michaelerule/LED_weaving/..bfg-report/2019-12-09/09-10-23/protected-dirt/cc569d0e-HEAD.csv

61e5d1c7dbbaa4ed608dc6567c271158b0dd6b1d | DELETE | executable | Project 3: Fibonacci/Writeup/20191104 Dreamcatcher (release)/VIDEO0072.mp4 | 269396218
f38d6ff7a80835ee2333962d0d1b2a934238b434 | DELETE | executable | Project 3: Fibonacci/Writeup/20191104 Dreamcatcher (release)/VIDEO0076.mp4 | 115131531
61e5d1c7dbbaa4ed608dc6567c271158b0dd6b1d | DELETE | executable | Writeup/photos/Project 3: LED dreamcatcher/VIDEO0072.mp4 | 269396218
f38d6ff7a80835ee2333962d0d1b2a934238b434 | DELETE | executable | Writeup/photos/Project 3: LED dreamcatcher/VIDEO0076.mp4 | 115131531
