michaelerule/LED_weaving/.git.bfg-report/2019-02-25/20-42-36/protected-dirt/aedcd762-HEAD.csv

65685d20780cc8def26f9c46963e8c464c0f4426 | DELETE | regular-file | Project 2: Marquee/Writeup/f1.svg | 30105499
4fec8187e474a769d8fa46a0383afd3dd0d0fe7a | DELETE | regular-file | Writeup/photos/Project 1: LED bead weaving/edited/animation5.gif | 11728317
