michaelerule/LED_weaving/..bfg-report/2020-03-28/19-55-57/protected-dirt/d19214ed-HEAD.csv

83906acb50e0e2a363e65743ea2123b663d665cb | DELETE | executable | Project 3: Fibonacci/Writeup/Photos/VIDEO0073.mp4 | 91048813
acd16d0e0093ec77f44cc03282107ef1aa04a825 | DELETE | executable | Project 3: Fibonacci/Writeup/Photos/VIDEO0075.mp4 | 61095710
f7d0cec78d43c73a415e5d8093270312c2abc51d | DELETE | executable | Project 3: Fibonacci/Writeup/Photos/VIDEO0077.mp4 | 53519259
