michaelerule/LED_weaving/..bfg-report/2020-03-28/18-09-38/protected-dirt/f6025158-HEAD.csv

61e5d1c7dbbaa4ed608dc6567c271158b0dd6b1d | DELETE | executable | Project 3: Fibonacci/Writeup/Photos/VIDEO0072.mp4 | 269396218
f38d6ff7a80835ee2333962d0d1b2a934238b434 | DELETE | executable | Project 3: Fibonacci/Writeup/Photos/VIDEO0076.mp4 | 115131531
f38d6ff7a80835ee2333962d0d1b2a934238b434 | DELETE | executable | Project 3: Fibonacci/Writeup/VIDEO0076.mp4 | 115131531
