michaelerule/LED_weaving/Project 1: Bead Weaving/Writeup/Photos/edited/IMAG0462.jpg

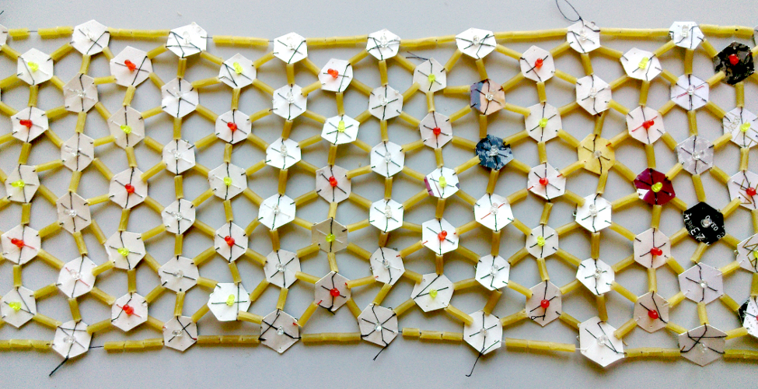
Project 1: Bead Weaving/Writeup/Photos/edited/IMAG0462.jpg
