michaelerule/LED_weaving/Project 1: Bead Weaving/Writeup/Photos/edited/IMAG0470_cropped.jpg

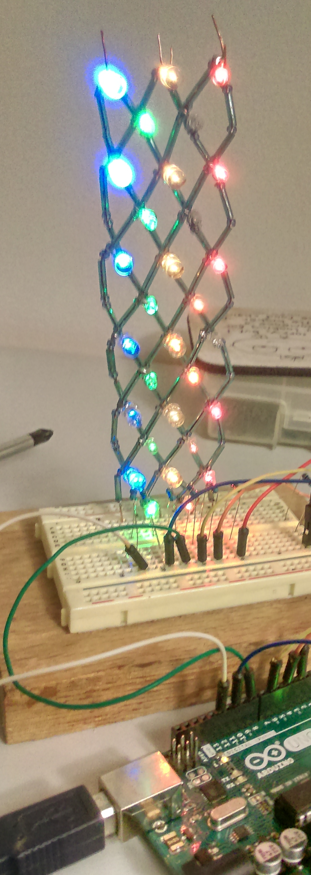
Project 1: Bead Weaving/Writeup/Photos/edited/IMAG0470_cropped.jpg
