michaelerule/LED_weaving/Project 1: Bead Weaving/Writeup/Photos/edited/IMAG0472.jpg

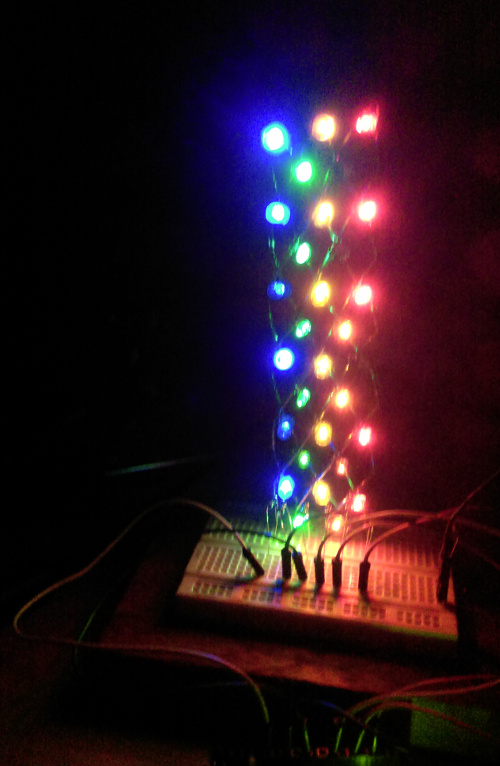
Project 1: Bead Weaving/Writeup/Photos/edited/IMAG0472.jpg
