michaelerule/LED_weaving/Project 1: Bead Weaving/Writeup/Photos/edited/IMAG0472_cropped.jpg

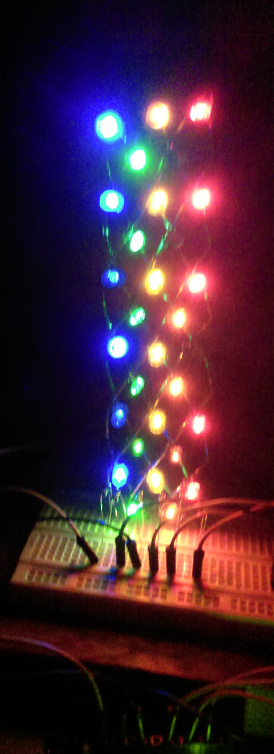
Project 1: Bead Weaving/Writeup/Photos/edited/IMAG0472_cropped.jpg
