michaelerule/LED_weaving/Project 1: Bead Weaving/Writeup/Photos/IMAG0472.jpg

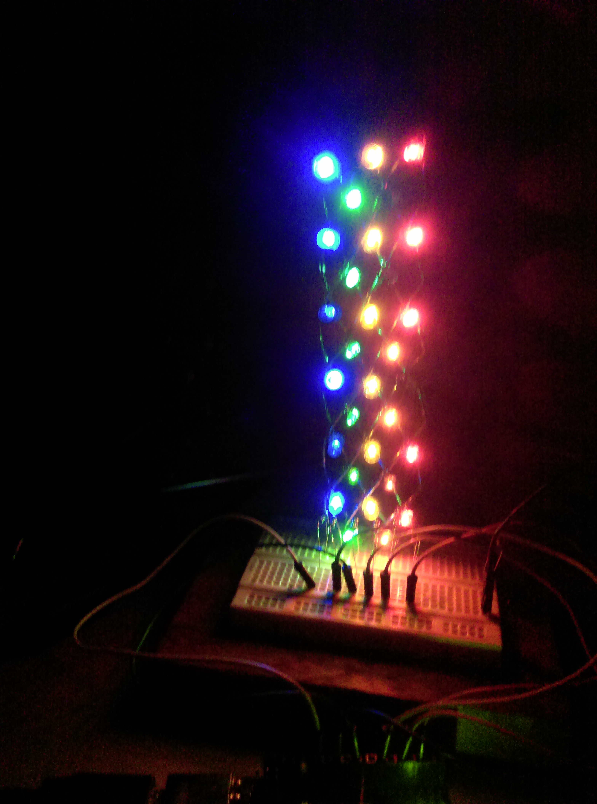
Project 1: Bead Weaving/Writeup/Photos/IMAG0472.jpg
