michaelerule/LED_weaving/Project 1: Bead Weaving/Writeup/Photos/IMAG0476.jpg

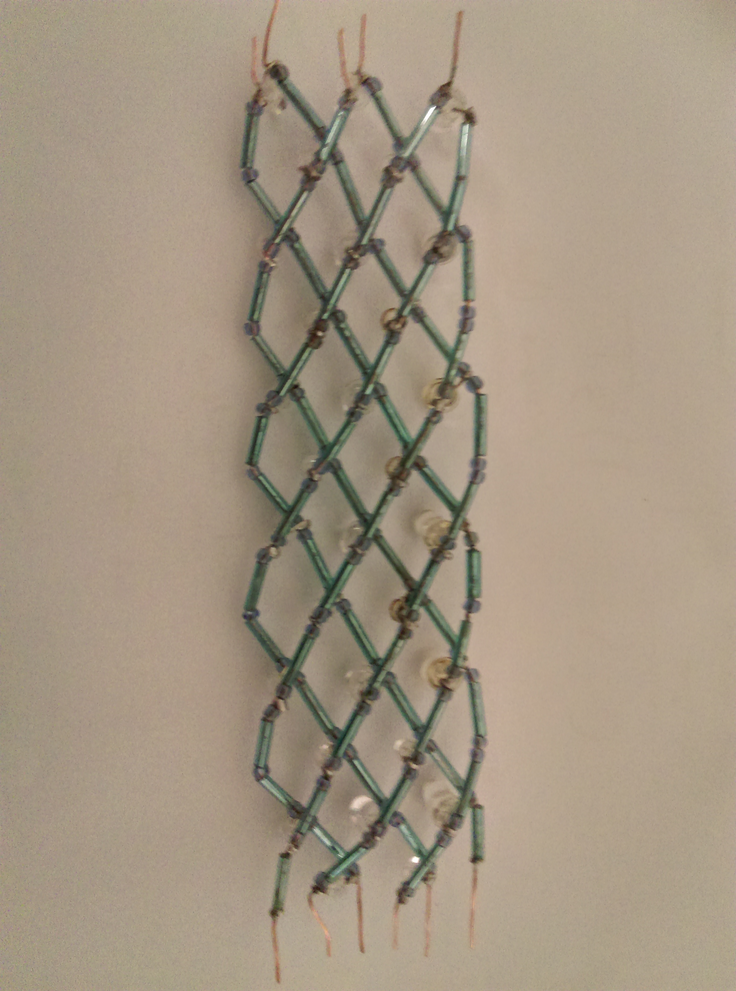
Project 1: Bead Weaving/Writeup/Photos/IMAG0476.jpg
