michaelerule/LED_weaving/Project 2: Marquee/Writeup/Photos/editing/gif_frames/heart/stabilized (copy)0108.png

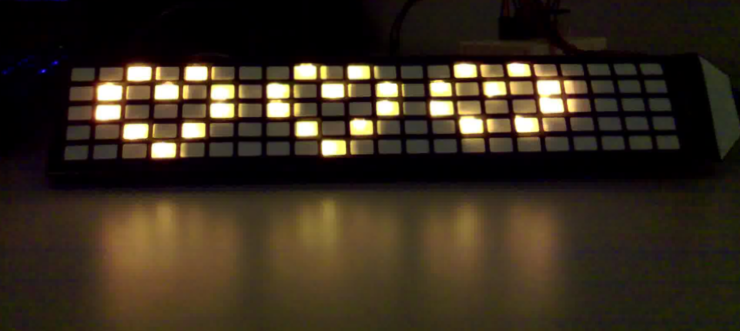
Project 2: Marquee/Writeup/Photos/editing/gif_frames/heart/stabilized (copy)0108.png
