michaelerule/LED_weaving/Project 2: Marquee/Writeup/Photos/editing/gif_frames/title/stabilized (copy)0045.png

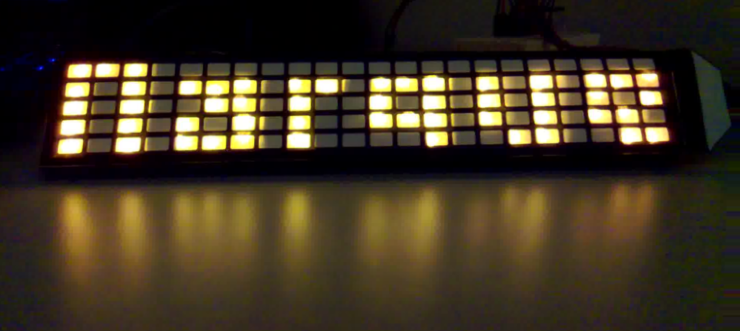
Project 2: Marquee/Writeup/Photos/editing/gif_frames/title/stabilized (copy)0045.png
