michaelerule/LED_weaving/Project 2: Marquee/Writeup/Photos/editing/gif_frames/title/stabilized (copy)0051.png

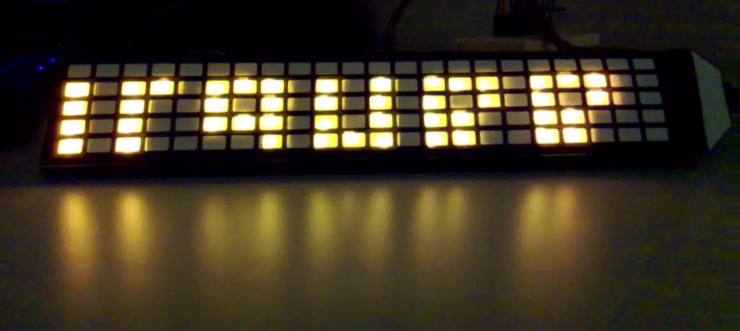
Project 2: Marquee/Writeup/Photos/editing/gif_frames/title/stabilized (copy)0051.png
