michaelerule/LED_weaving/Project 2: Marquee/Writeup/Photos/editing/gif_frames/title/stabilized (copy)0072.png

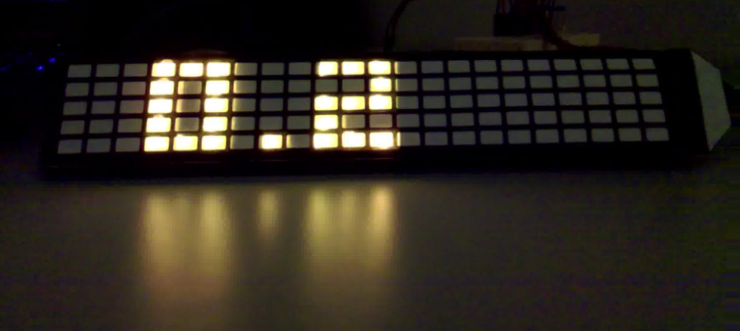
Project 2: Marquee/Writeup/Photos/editing/gif_frames/title/stabilized (copy)0072.png
