michaelerule/LED_weaving/Project 2: Marquee/Writeup/Photos/editing/IMAG0496.jpg

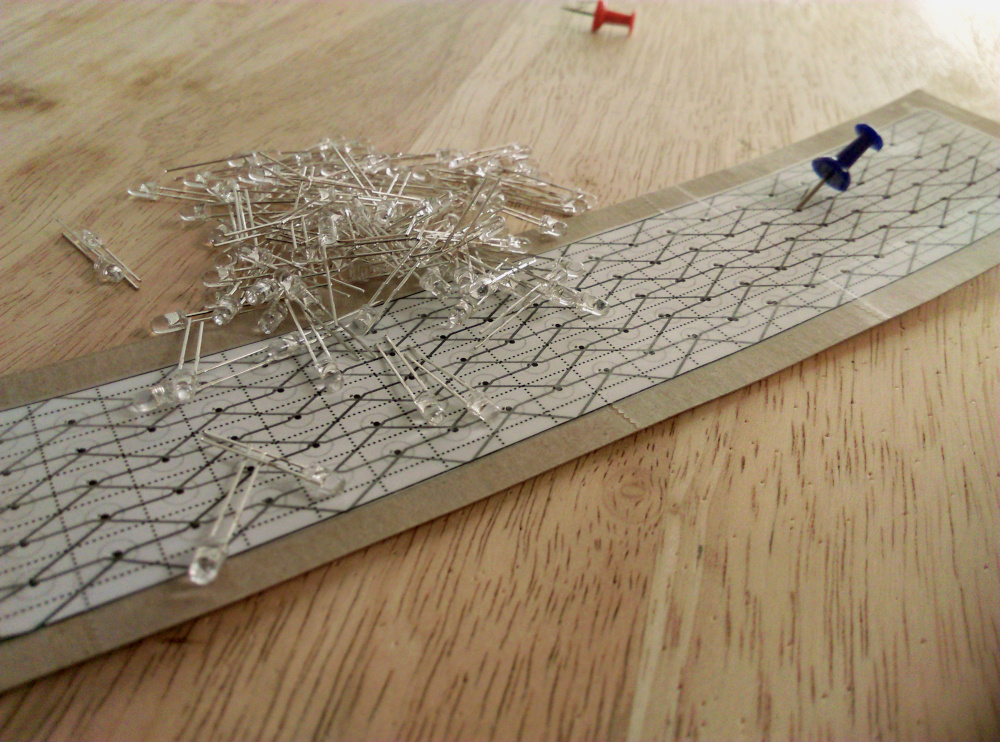
Project 2: Marquee/Writeup/Photos/editing/IMAG0496.jpg
