michaelerule/LED_weaving/Project 2: Marquee/Writeup/Photos/editing/IMAG0497.jpg

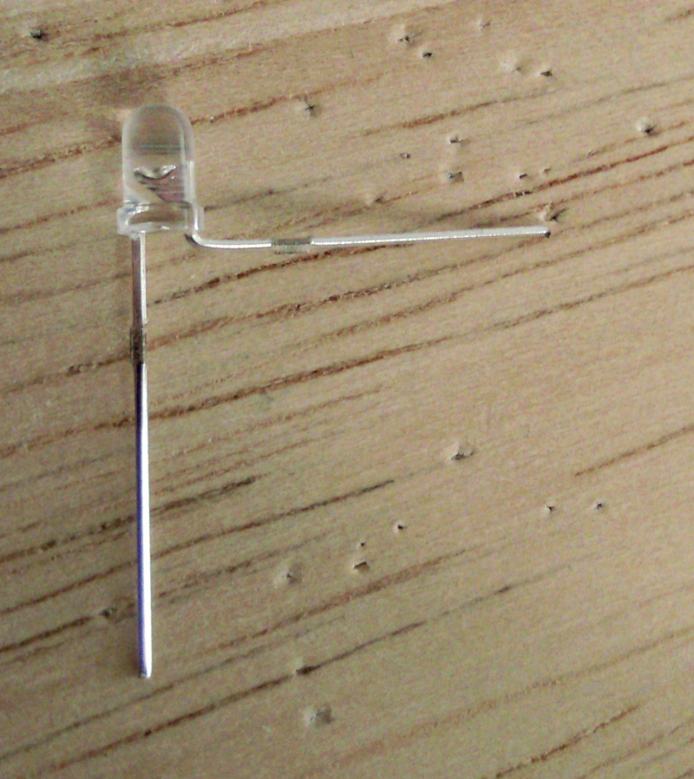
Project 2: Marquee/Writeup/Photos/editing/IMAG0497.jpg
