michaelerule/LED_weaving/Project 2: Marquee/Writeup/Photos/editing/IMAG0499.jpg

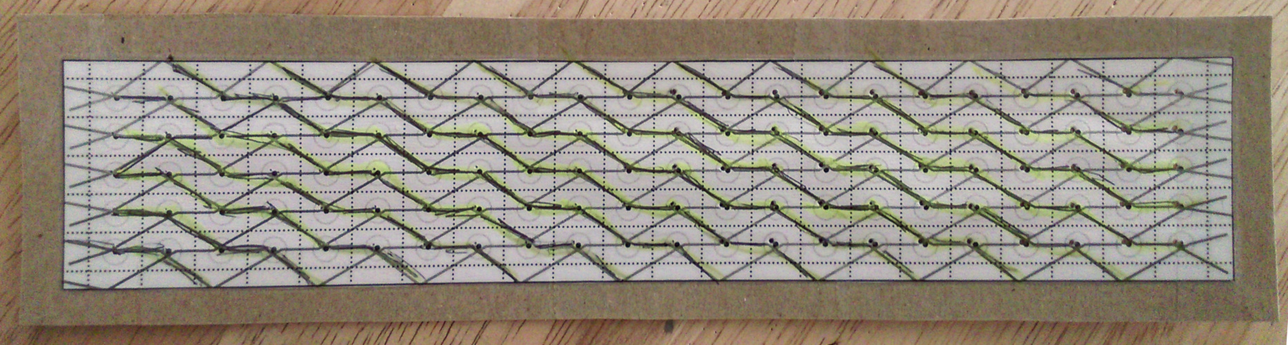
Project 2: Marquee/Writeup/Photos/editing/IMAG0499.jpg
