michaelerule/LED_weaving/Project 2: Marquee/Writeup/Photos/editing/IMAG0511.jpg

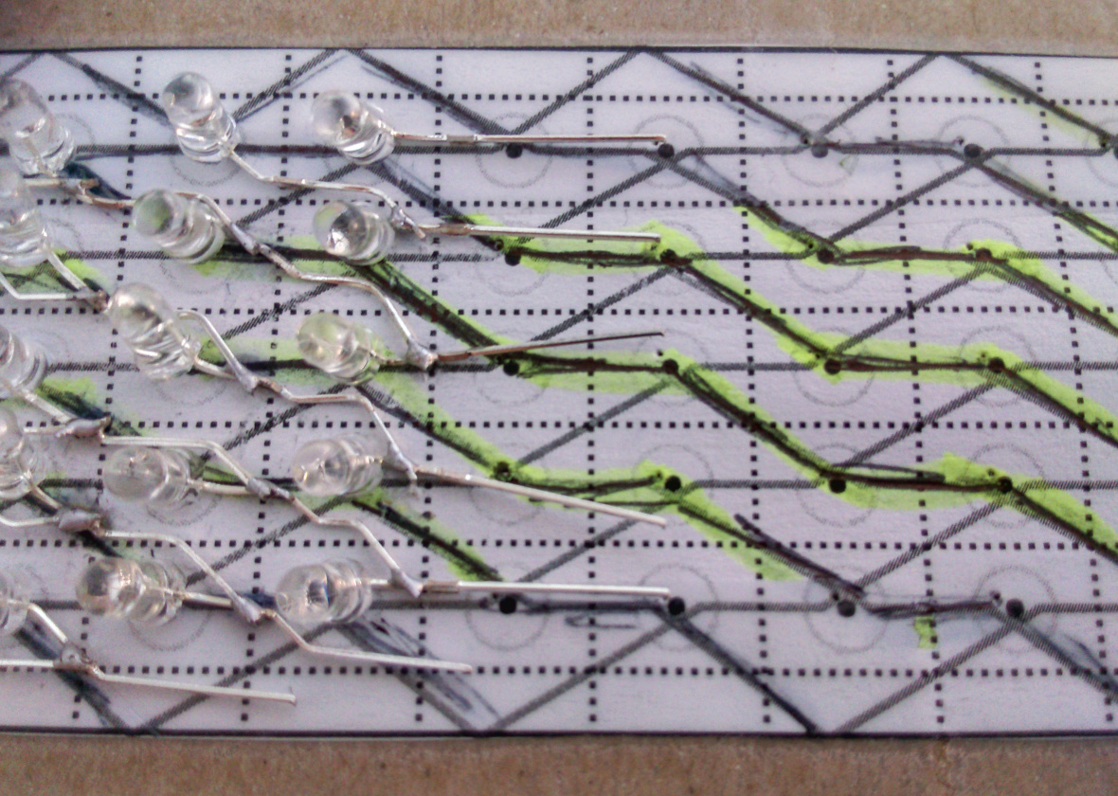
Project 2: Marquee/Writeup/Photos/editing/IMAG0511.jpg
