michaelerule/LED_weaving/Project 2: Marquee/Writeup/Photos/editing/IMAG0522.jpg

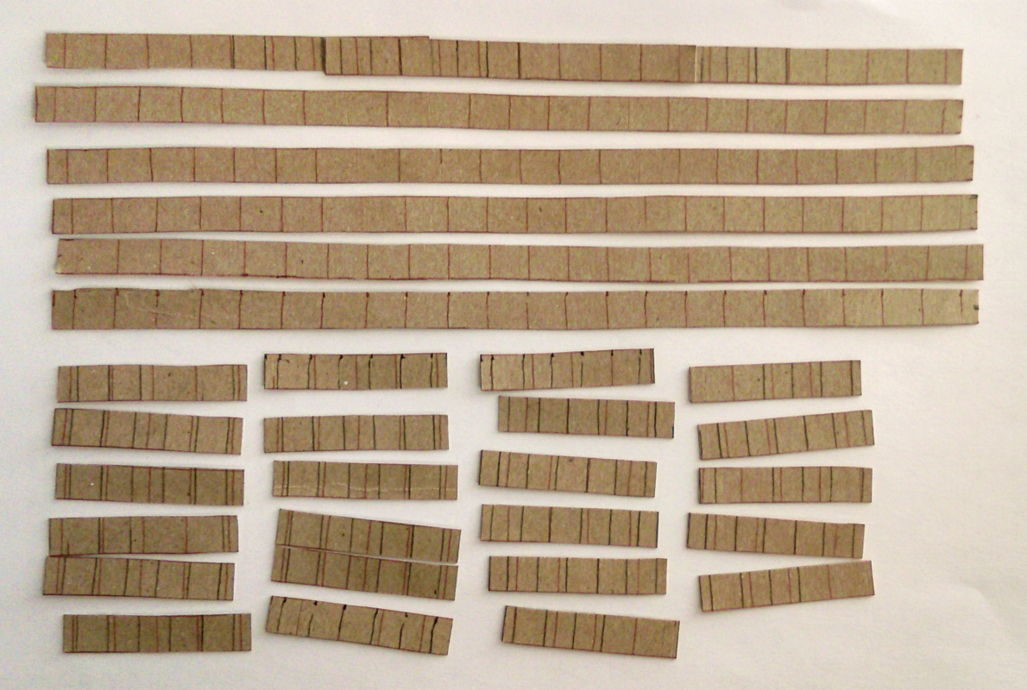
Project 2: Marquee/Writeup/Photos/editing/IMAG0522.jpg
