michaelerule/LED_weaving/Project 2: Marquee/Writeup/Photos/IMAG0493.jpg

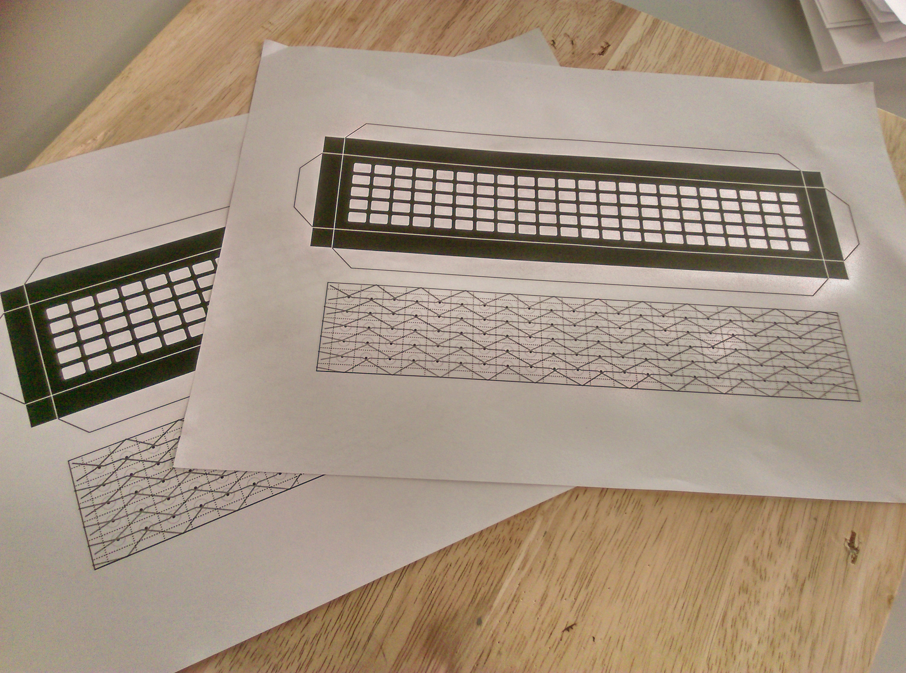
Project 2: Marquee/Writeup/Photos/IMAG0493.jpg
