michaelerule/LED_weaving/Project 2: Marquee/Writeup/Photos/IMAG0495.jpg

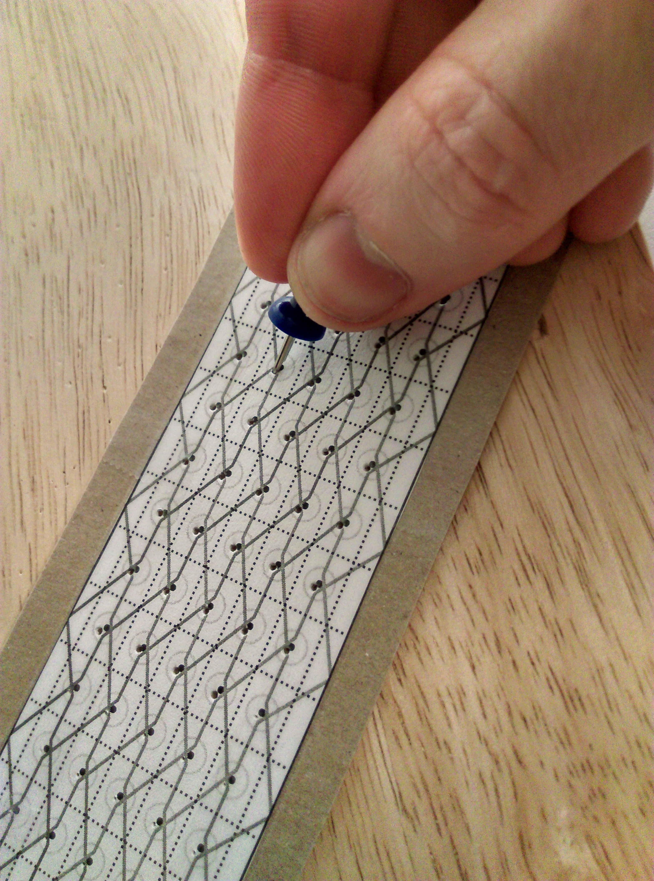
Project 2: Marquee/Writeup/Photos/IMAG0495.jpg
