michaelerule/LED_weaving/Project 2: Marquee/Writeup/Photos/IMAG0506.jpg

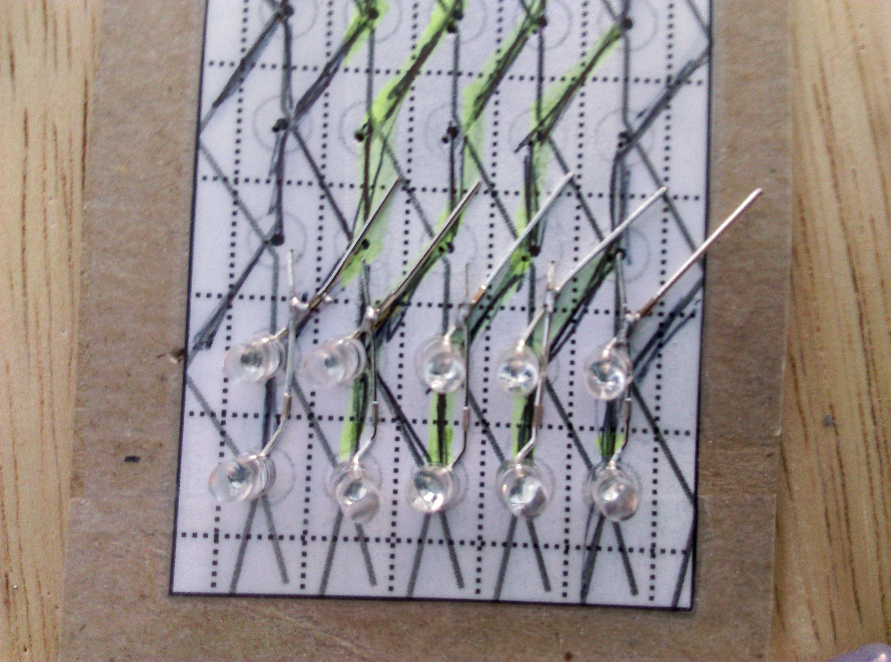
Project 2: Marquee/Writeup/Photos/IMAG0506.jpg
