michaelerule/LED_weaving/Project 2: Marquee/Writeup/Photos/IMAG0509.jpg

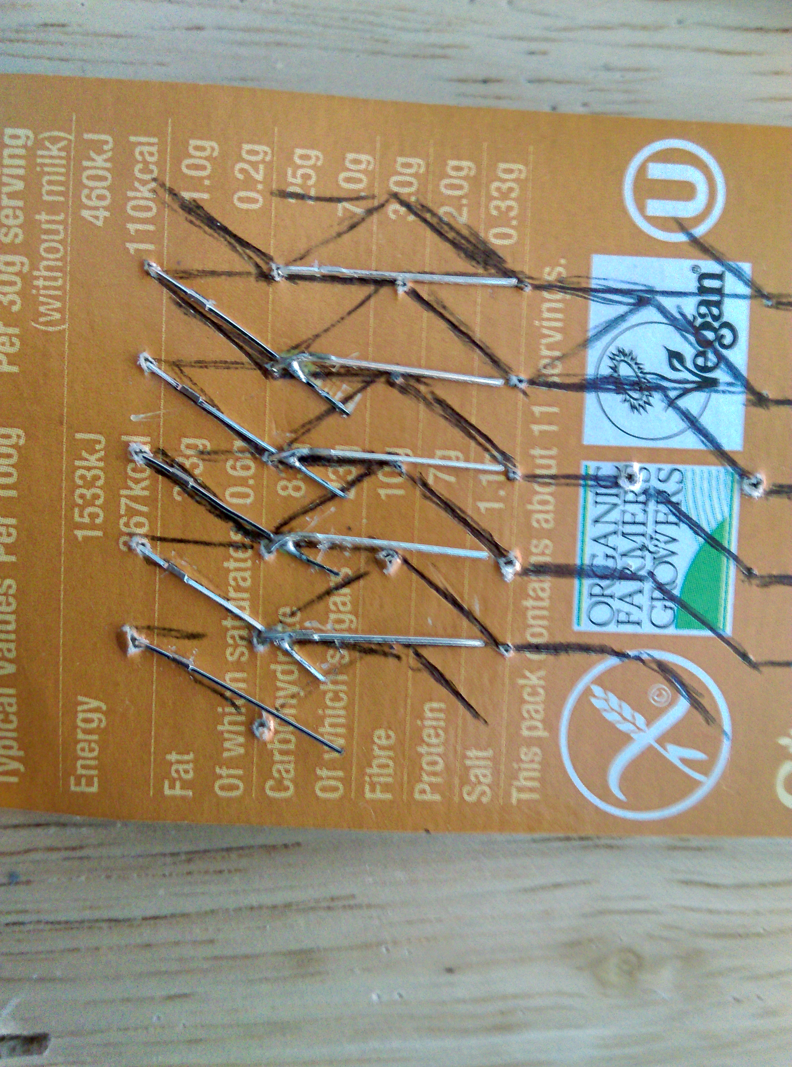
Project 2: Marquee/Writeup/Photos/IMAG0509.jpg
