michaelerule/LED_weaving/Project 2: Marquee/Writeup/Photos/IMAG0511.jpg

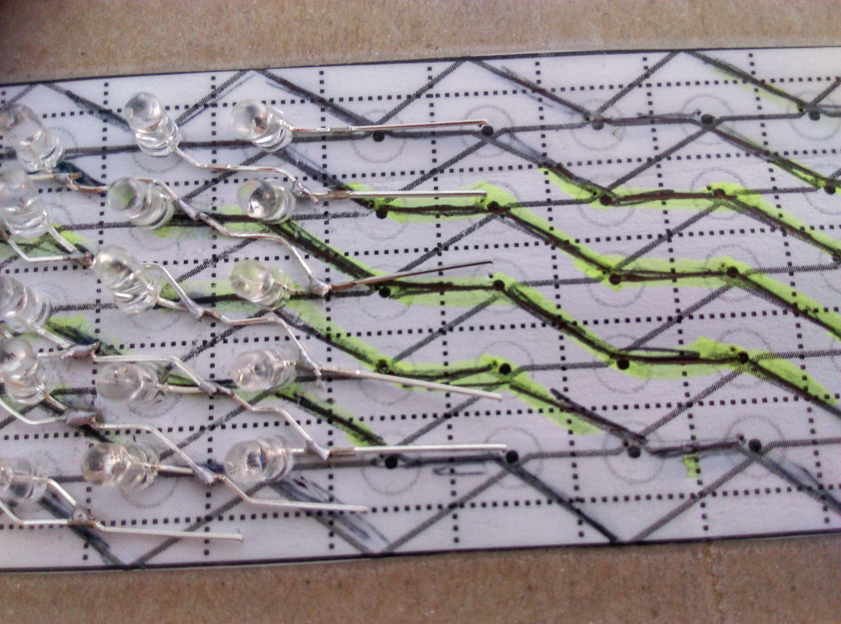
Project 2: Marquee/Writeup/Photos/IMAG0511.jpg
