michaelerule/LED_weaving/Project 2: Marquee/Writeup/Photos/IMAG0515.jpg

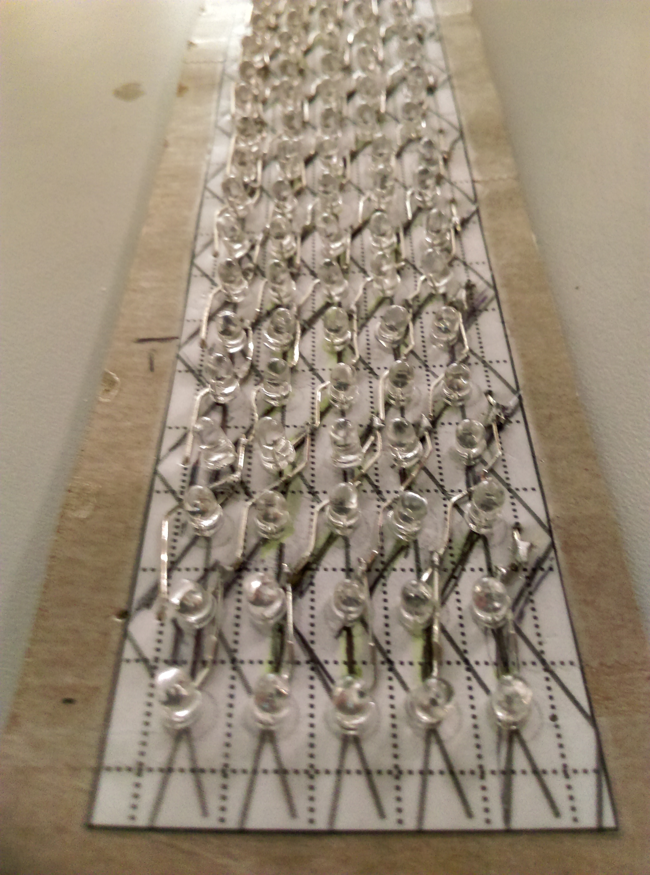
Project 2: Marquee/Writeup/Photos/IMAG0515.jpg
