michaelerule/LED_weaving/Project 3: Fibonacci/Writeup/Figures/20190104_Dreamcatcher_7.png

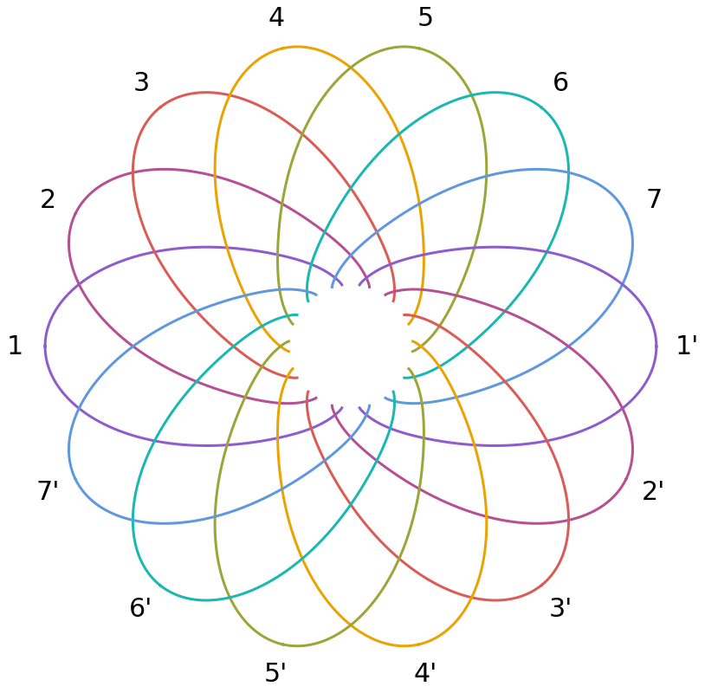
Project 3: Fibonacci/Writeup/Figures/20190104_Dreamcatcher_7.png
