michaelerule/LED_weaving/Project 3: Fibonacci/Writeup/Figures/20190104_Dreamcatcher_10.png

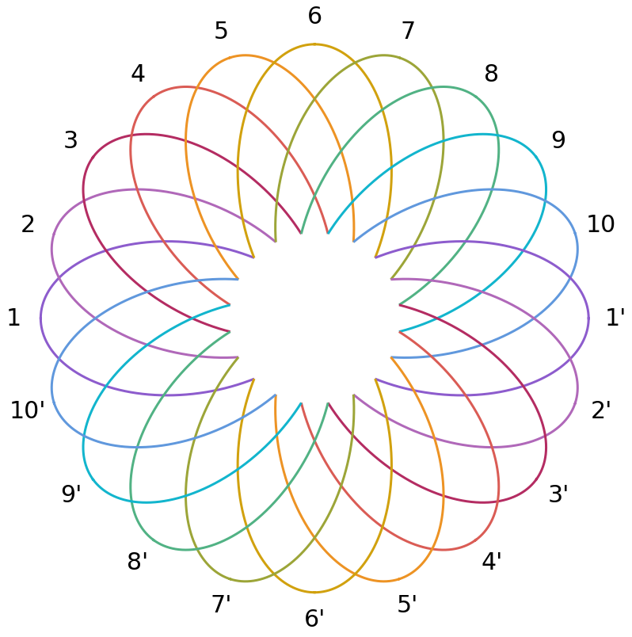
Project 3: Fibonacci/Writeup/Figures/20190104_Dreamcatcher_10.png
