michaelerule/LED_weaving/Project 3: Fibonacci/Writeup/Figures/20190104_Dreamcatcher_11.png

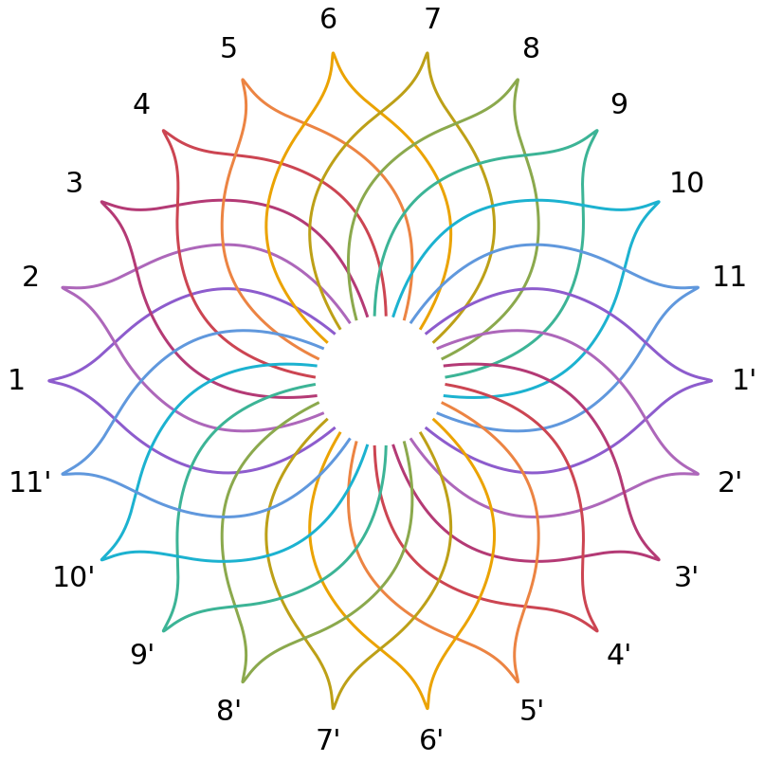
Project 3: Fibonacci/Writeup/Figures/20190104_Dreamcatcher_11.png
