michaelerule/LED_weaving/Project 3: Fibonacci/Writeup/Figures/20190104_Dreamcatcher_19.png

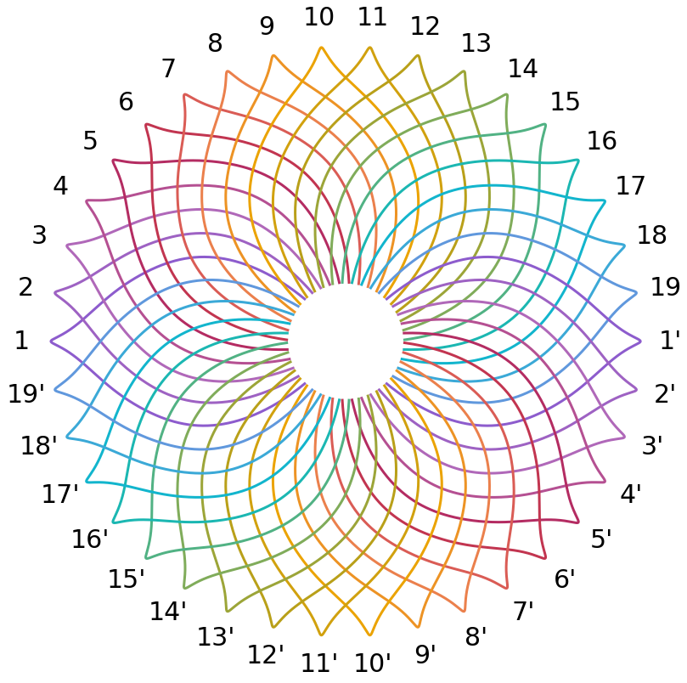
Project 3: Fibonacci/Writeup/Figures/20190104_Dreamcatcher_19.png
