michaelerule/LED_weaving/Project 3: Fibonacci/Writeup/Figures/20190105_Dreamcatcher_13.png

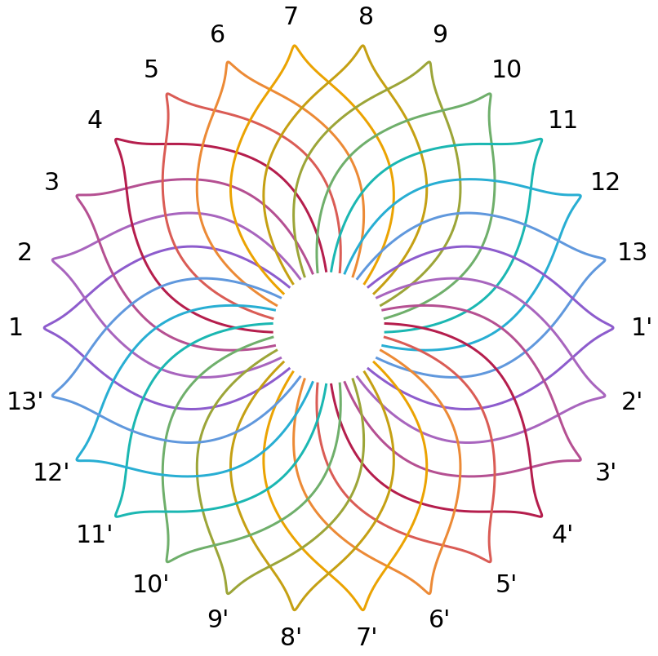
Project 3: Fibonacci/Writeup/Figures/20190105_Dreamcatcher_13.png
