michaelerule/LED_weaving/Project 3: Fibonacci/Writeup/Figures/20190206_Sunflower1.png

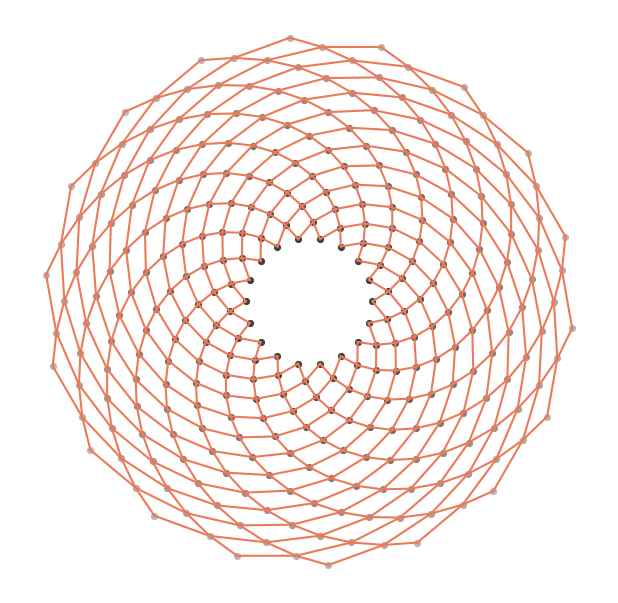
Project 3: Fibonacci/Writeup/Figures/20190206_Sunflower1.png
