michaelerule/LED_weaving/Project 3: Fibonacci/Writeup/Figures/20190207_Sunflower_illustration_cylinder.png

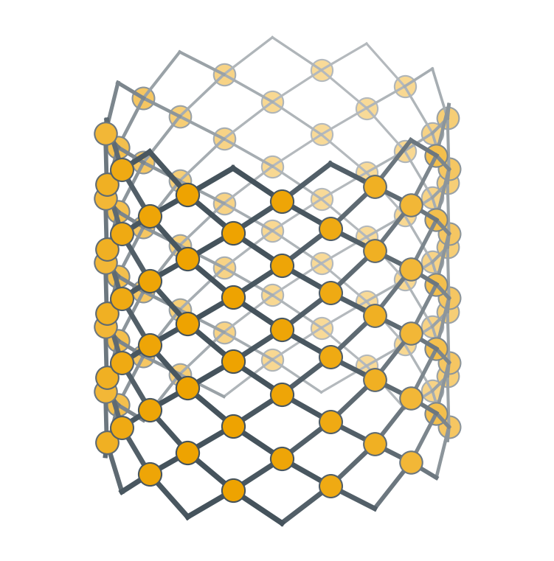
Project 3: Fibonacci/Writeup/Figures/20190207_Sunflower_illustration_cylinder.png
