michaelerule/LED_weaving/Project 3: Fibonacci/Writeup/Figures/20190208_Sunflower_illustration.png

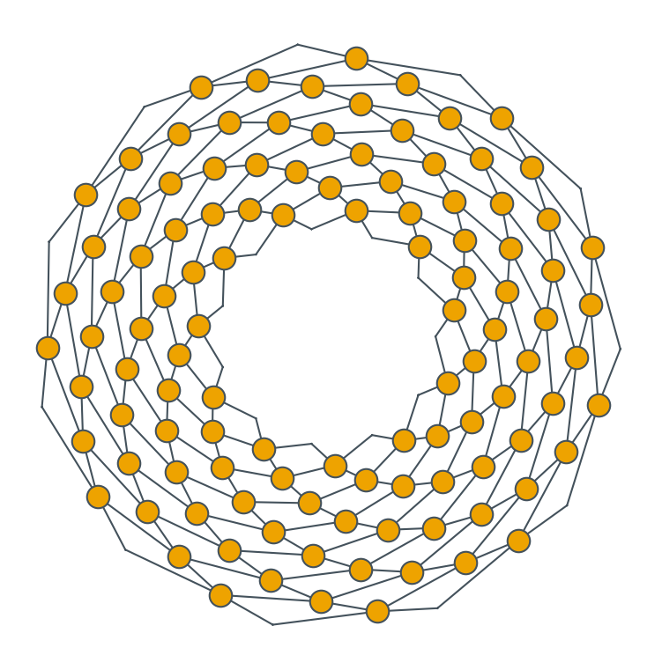
Project 3: Fibonacci/Writeup/Figures/20190208_Sunflower_illustration.png
