michaelerule/LED_weaving/Project 3: Fibonacci/Writeup/Photos/IMAG0483.jpg

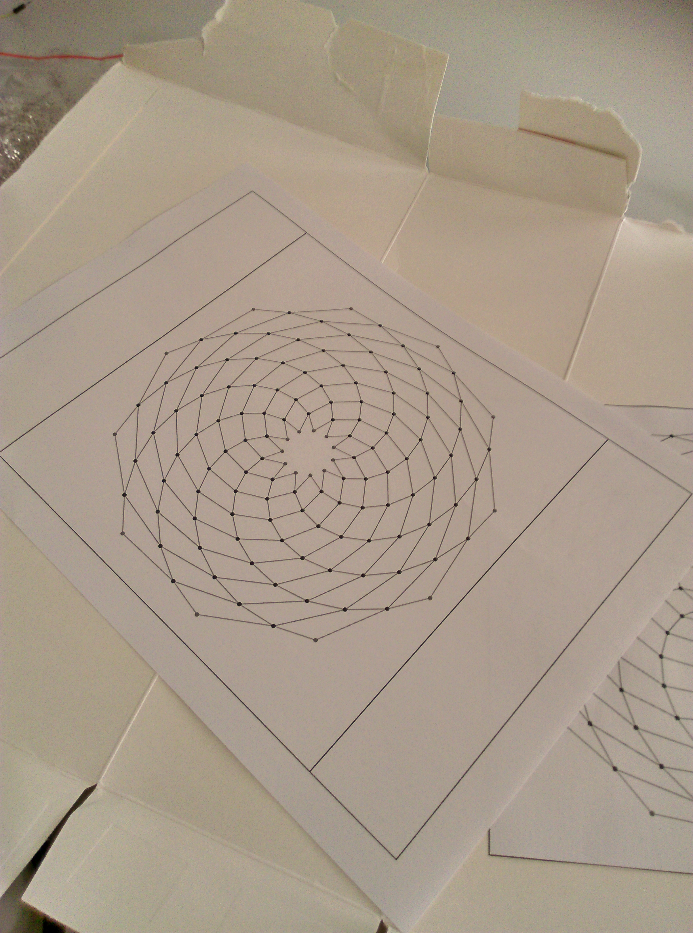
Project 3: Fibonacci/Writeup/Photos/IMAG0483.jpg
