michaelerule/LED_weaving/Project 3: Fibonacci/Writeup/Photos/IMAG0485.jpg

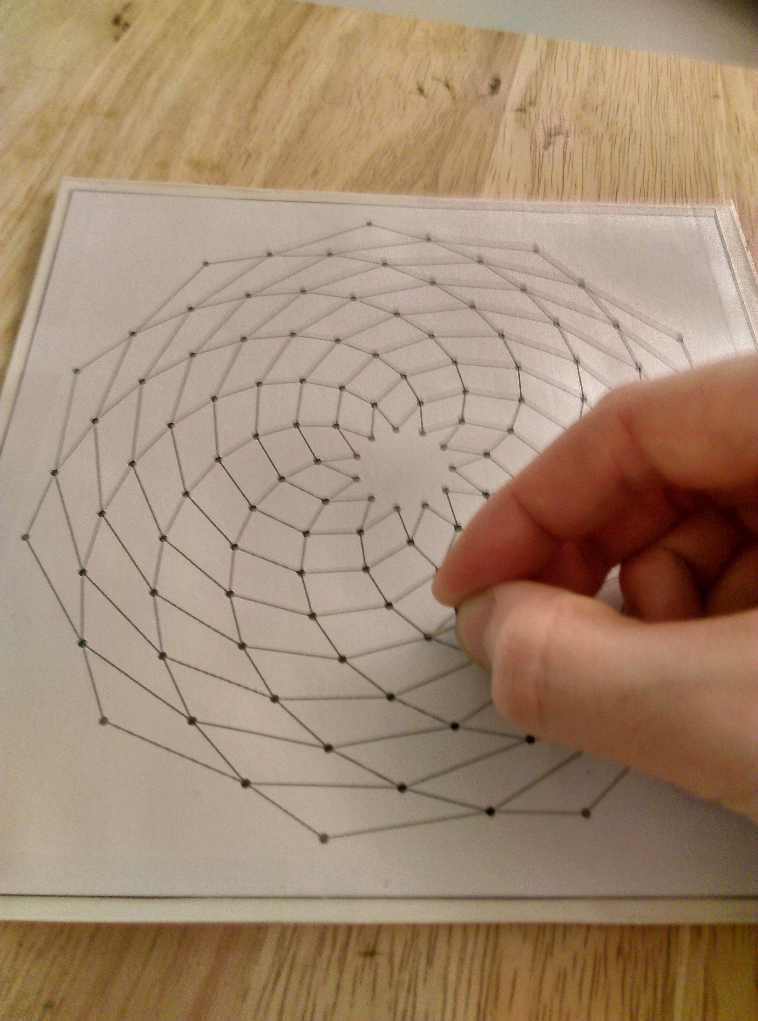
Project 3: Fibonacci/Writeup/Photos/IMAG0485.jpg
