michaelerule/LED_weaving/Project 3: Fibonacci/Writeup/Photos/IMAG0488.jpg

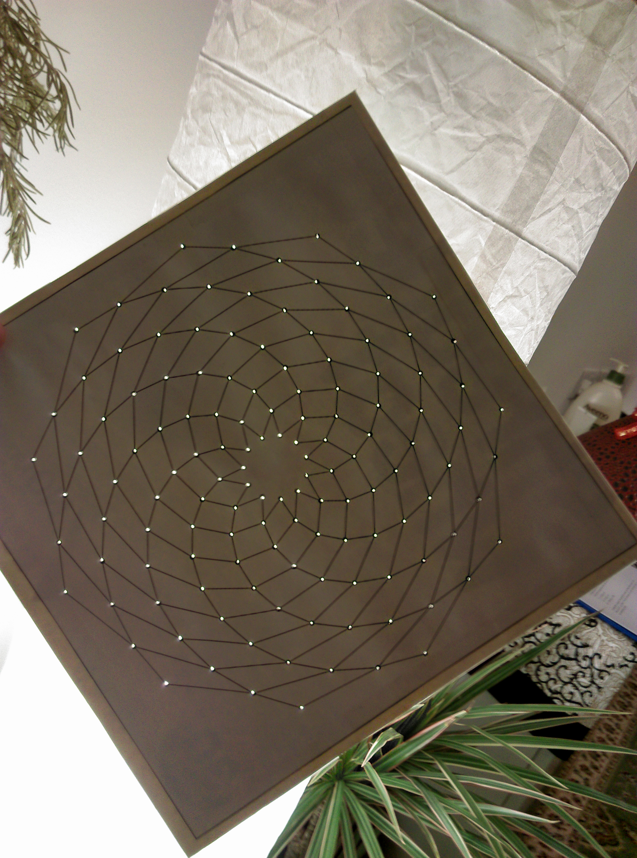
Project 3: Fibonacci/Writeup/Photos/IMAG0488.jpg
