michaelerule/LED_weaving/Project 3: Fibonacci/Writeup/Photos/IMAG0489.jpg

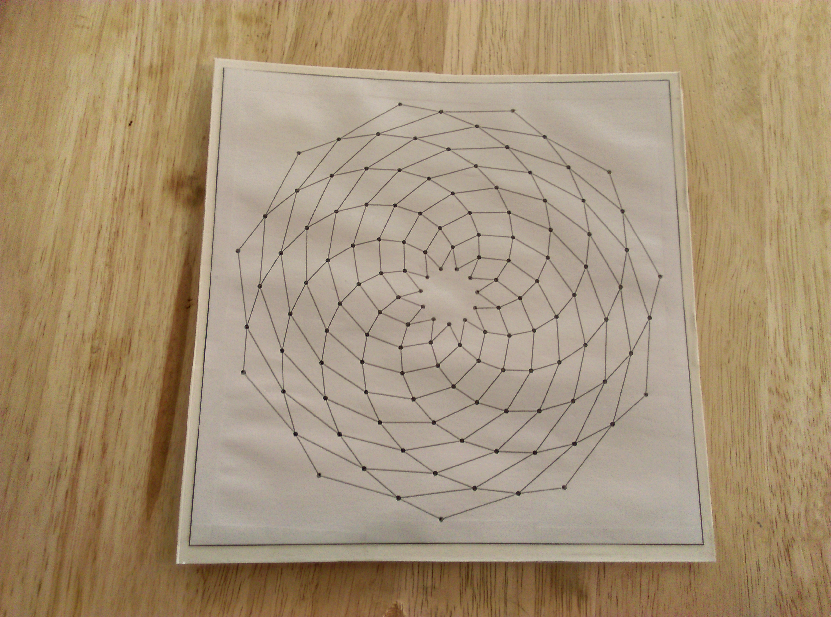
Project 3: Fibonacci/Writeup/Photos/IMAG0489.jpg
