michaelerule/LED_weaving/Project 3: Fibonacci/Writeup/Photos/IMAG0490.jpg

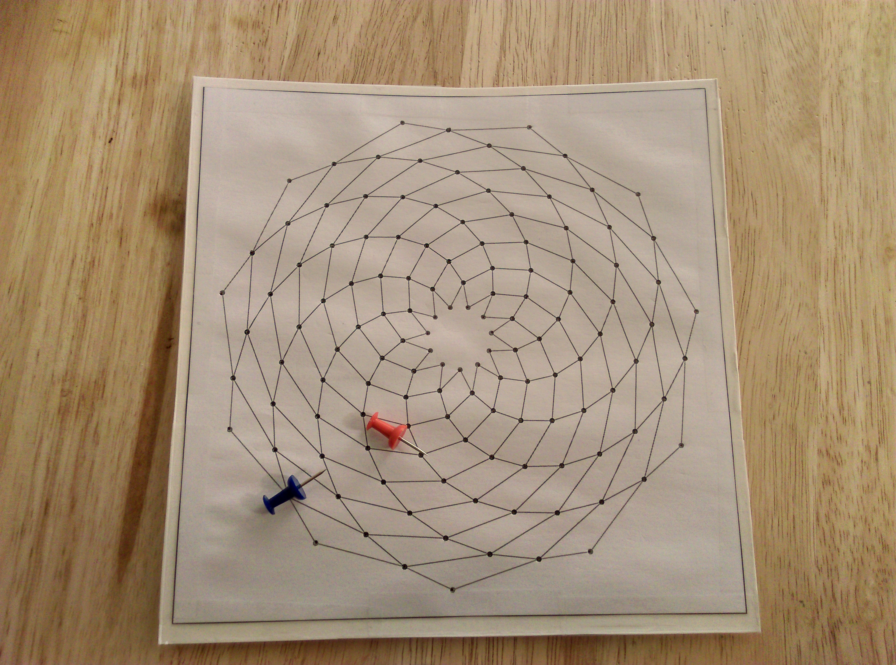
Project 3: Fibonacci/Writeup/Photos/IMAG0490.jpg
