michaelerule/LED_weaving/Project 3: Fibonacci/Writeup/Photos/IMAG1646.jpg

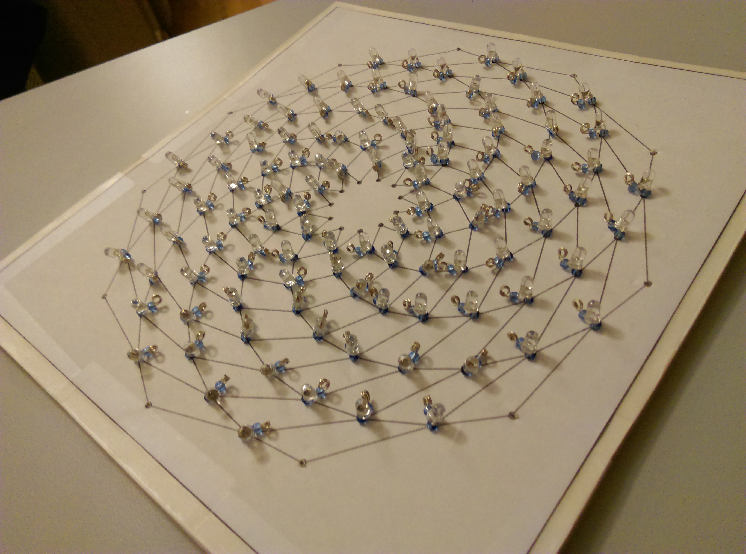
Project 3: Fibonacci/Writeup/Photos/IMAG1646.jpg
