michaelerule/LED_weaving/Project 3: Fibonacci/Writeup/Photos/IMAG1649.jpg

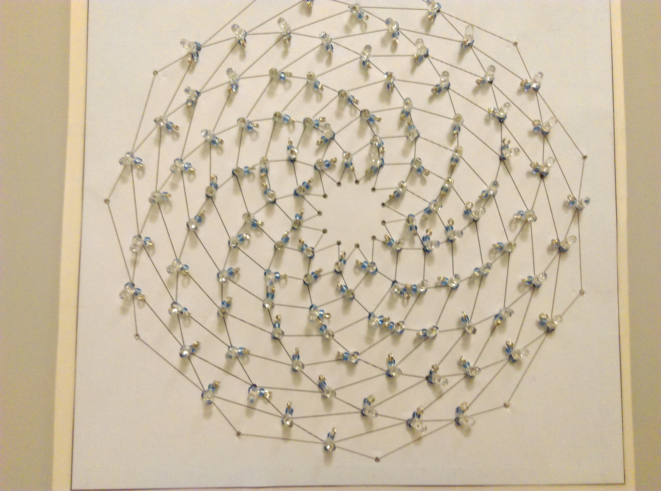
Project 3: Fibonacci/Writeup/Photos/IMAG1649.jpg
