michaelerule/LED_weaving/Project 3: Fibonacci/Writeup/Photos/IMAG1652.jpg

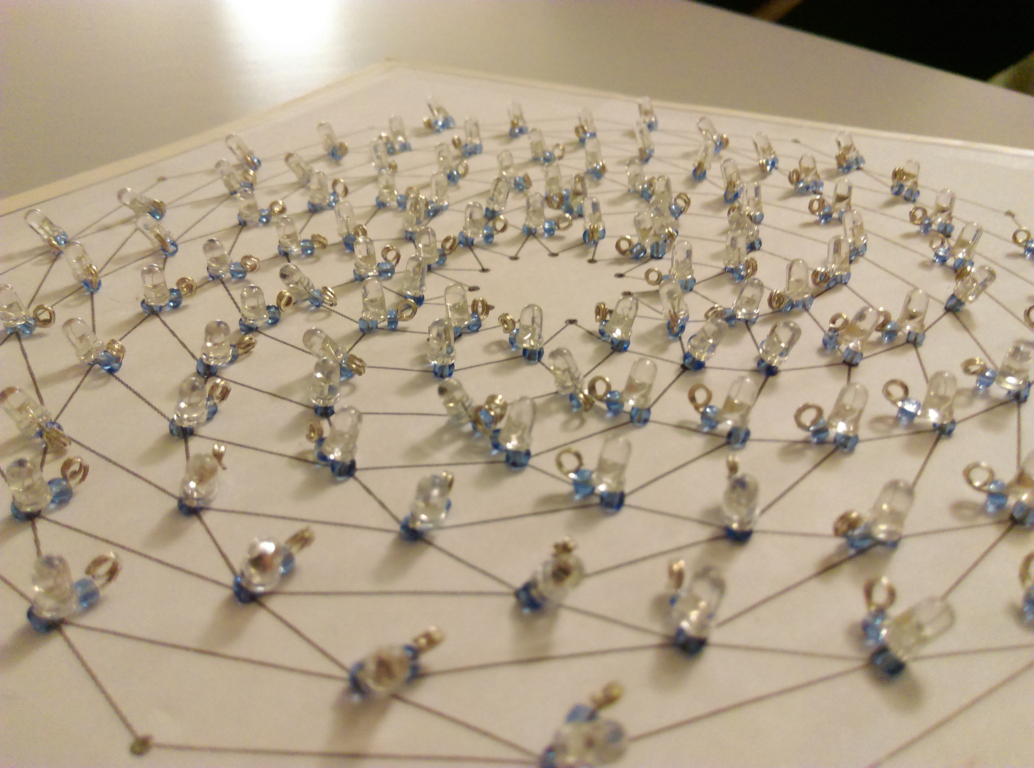
Project 3: Fibonacci/Writeup/Photos/IMAG1652.jpg
