michaelerule/LED_weaving/Project 3: Fibonacci/Writeup/Photos/IMAG1655.jpg

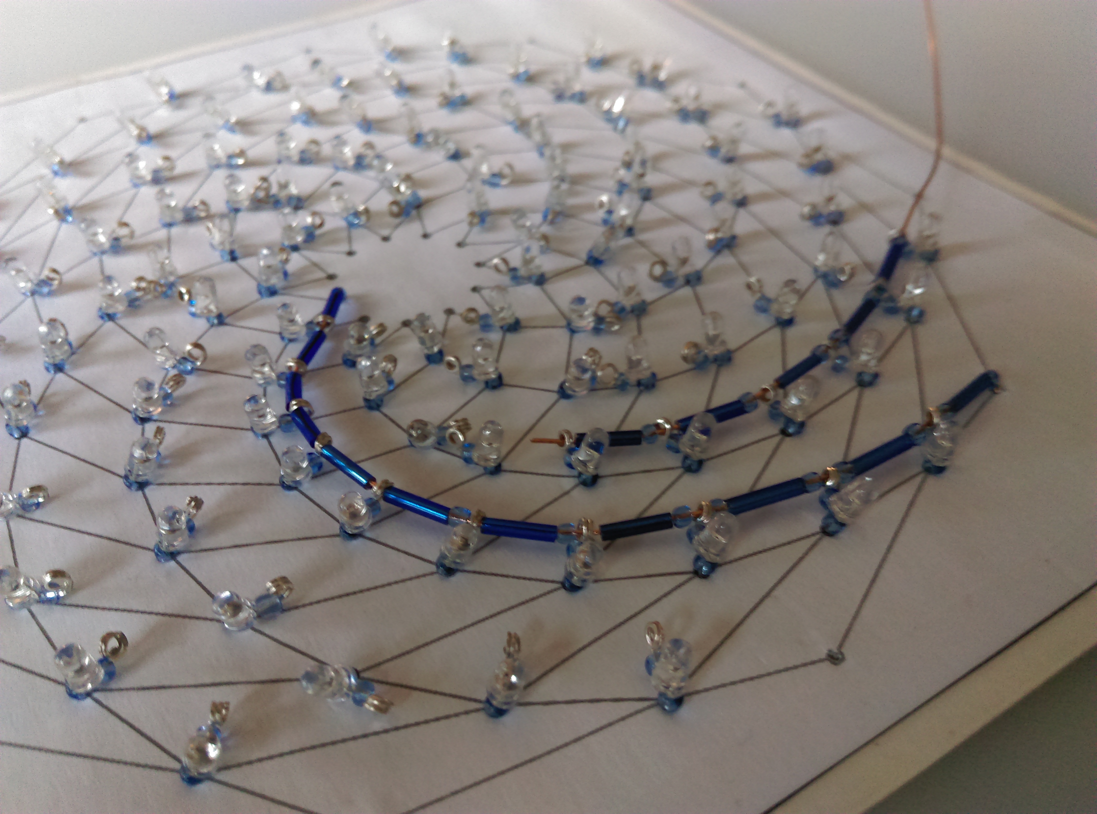
Project 3: Fibonacci/Writeup/Photos/IMAG1655.jpg
