michaelerule/LED_weaving/Project 3: Fibonacci/Writeup/Photos/IMAG1667.jpg

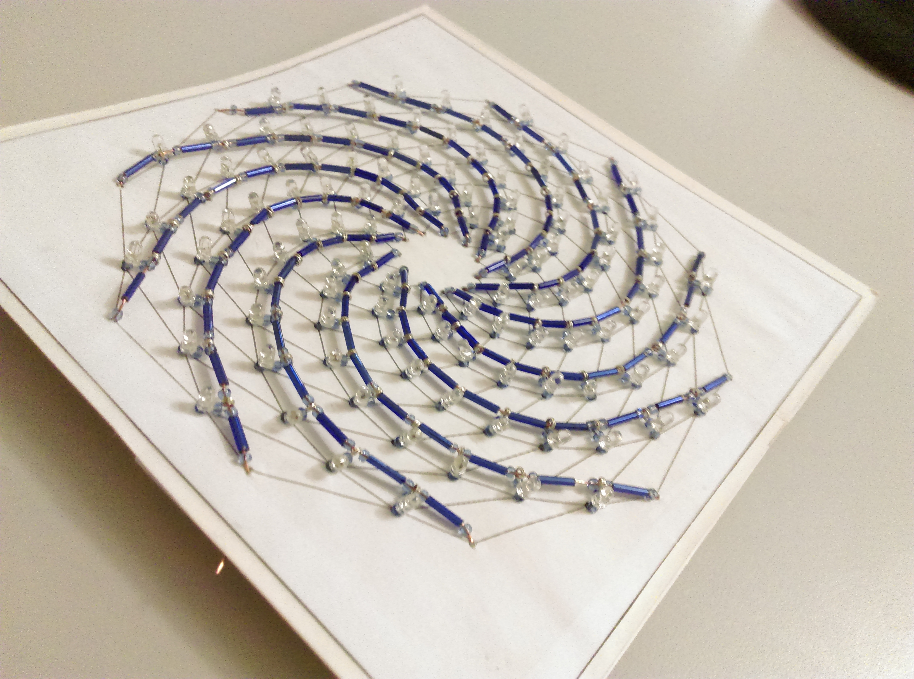
Project 3: Fibonacci/Writeup/Photos/IMAG1667.jpg
