michaelerule/LED_weaving/Project 3: Fibonacci/Writeup/Photos/IMAG1668.jpg

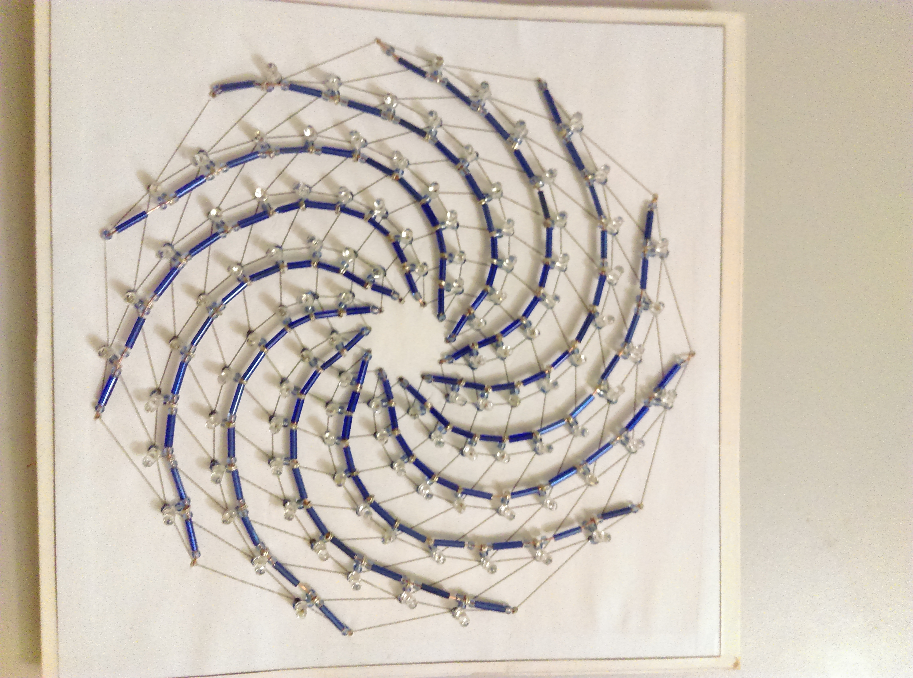
Project 3: Fibonacci/Writeup/Photos/IMAG1668.jpg
