michaelerule/LED_weaving/Project 3: Fibonacci/Writeup/Photos/IMAG1689_BURST008.jpg

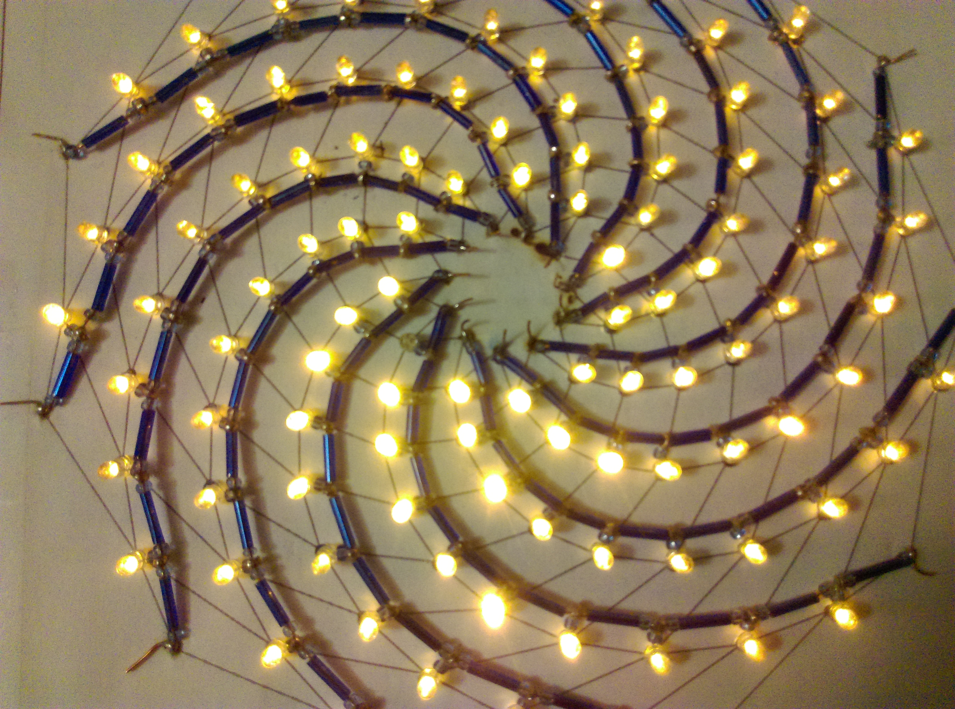
Project 3: Fibonacci/Writeup/Photos/IMAG1689_BURST008.jpg
