michaelerule/LED_weaving/Project 3: Fibonacci/Writeup/Photos/IMAG1689_BURST018.jpg

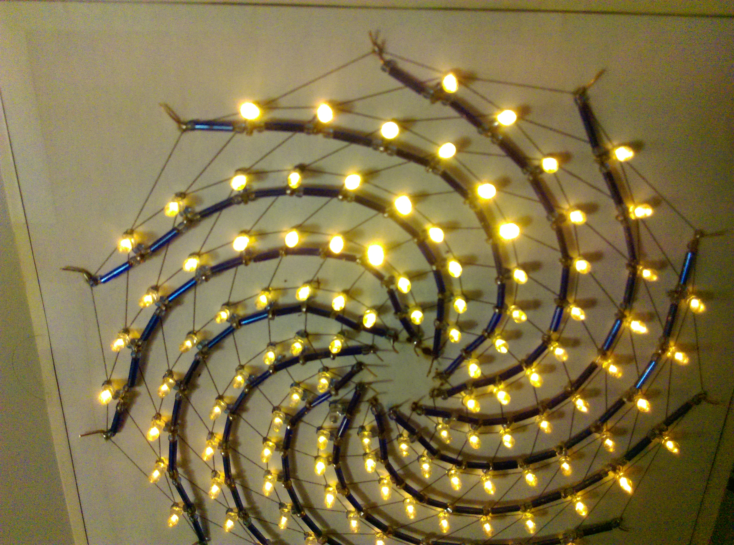
Project 3: Fibonacci/Writeup/Photos/IMAG1689_BURST018.jpg
