michaelerule/LED_weaving/Project 3: Fibonacci/Writeup/Photos/IMAG1690_BURST019.jpg

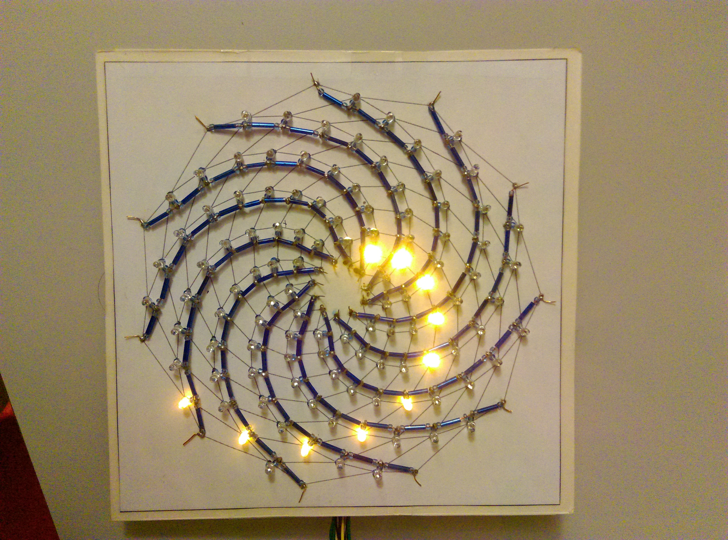
Project 3: Fibonacci/Writeup/Photos/IMAG1690_BURST019.jpg
