michaelerule/LED_weaving/Project 3: Fibonacci/Writeup/Photos/IMAG1697.jpg

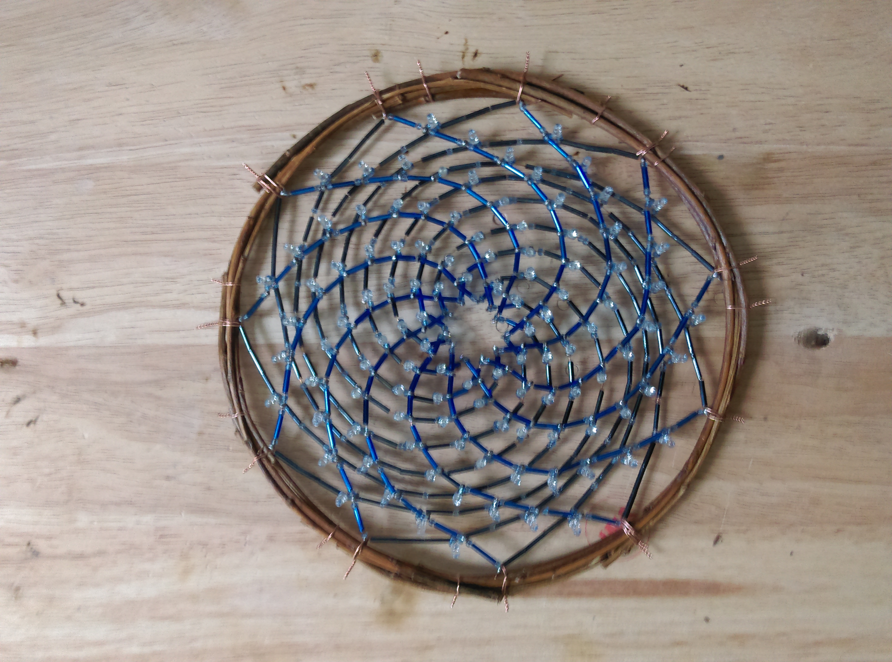
Project 3: Fibonacci/Writeup/Photos/IMAG1697.jpg
