michaelerule/LED_weaving/Project 3: Fibonacci/Writeup/Photos/IMAG1698.jpg

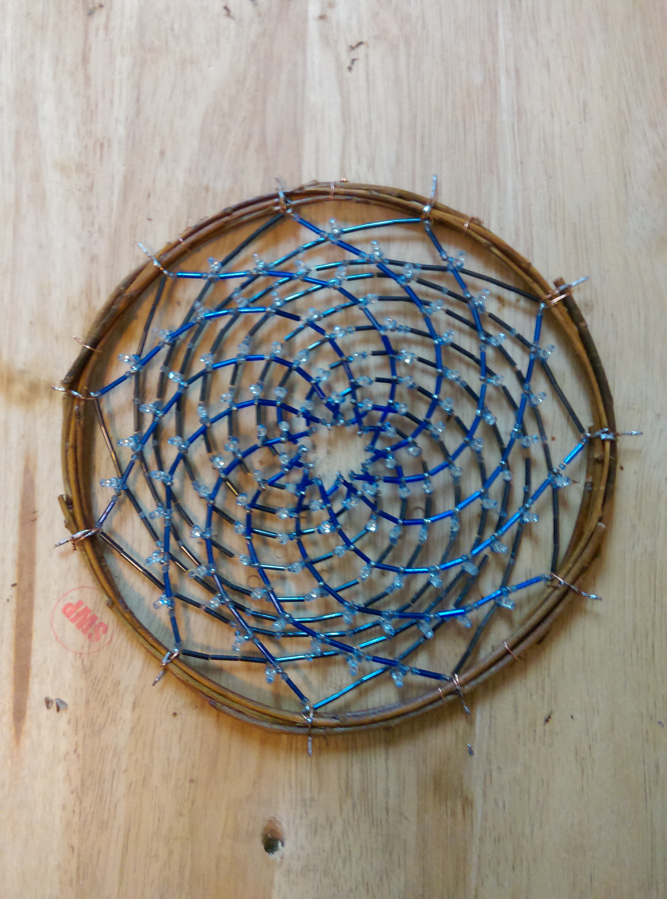
Project 3: Fibonacci/Writeup/Photos/IMAG1698.jpg
