michaelerule/LED_weaving/Project 3: Fibonacci/Writeup/Photos/IMAG1700.jpg

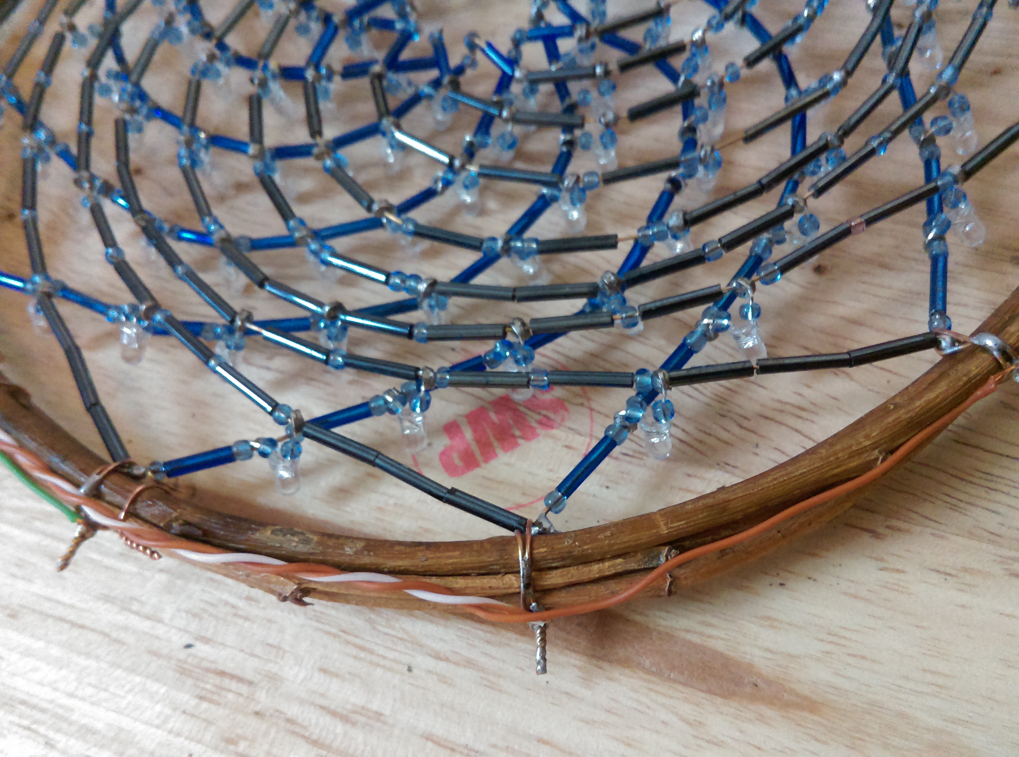
Project 3: Fibonacci/Writeup/Photos/IMAG1700.jpg
