michaelerule/LED_weaving/Project 3: Fibonacci/Writeup/Photos/IMAG1704.jpg

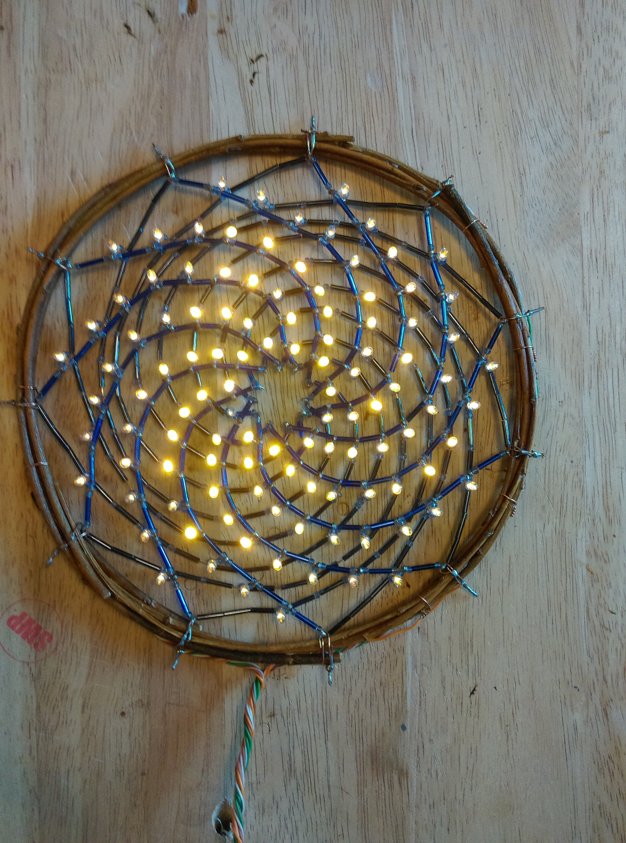
Project 3: Fibonacci/Writeup/Photos/IMAG1704.jpg
