michaelerule/LED_weaving/Project 3: Fibonacci/Writeup/Photos/IMAG1706.jpg

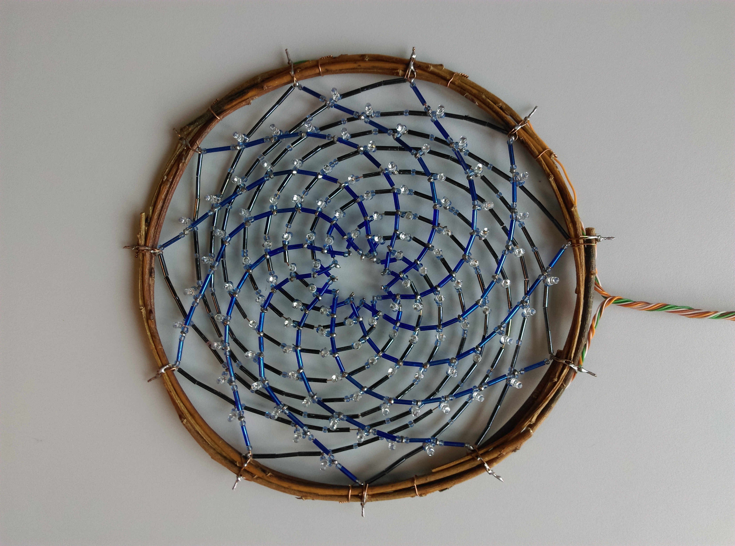
Project 3: Fibonacci/Writeup/Photos/IMAG1706.jpg
