michaelerule/LED_weaving/Project 3: Fibonacci/Writeup/Photos/IMAG1709.jpg

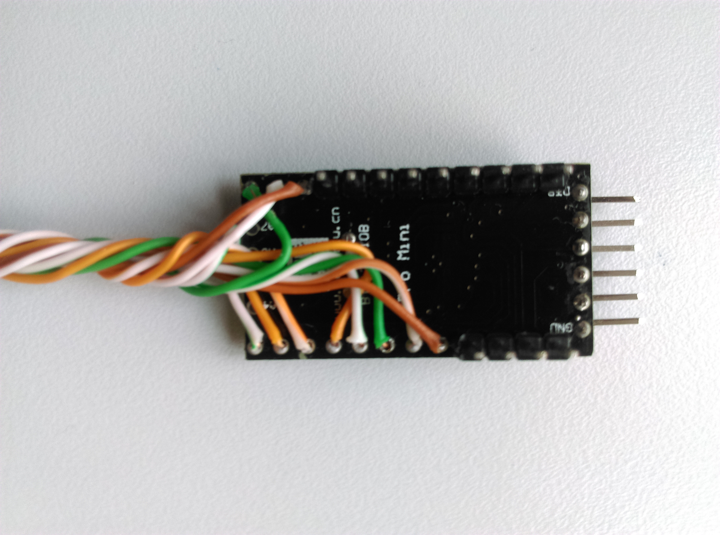
Project 3: Fibonacci/Writeup/Photos/IMAG1709.jpg
