michaelerule/LED_weaving/Project 3: Fibonacci/Writeup/Photos/IMAG1710_BURST002_COVER.jpg

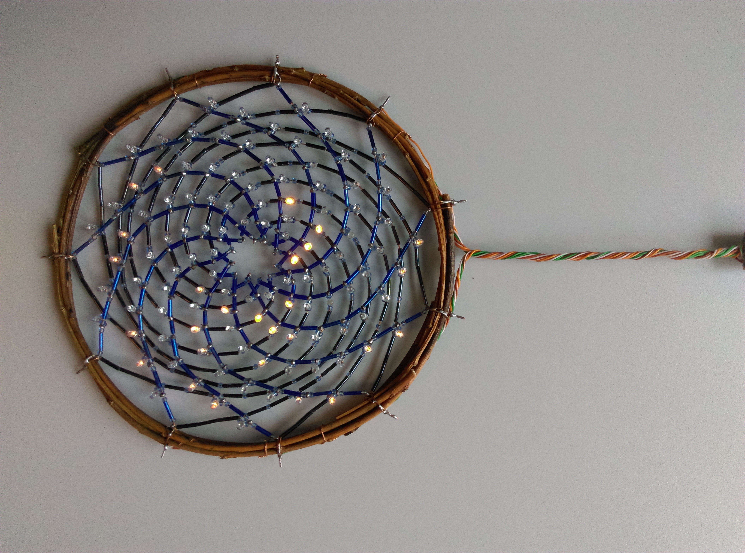
Project 3: Fibonacci/Writeup/Photos/IMAG1710_BURST002_COVER.jpg
