michaelerule/LED_weaving/Project 3: Fibonacci/Writeup/Photos/IMAG1714_BURST002_COVER.jpg

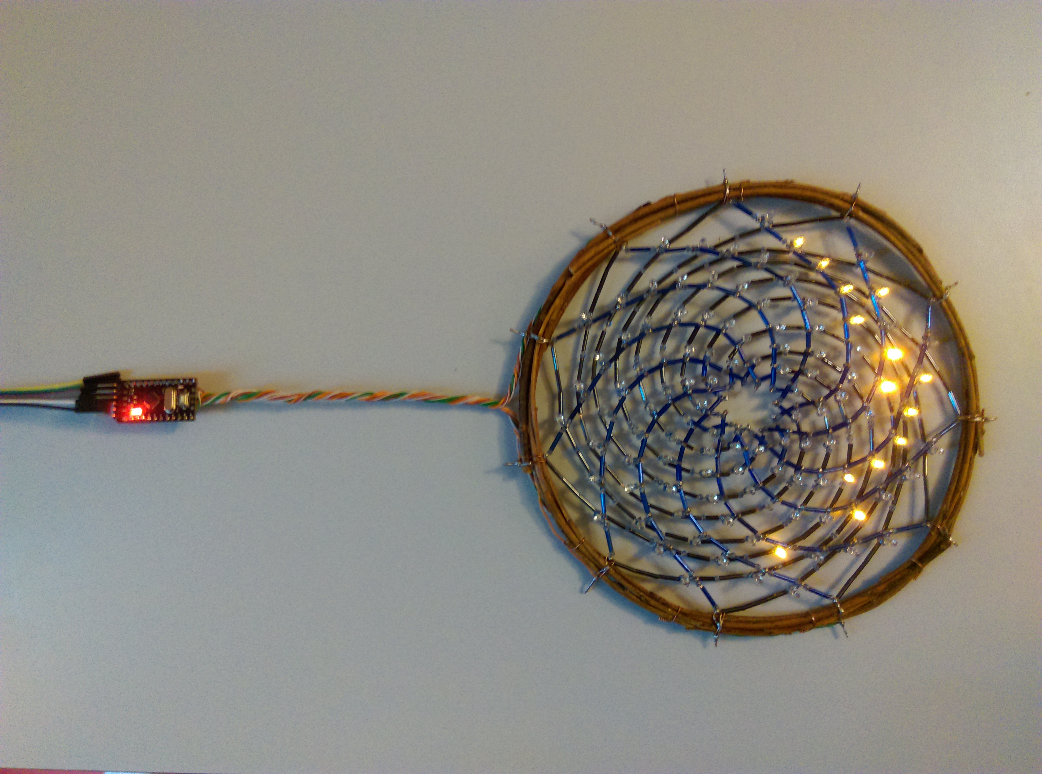
Project 3: Fibonacci/Writeup/Photos/IMAG1714_BURST002_COVER.jpg
