michaelerule/LED_weaving/Project 3: Fibonacci/Writeup/Photos/IMAG1714_BURST012.jpg

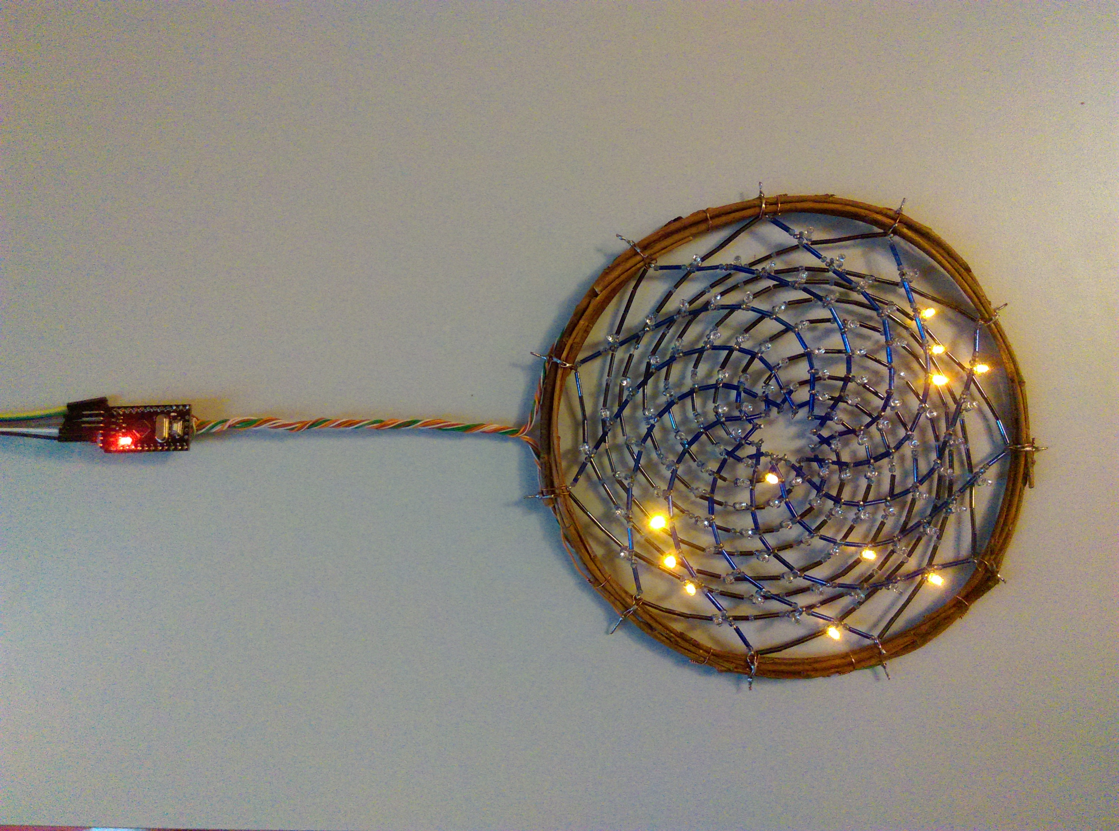
Project 3: Fibonacci/Writeup/Photos/IMAG1714_BURST012.jpg
