michaelerule/LED_weaving/Project 3: Fibonacci/Writeup/Photos/IMAG1715_BURST017.jpg

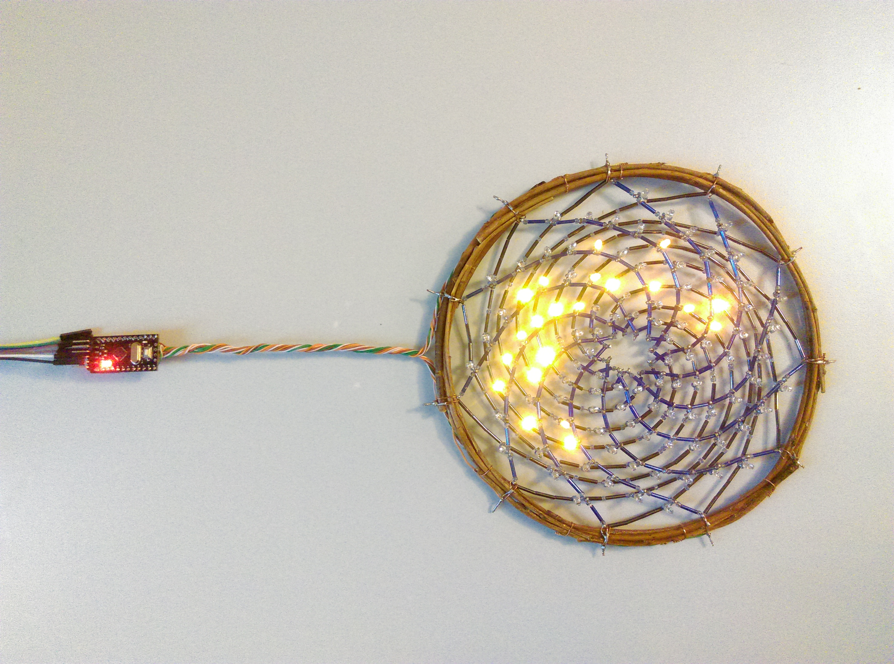
Project 3: Fibonacci/Writeup/Photos/IMAG1715_BURST017.jpg
