michaelerule/LED_weaving/Writeup/Figures/figure_3_v2.png

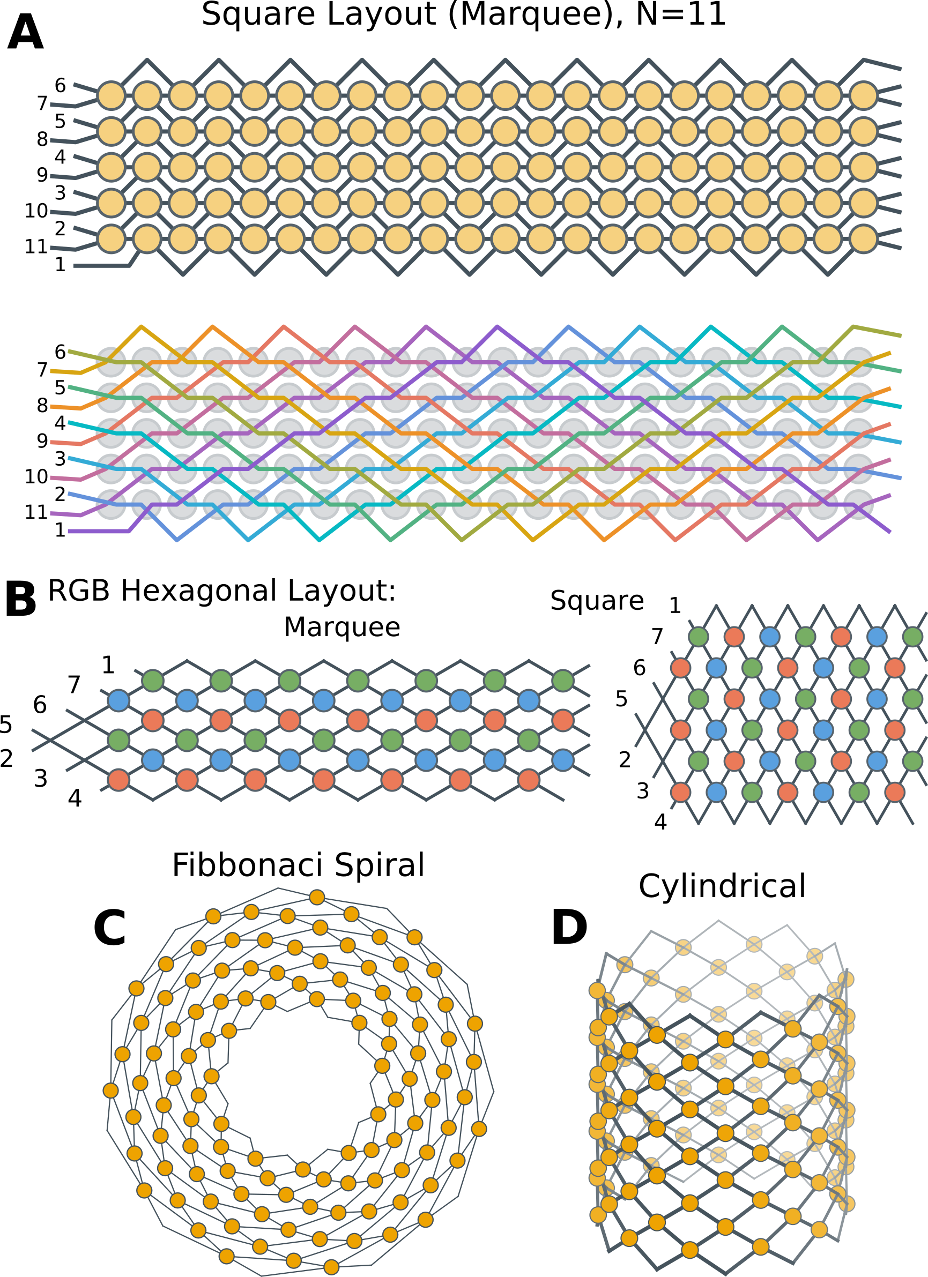
Writeup/Figures/figure_3_v2.png
