michaelerule/LED_weaving/Writeup/figures/png/20190205_LED_handcraft_multiplexing_figure_4.png

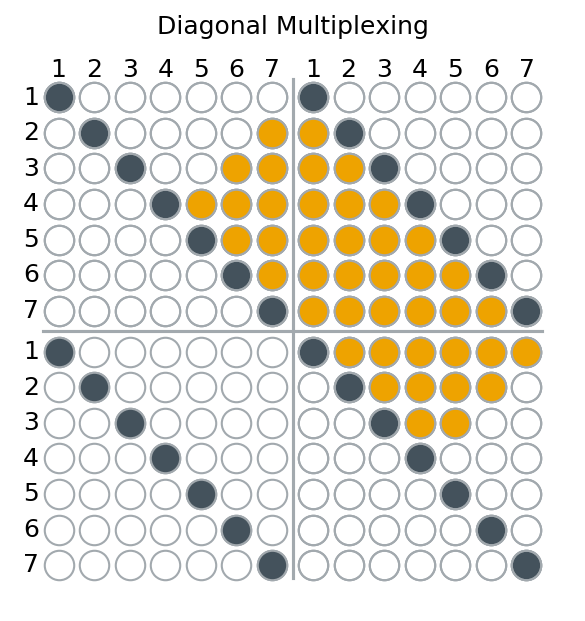
Writeup/figures/png/20190205_LED_handcraft_multiplexing_figure_4.png
