michaelerule/LED_weaving/Writeup/figures/png/20190207_LED_handcraft_multiplexing_figure_11.png

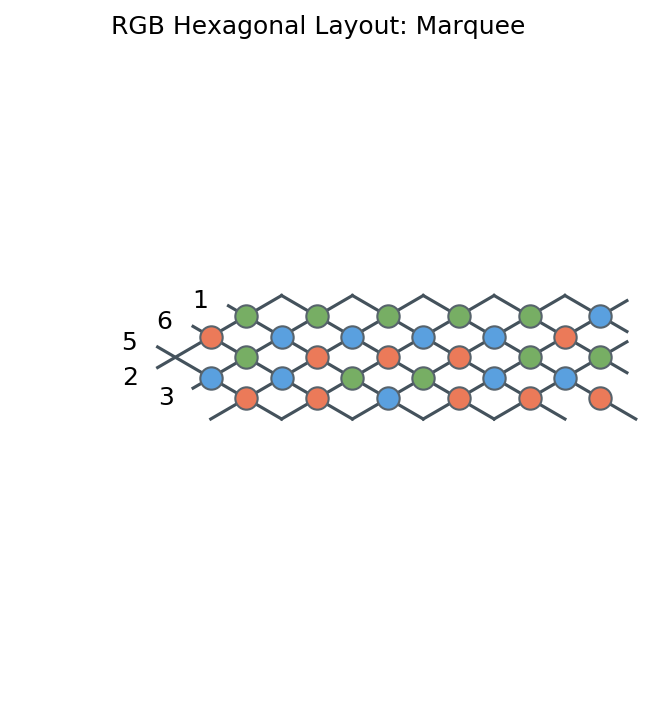
Writeup/figures/png/20190207_LED_handcraft_multiplexing_figure_11.png
