michaelerule/LED_weaving/Writeup/figures/png/gif2/20190205_LED_handcraft_multiplexing_figure_39.png

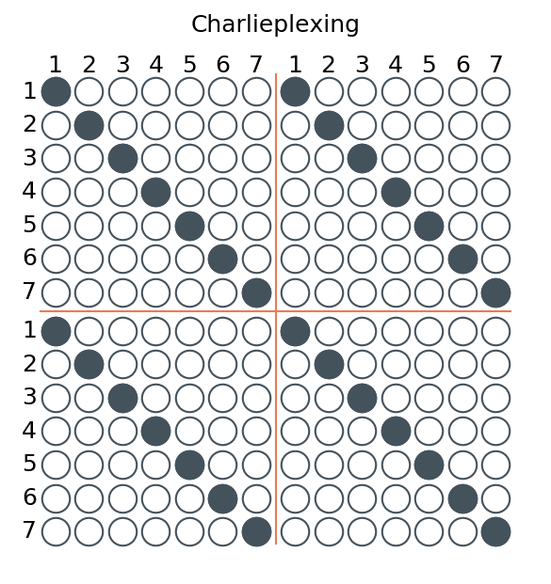
Writeup/figures/png/gif2/20190205_LED_handcraft_multiplexing_figure_39.png
