michaelerule/LED_weaving/Writeup/Figures/wrapping.png

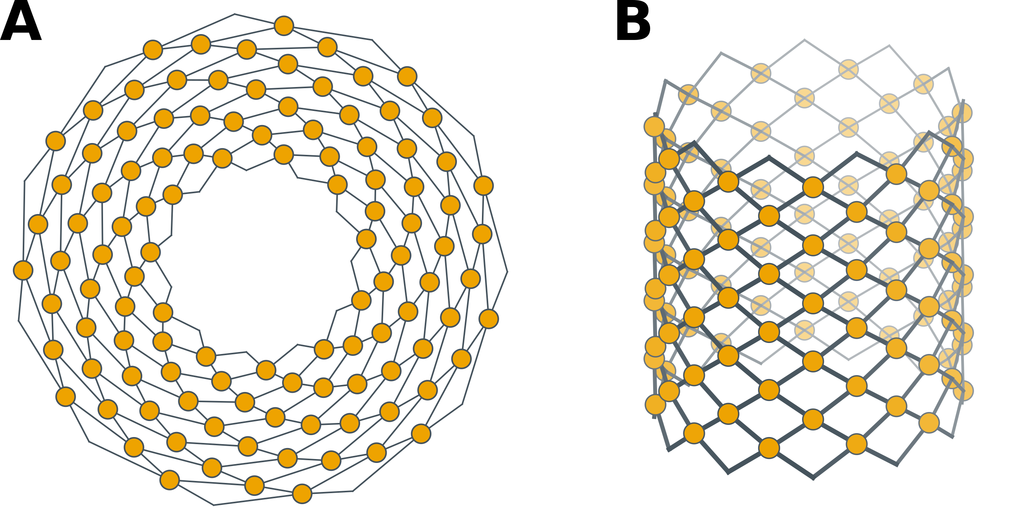
Writeup/Figures/wrapping.png
