michaelerule/LED_weaving/Project 2: Marquee/Writeup/editing/materials.png

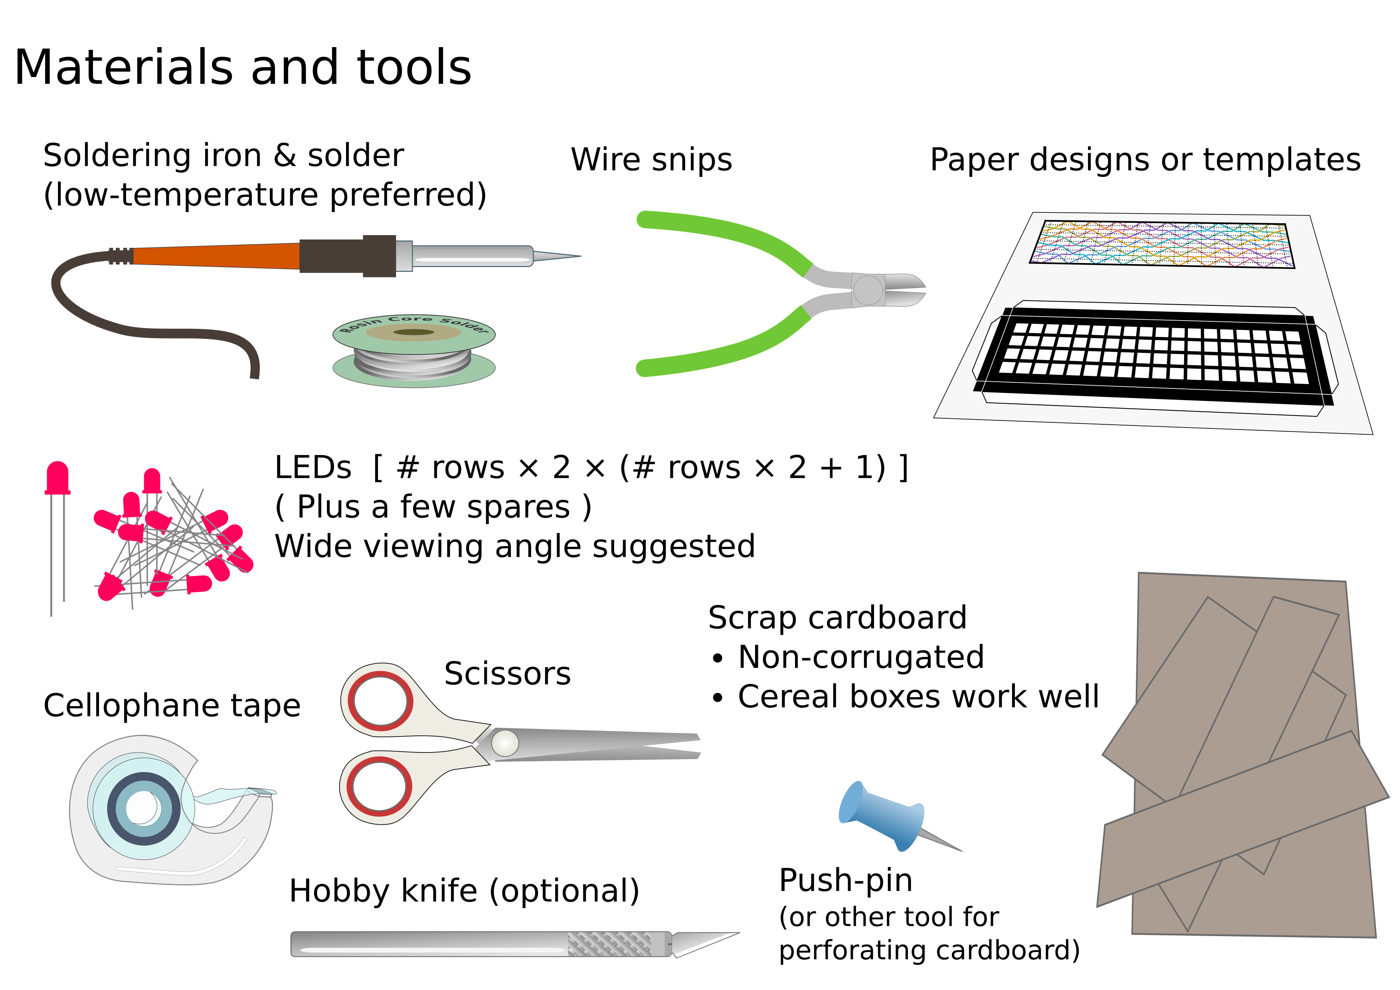
Project 2: Marquee/Writeup/editing/materials.png
