michaelerule/LED_weaving/(list of files, cad)

Other CAD files:
Other/Development/weaving/LED2.scad
