michaelerule/LED_weaving/Project 2: Marquee/Writeup/editing/ready_to_solder.pdf

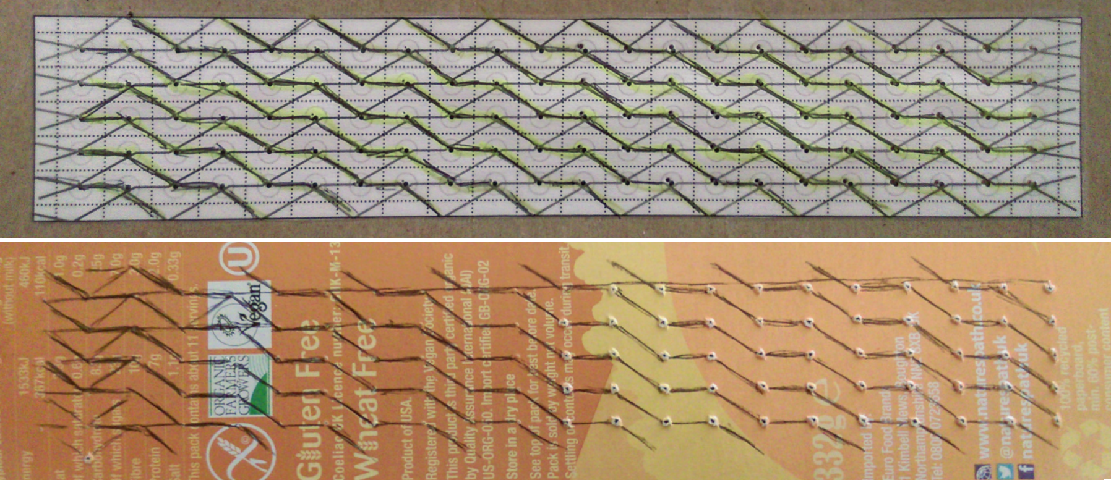
[picture p255: page 1]
