michaelerule/LED_weaving/Project 2: Marquee/Writeup/editing/soldered.pdf

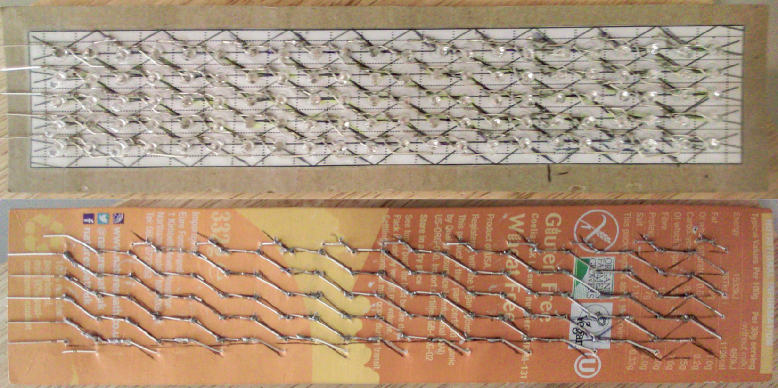
[picture p256: page 1]
