michaelerule/LED_weaving/Project 2: Marquee/Writeup/editing/soldering.pdf

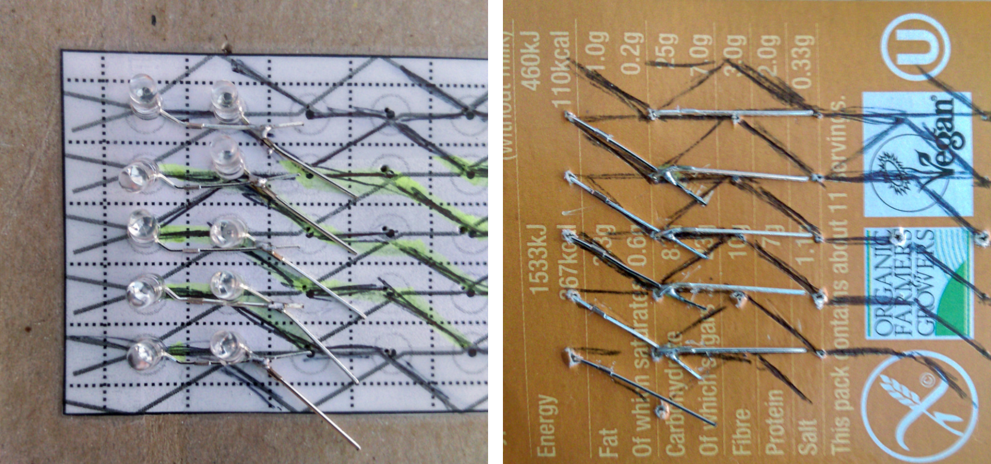
[picture p257: page 1]
