michaelerule/LED_weaving/Project 2: Marquee/Writeup/editing/step_2.png

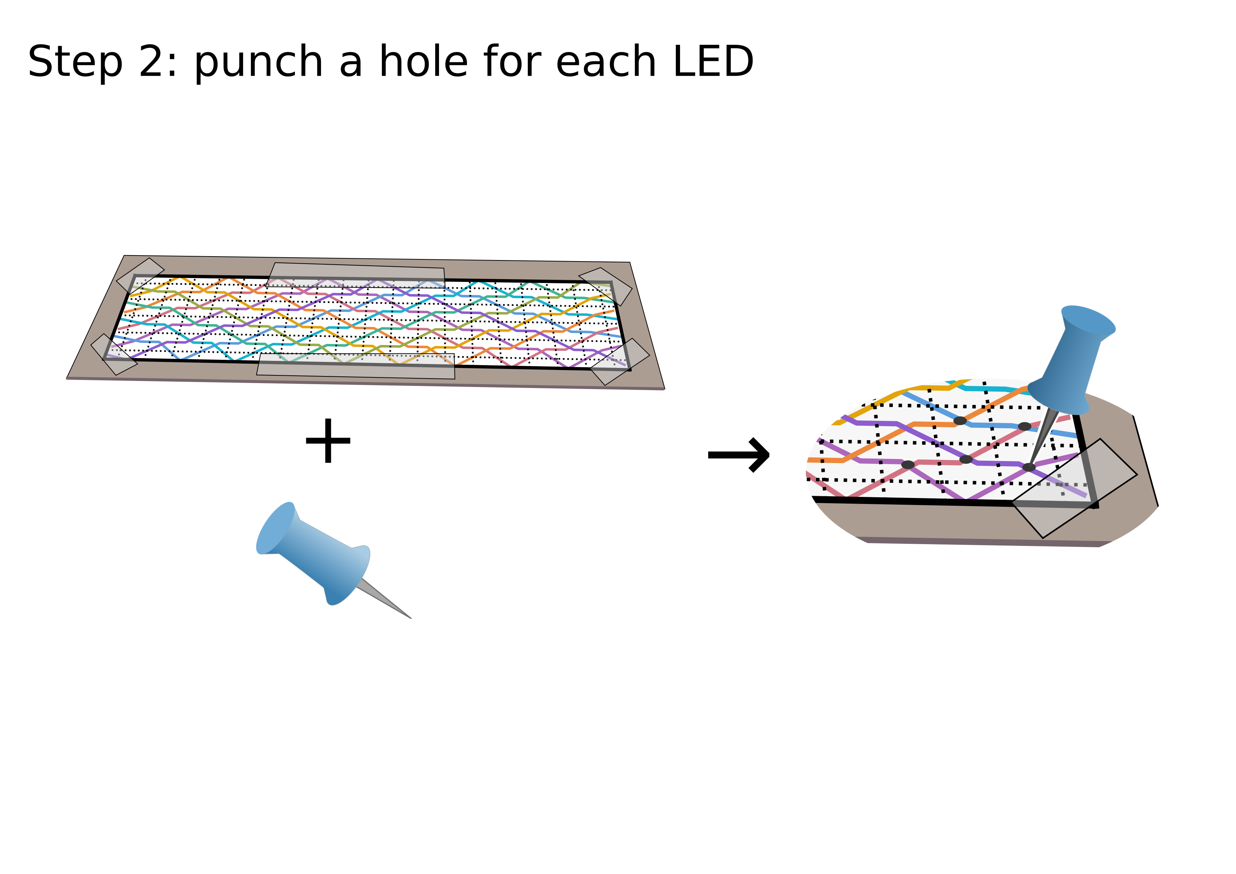
Project 2: Marquee/Writeup/editing/step_2.png
