michaelerule/LED_weaving/Project 3: Fibonacci/Writeup/step_2.png

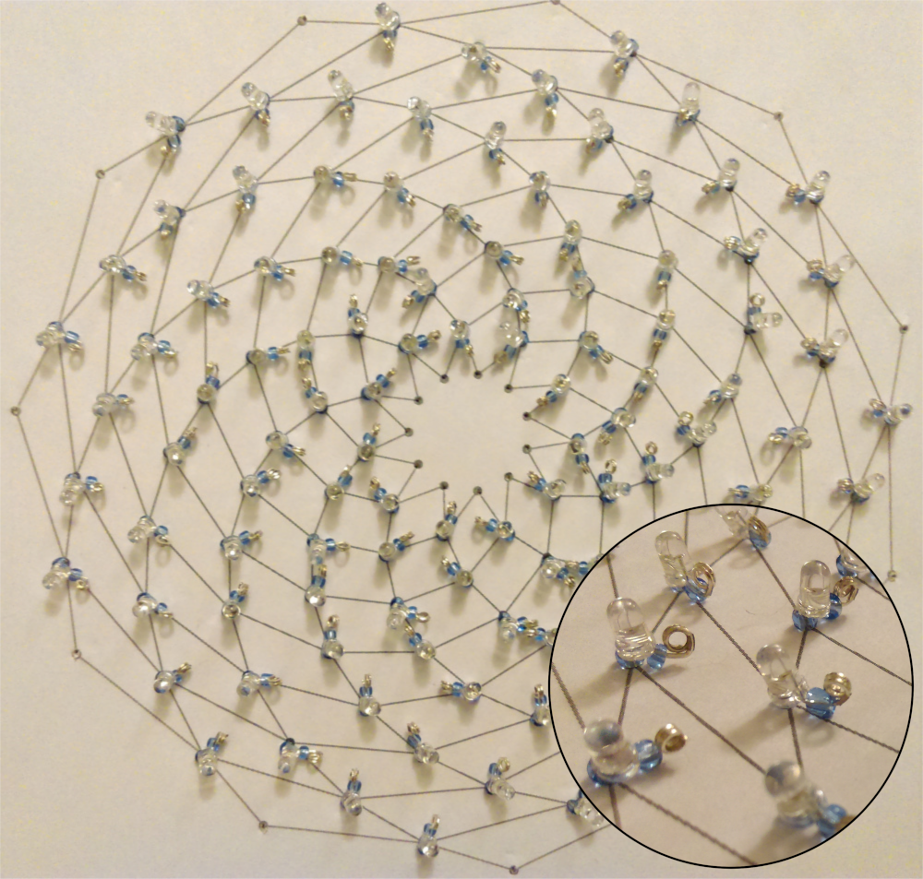
Project 3: Fibonacci/Writeup/step_2.png
