michaelerule/LED_weaving/Project 2: Marquee/Writeup/editing/materials.pdf

## Materials and tools

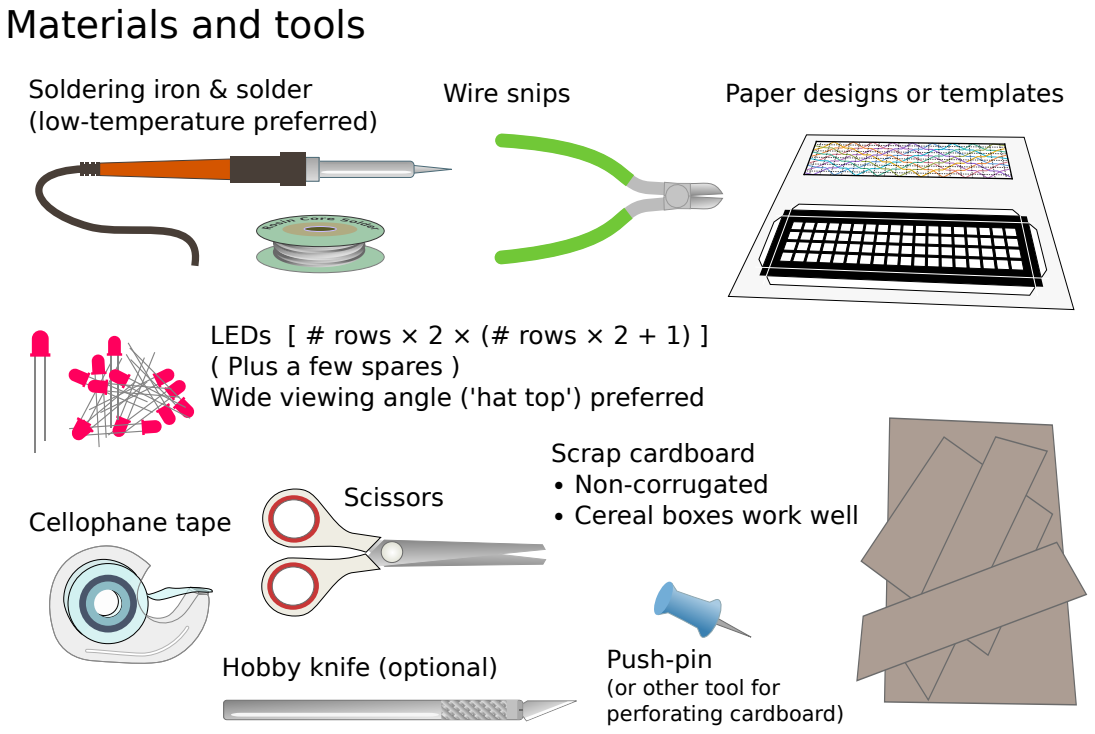
[picture p260: page 1]
Wire snips; Paper designs or templates; Scrap cardboard ∙ Non-corrugated; Cellophane tape; ∙ Cereal boxes work well Scissors; Hobby knife (optional); Push-pin

Soldering iron & solder
(low-temperature preferred)

LEDs [ # rows × 2 × (# rows × 2 + 1) ]
( Plus a few spares )
Wide viewing angle ('hat top') preferred

(or other tool for
perforating cardboard)
