michaelerule/LED_weaving/Project 3: Fibonacci/Templates/Sunflower_10_90_LEDs.pdf

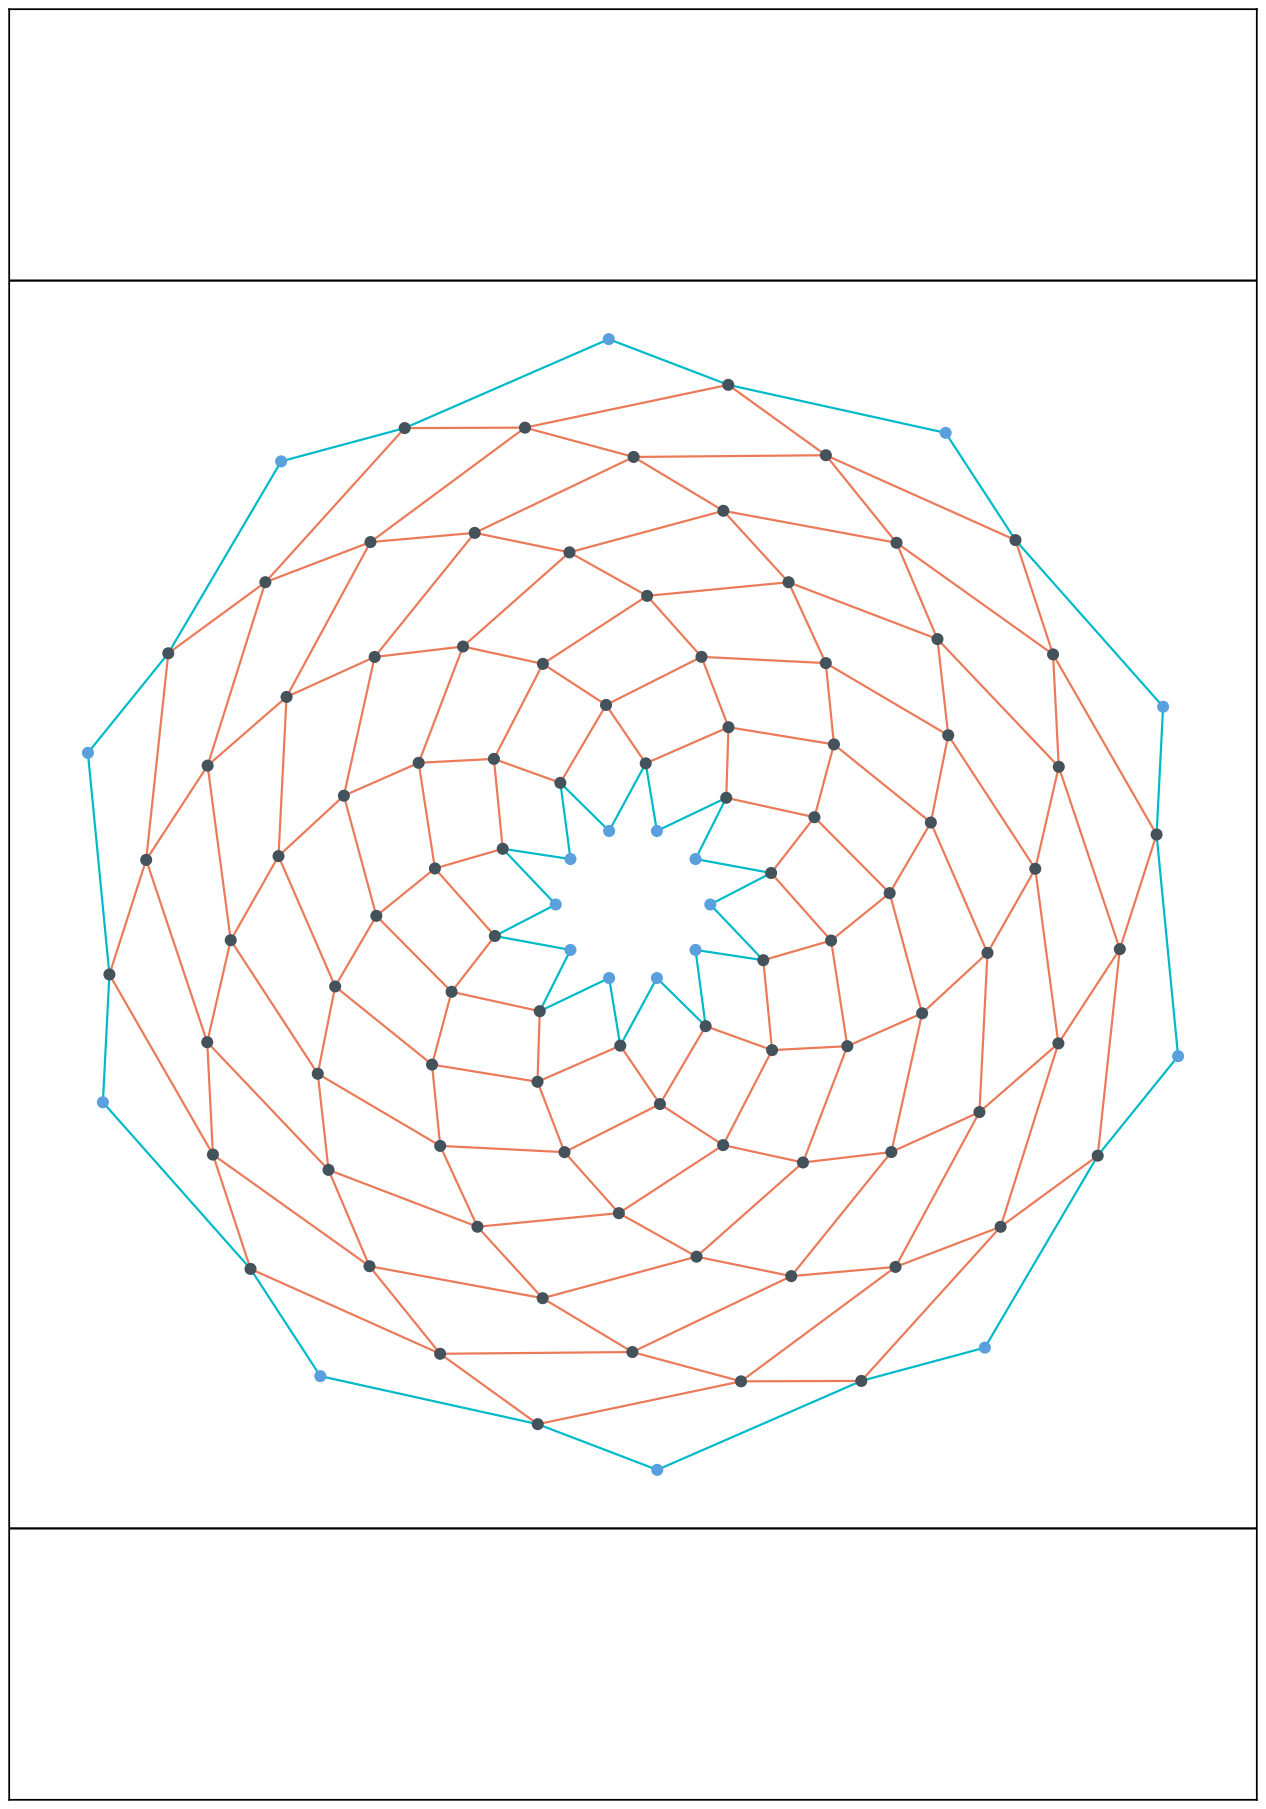
[picture p261: page 1]
