michaelerule/LED_weaving/Project 3: Fibonacci/Templates/Sunflower_11_110_LEDs.pdf

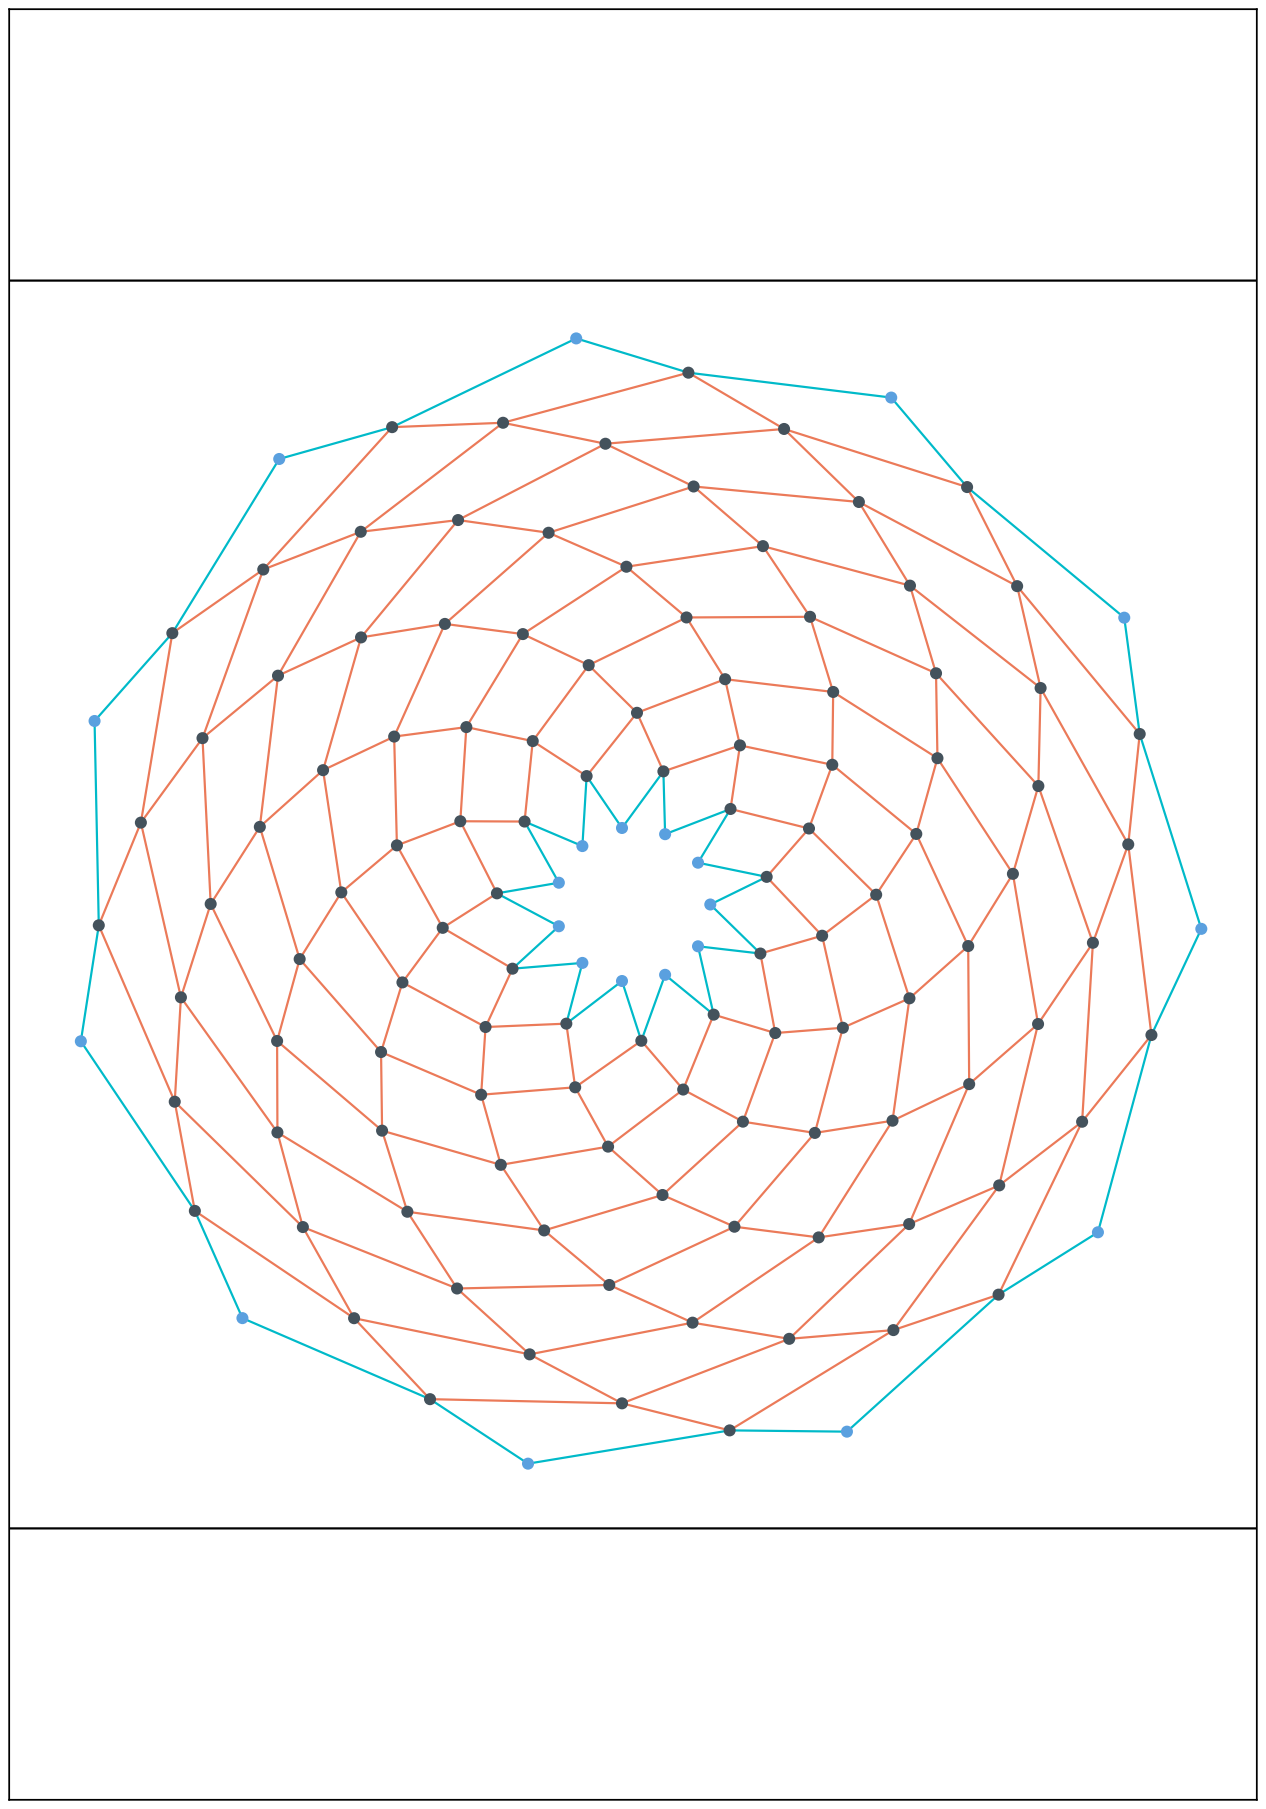
[picture p262: page 1]
