michaelerule/LED_weaving/Project 3: Fibonacci/Templates/Sunflower_16_240_LEDs.pdf

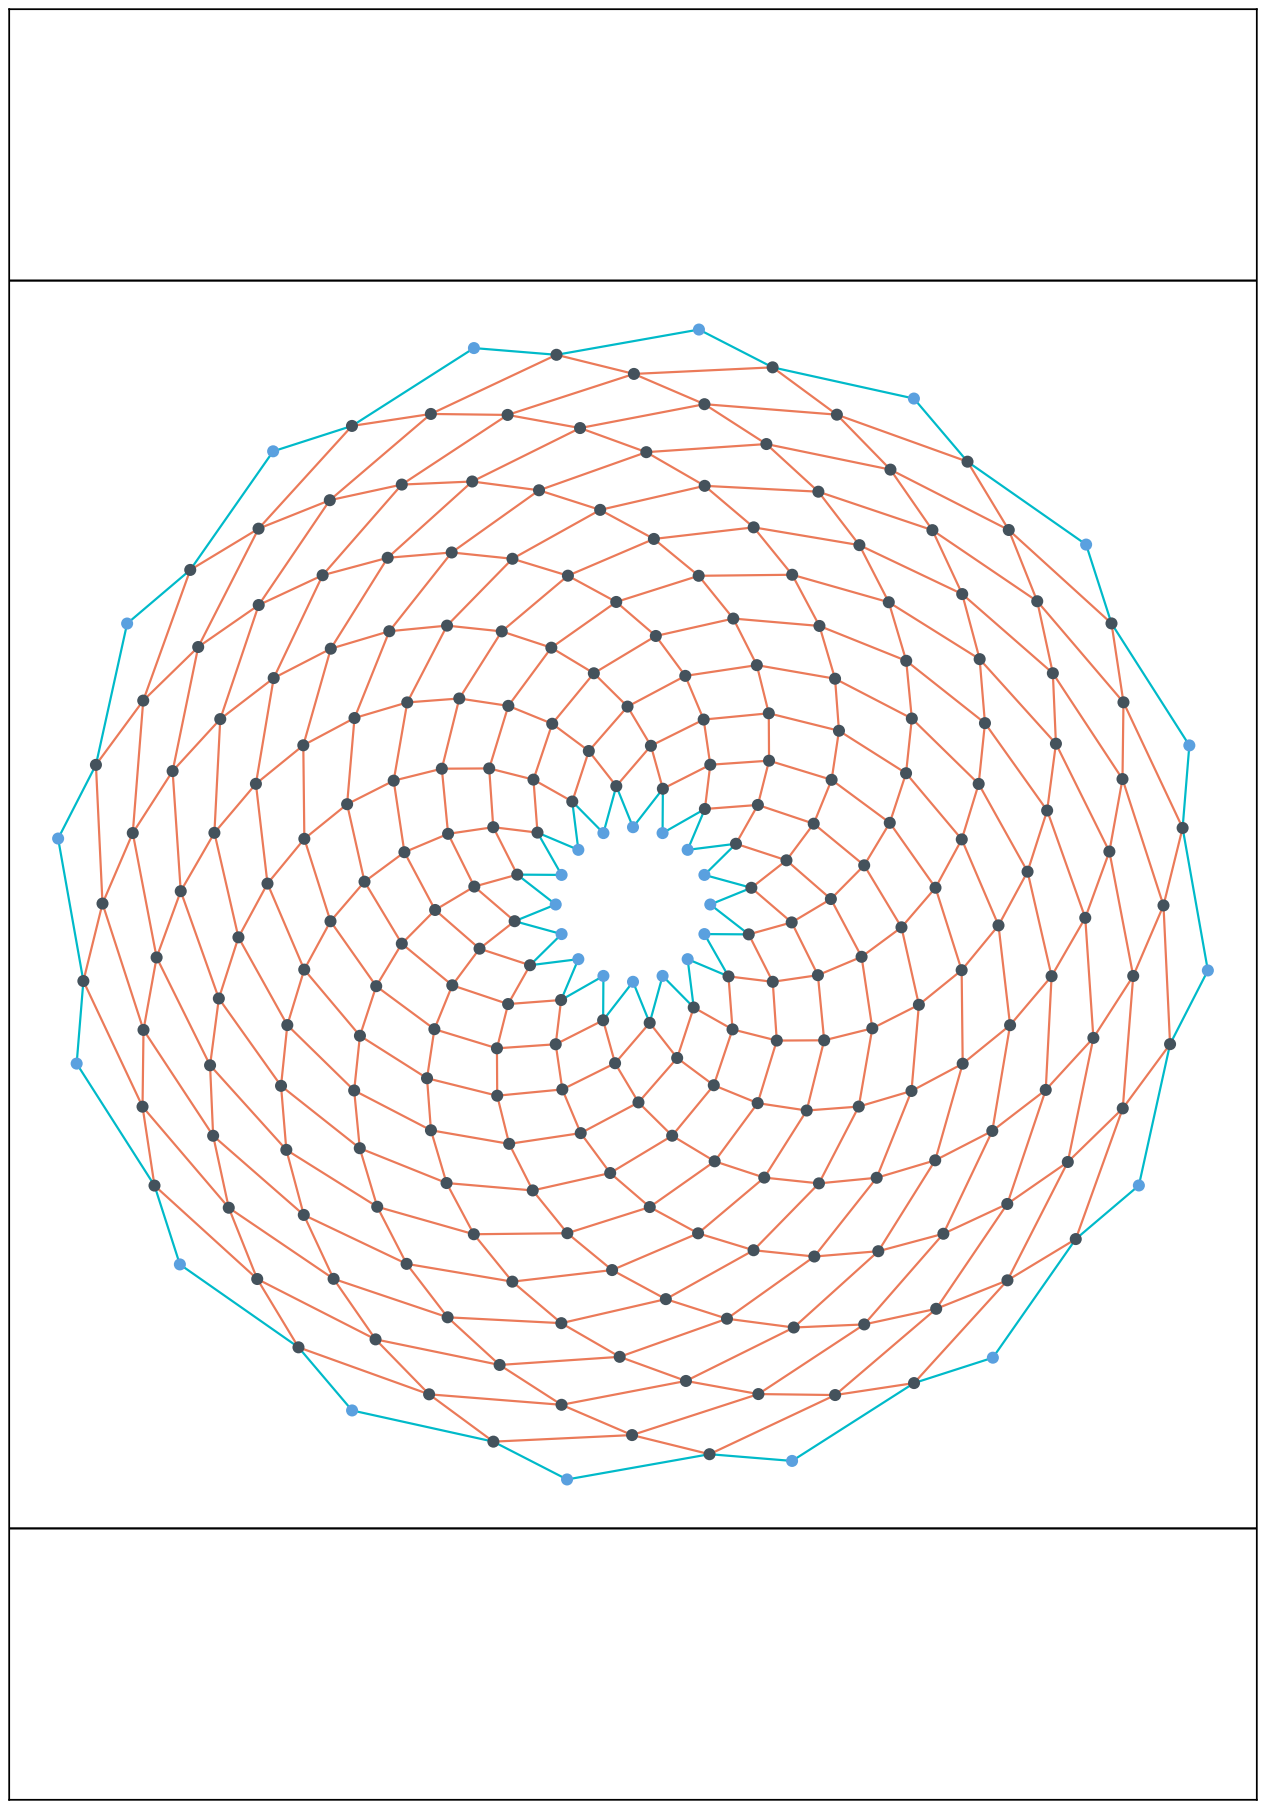
[picture p263: page 1]
