michaelerule/LED_weaving/Project 3: Fibonacci/Templates/Sunflower_16_240_LEDs_left.pdf

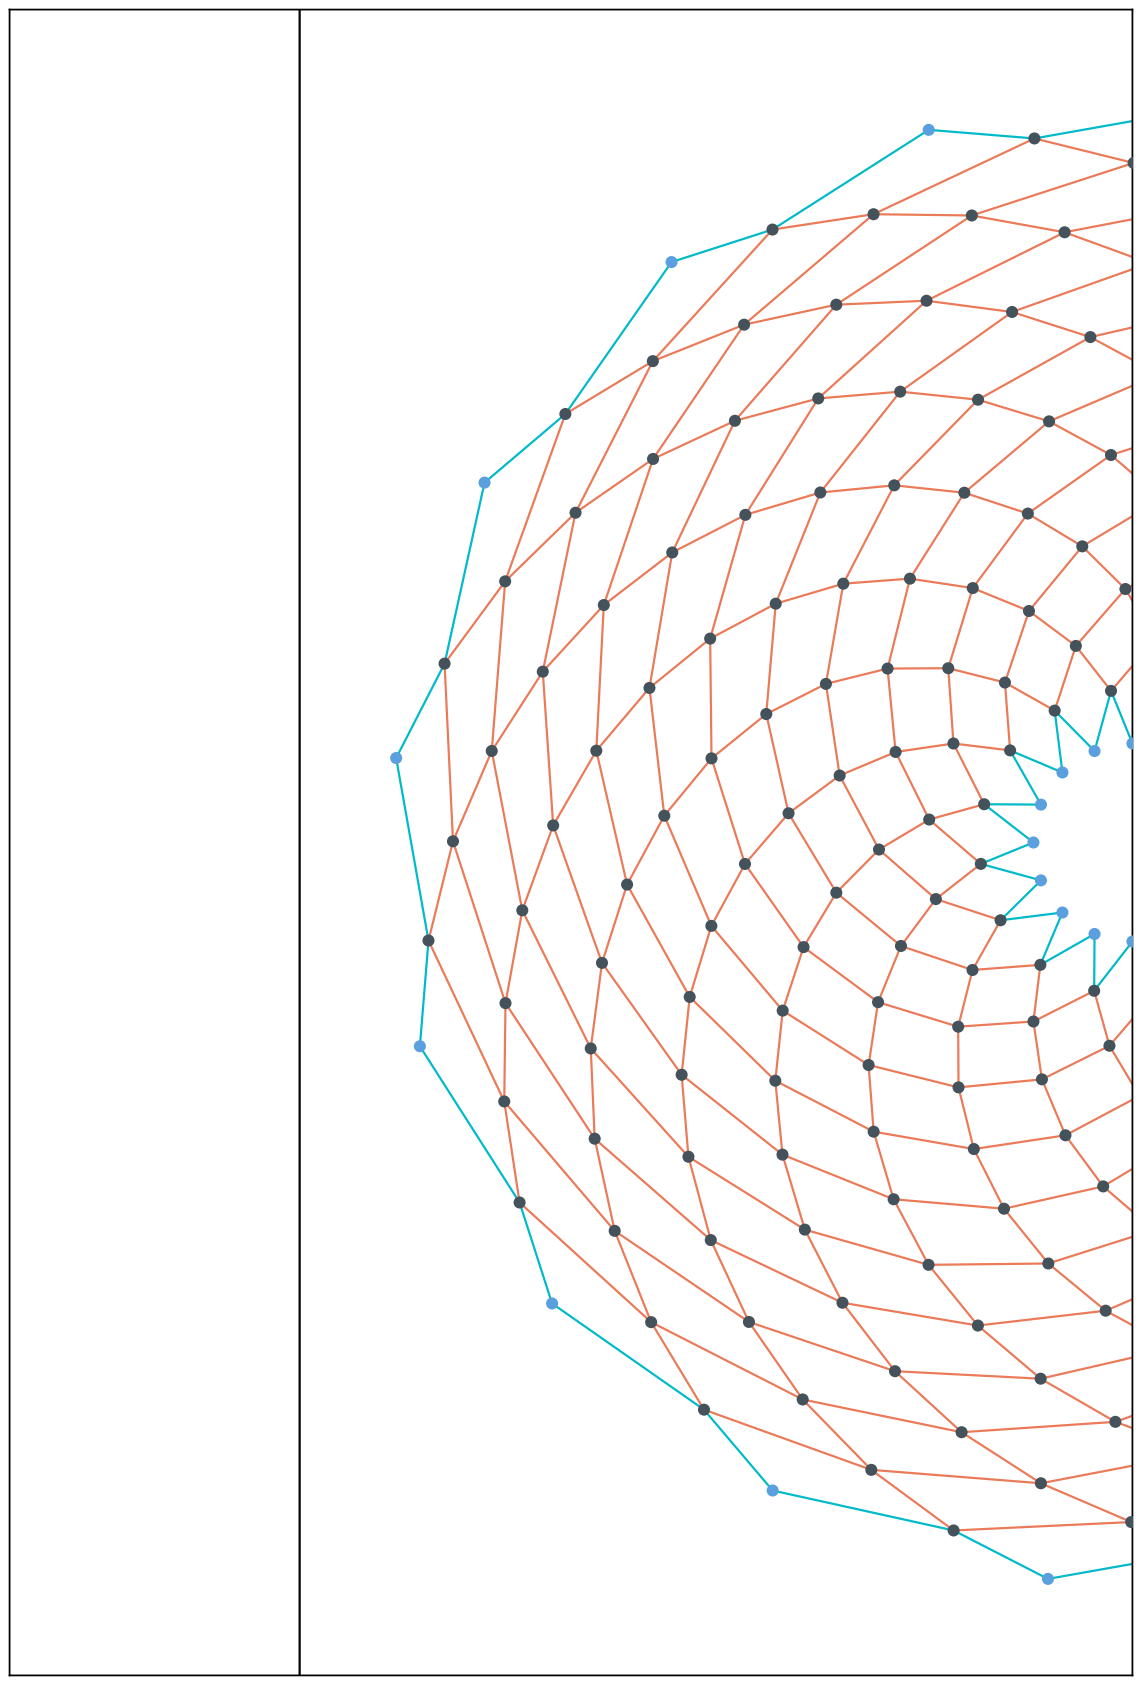
[picture p264: page 1]
