michaelerule/LED_weaving/Project 3: Fibonacci/Templates/Sunflower_16_240_LEDs_right.pdf

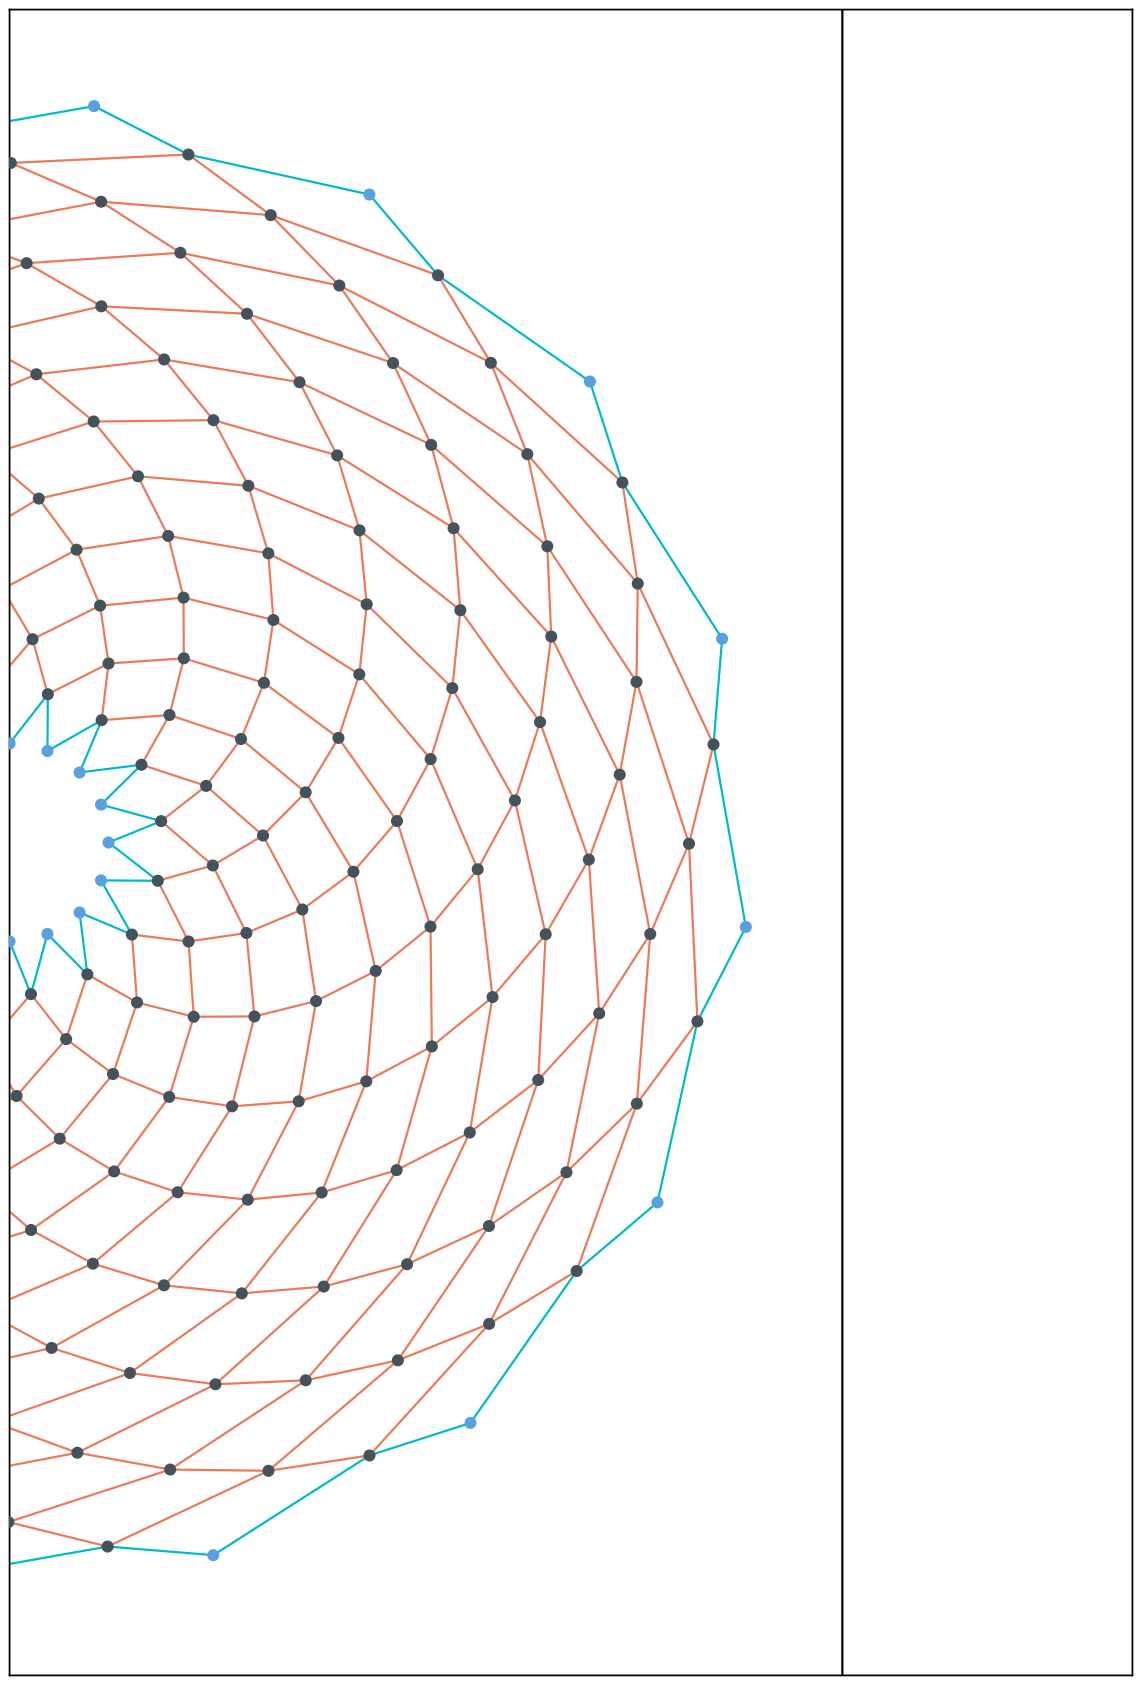
[picture p265: page 1]
