michaelerule/LED_weaving/Project 3: Fibonacci/Templates/Sunflower_17_272_LEDs_left.pdf

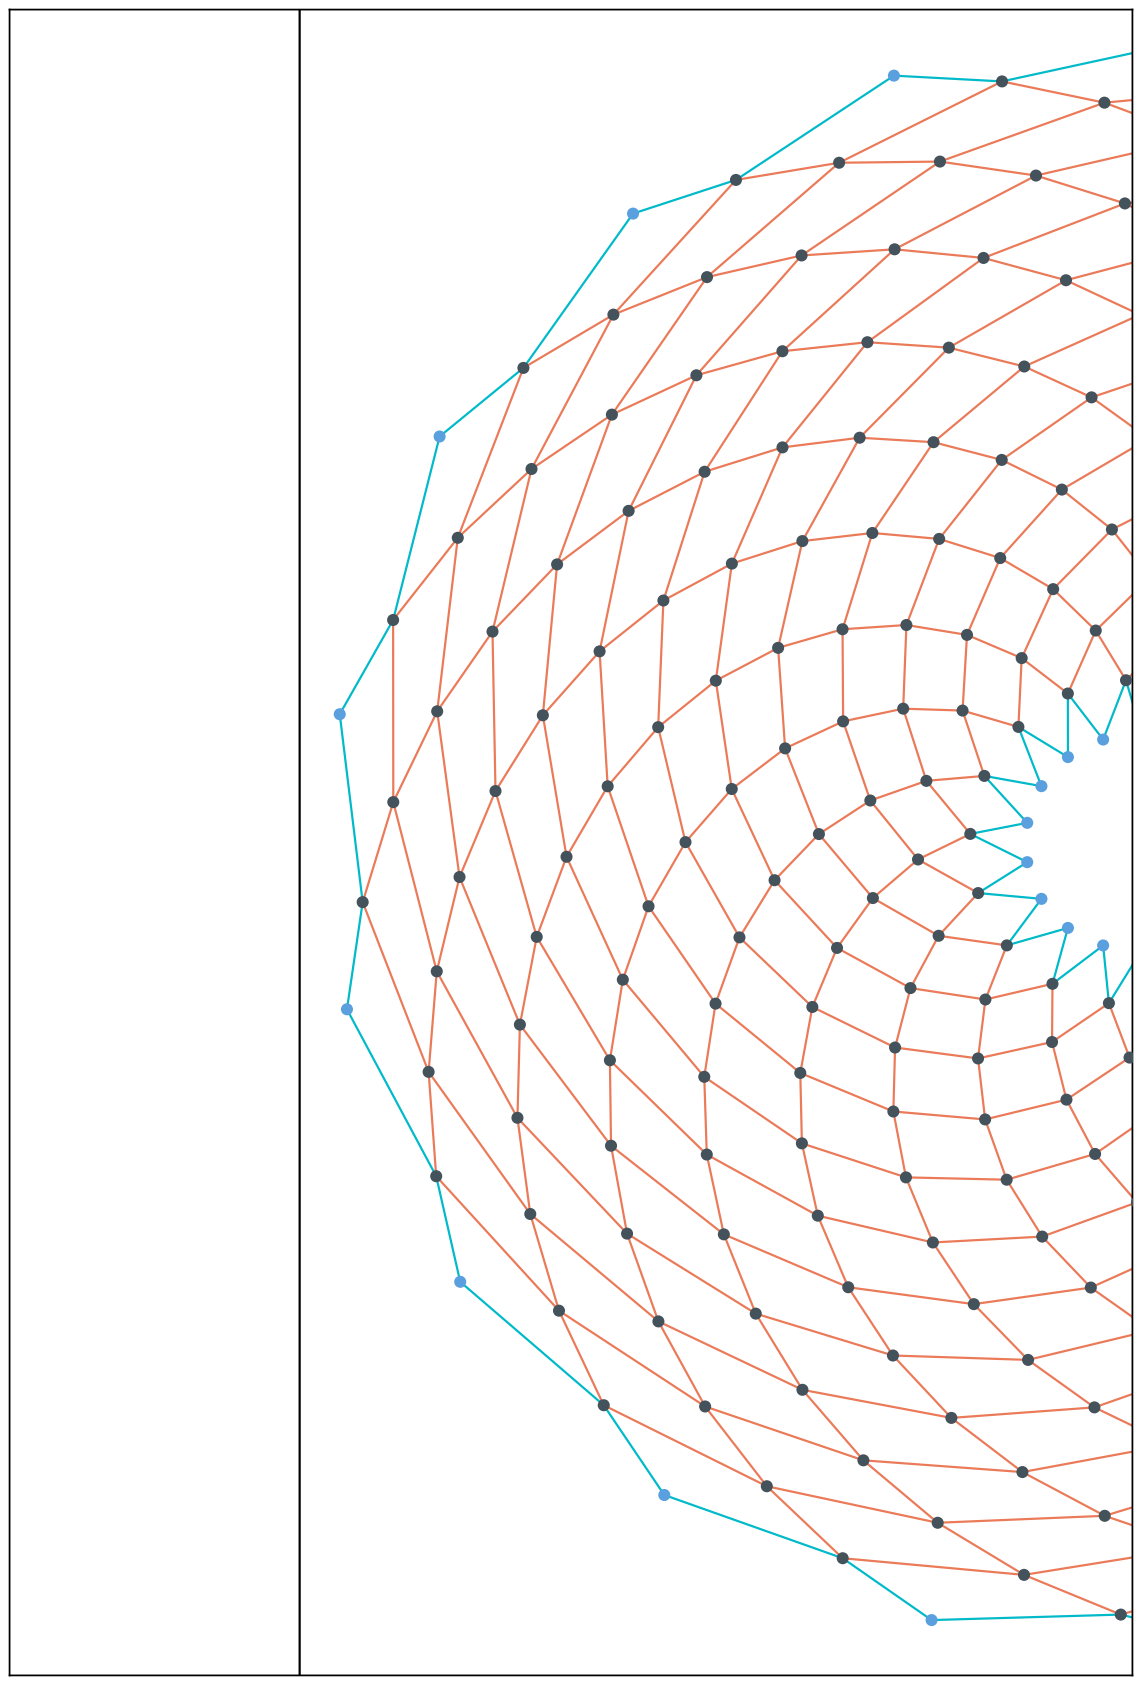
[picture p266: page 1]
