michaelerule/LED_weaving/Project 3: Fibonacci/Templates/Sunflower_17_272_LEDs_right.pdf

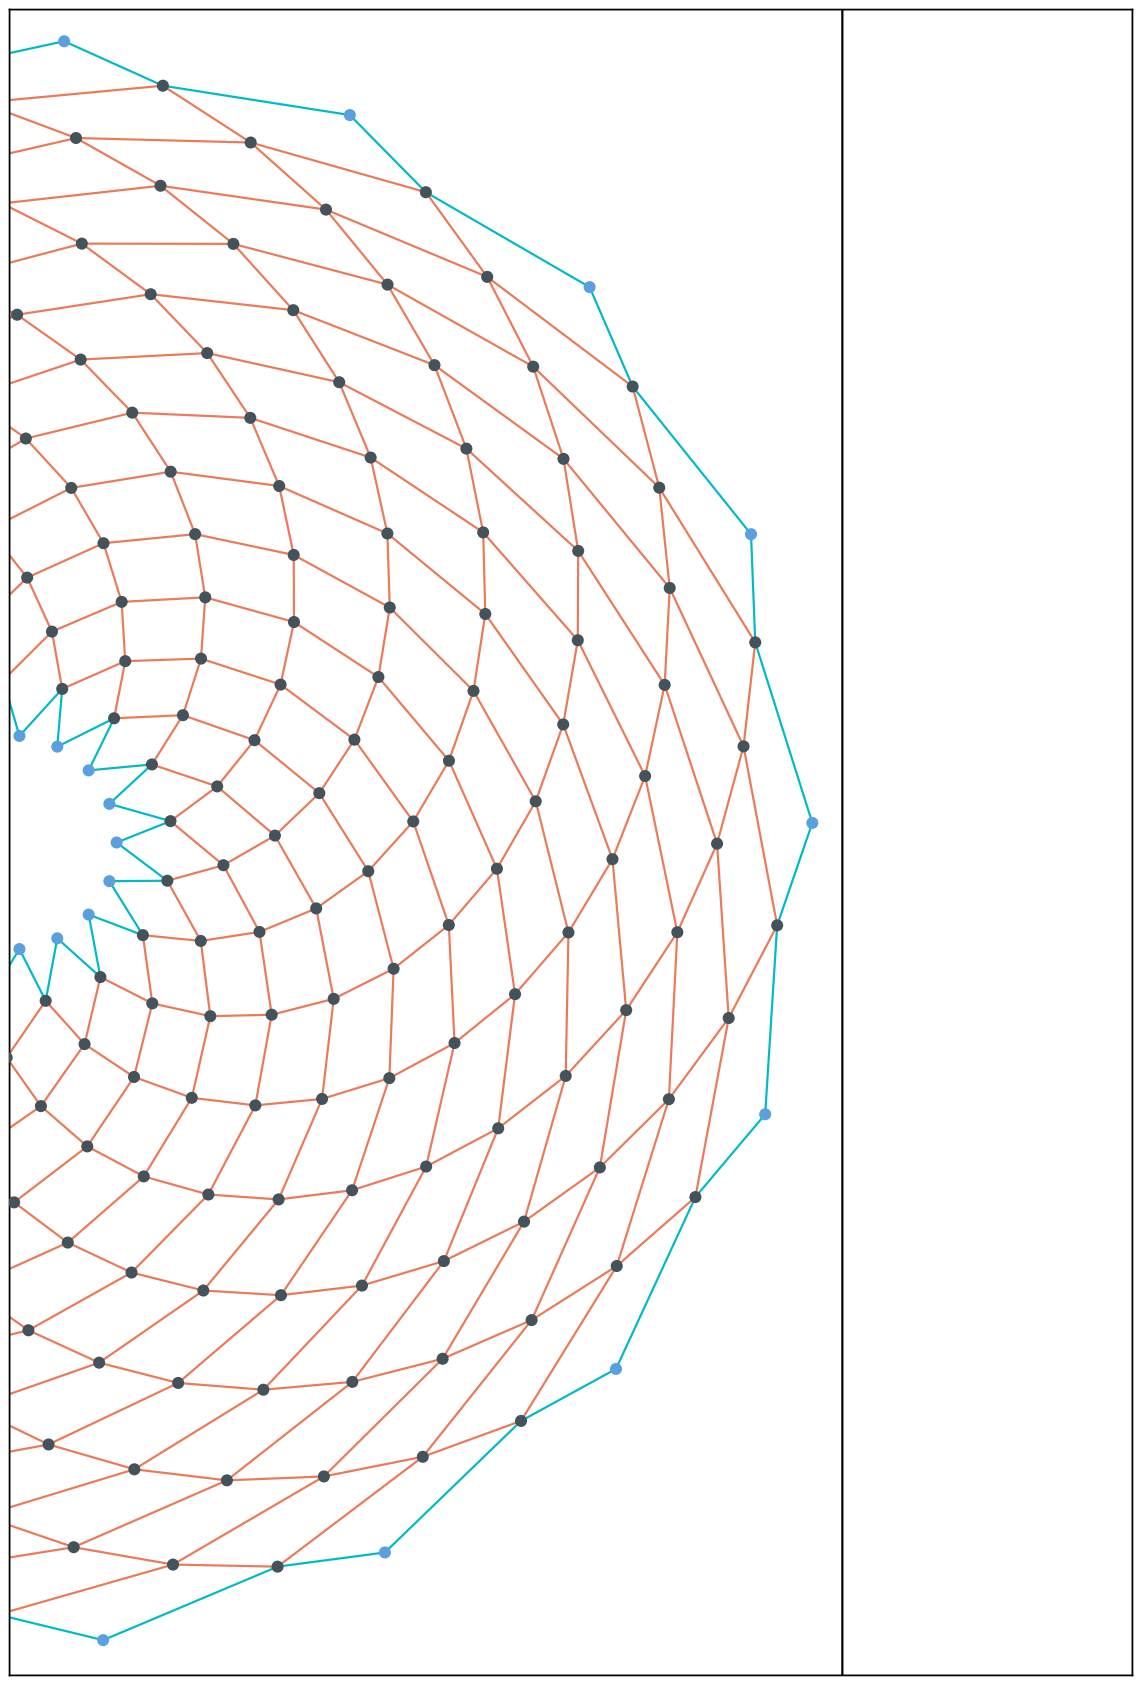
[picture p267: page 1]
