michaelerule/LED_weaving/Project 3: Fibonacci/Templates/Sunflower_20_380_LEDs_left.pdf

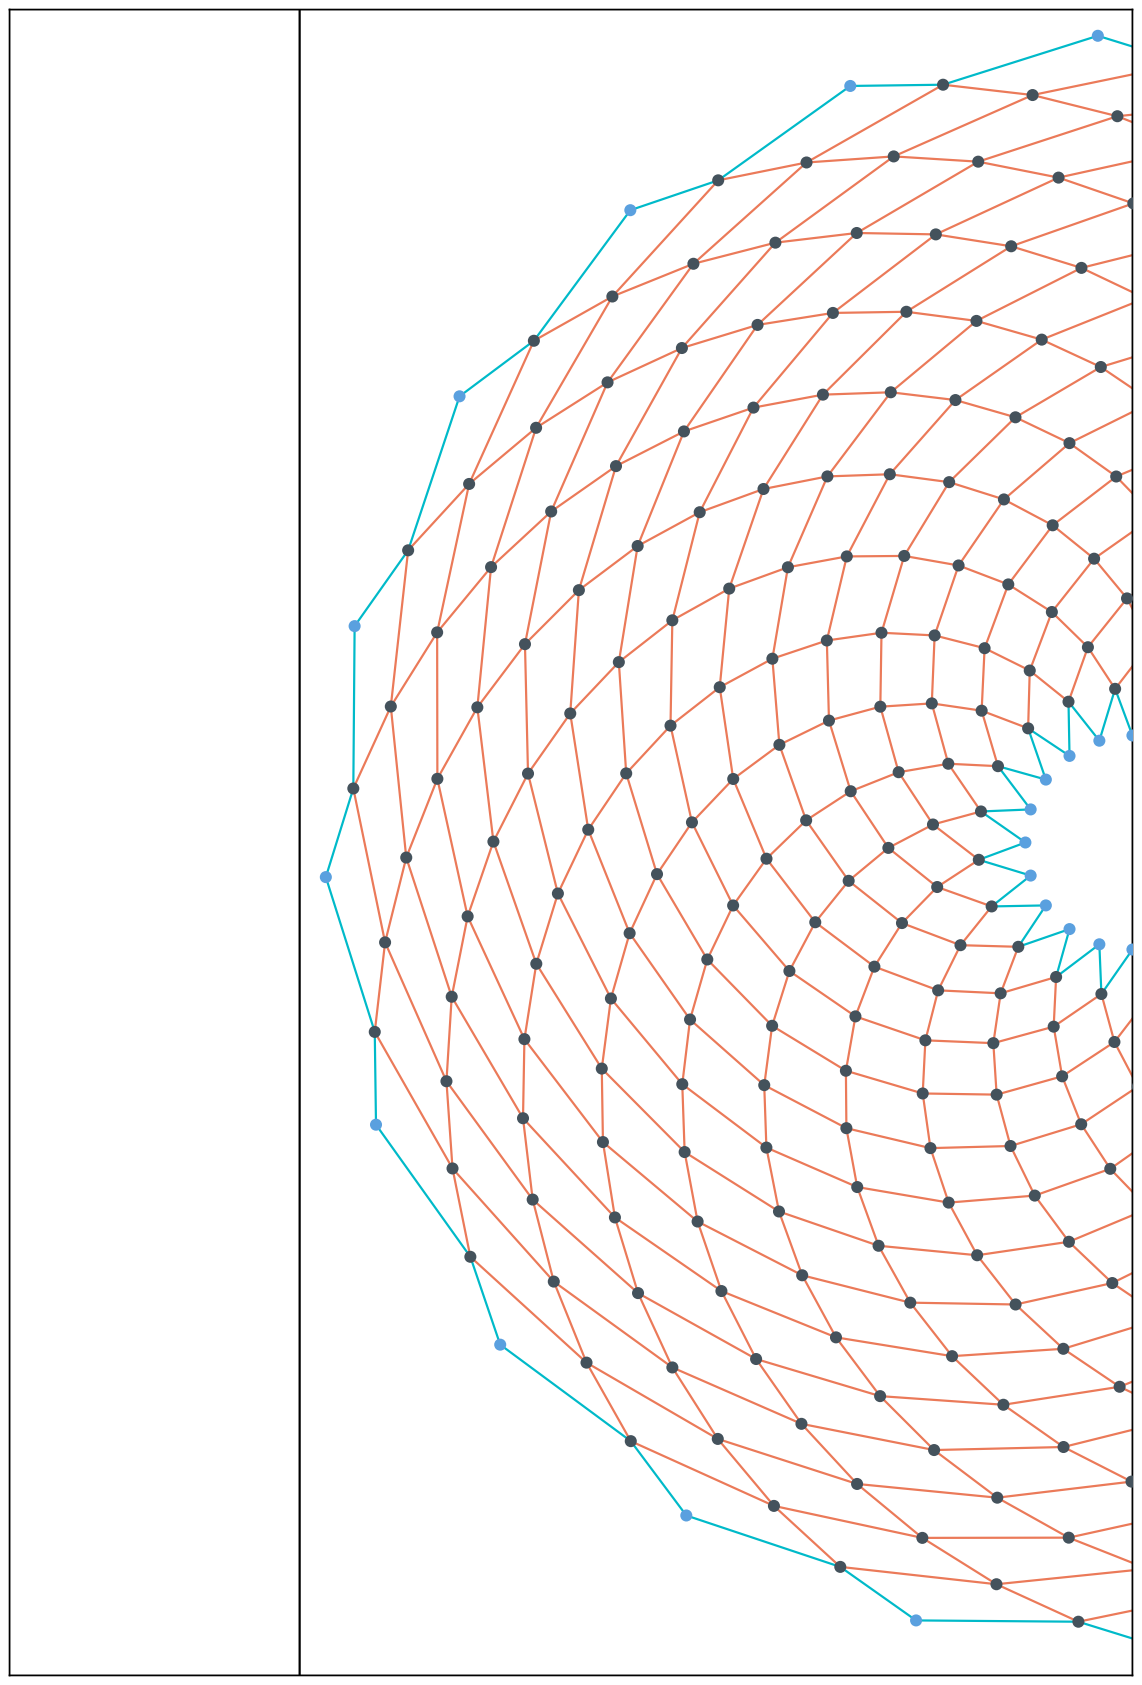
[picture p268: page 1]
