michaelerule/LED_weaving/Project 3: Fibonacci/Templates/Sunflower_20_380_LEDs_right.pdf

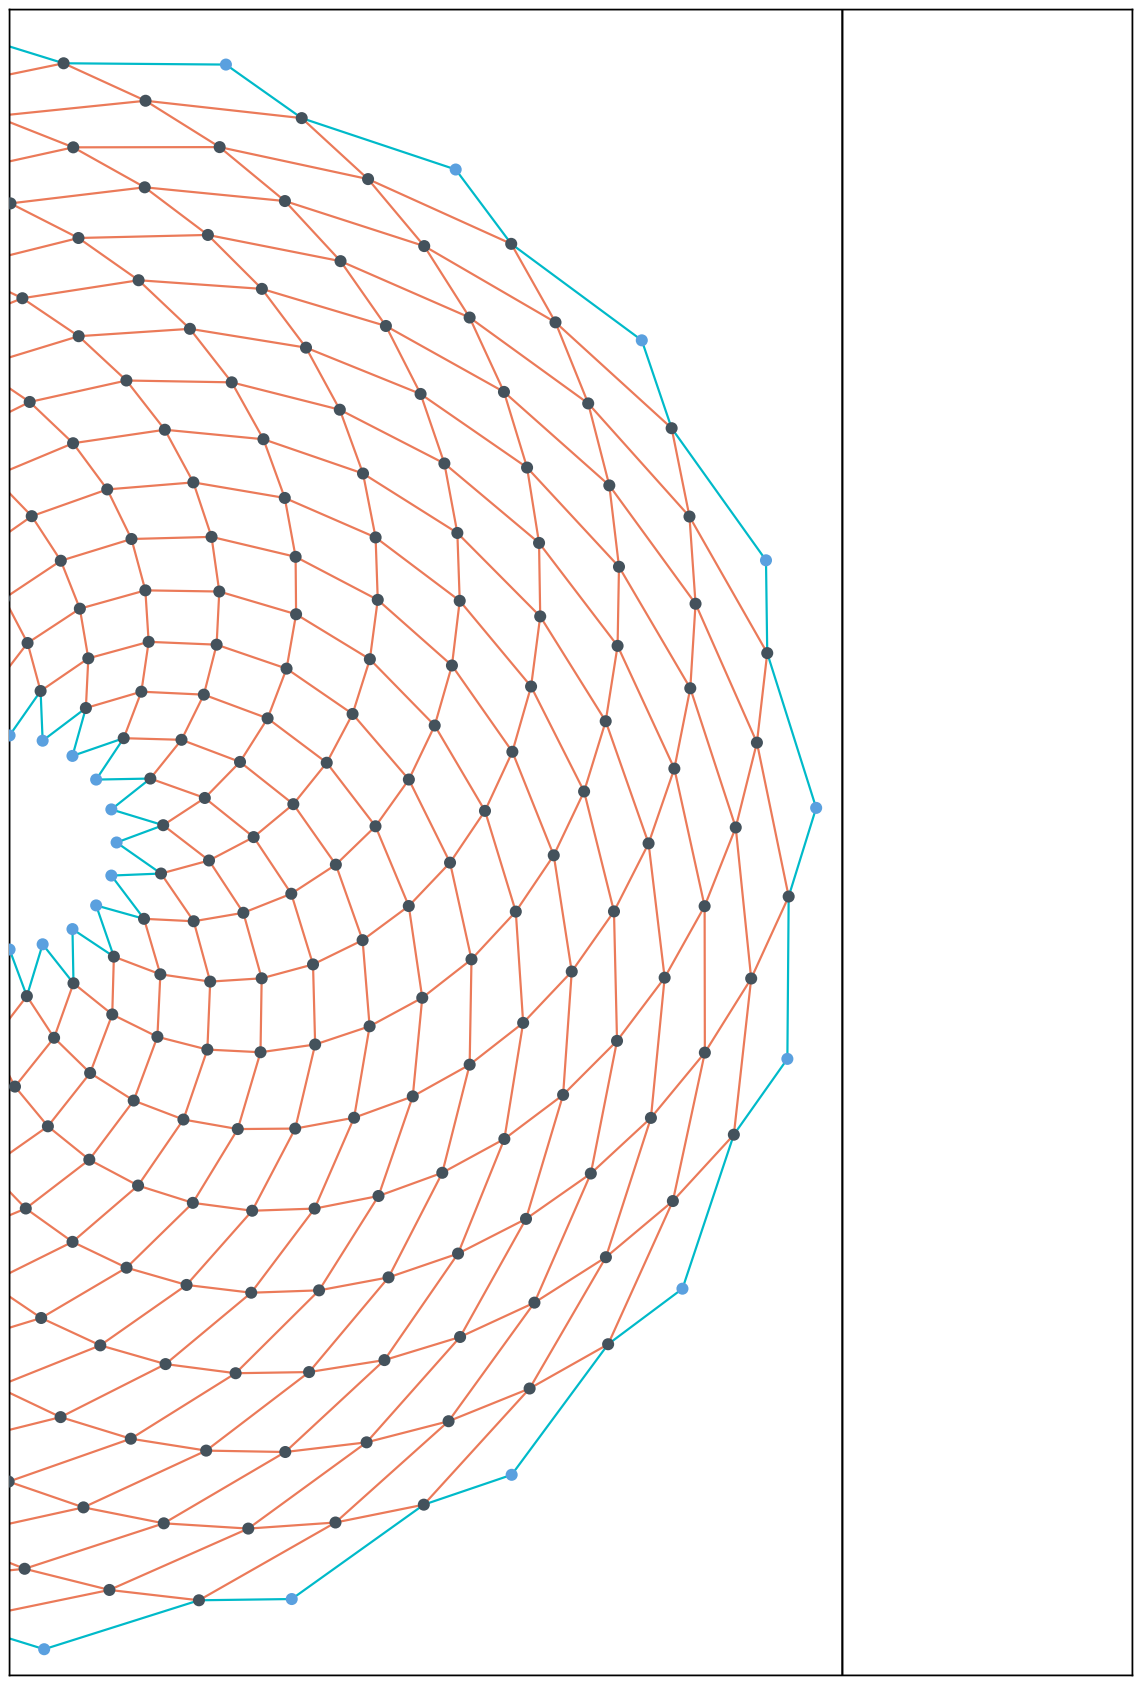
[picture p269: page 1]
