michaelerule/LED_weaving/Project 2: Marquee/Templates/Marquee_11_combined.pdf

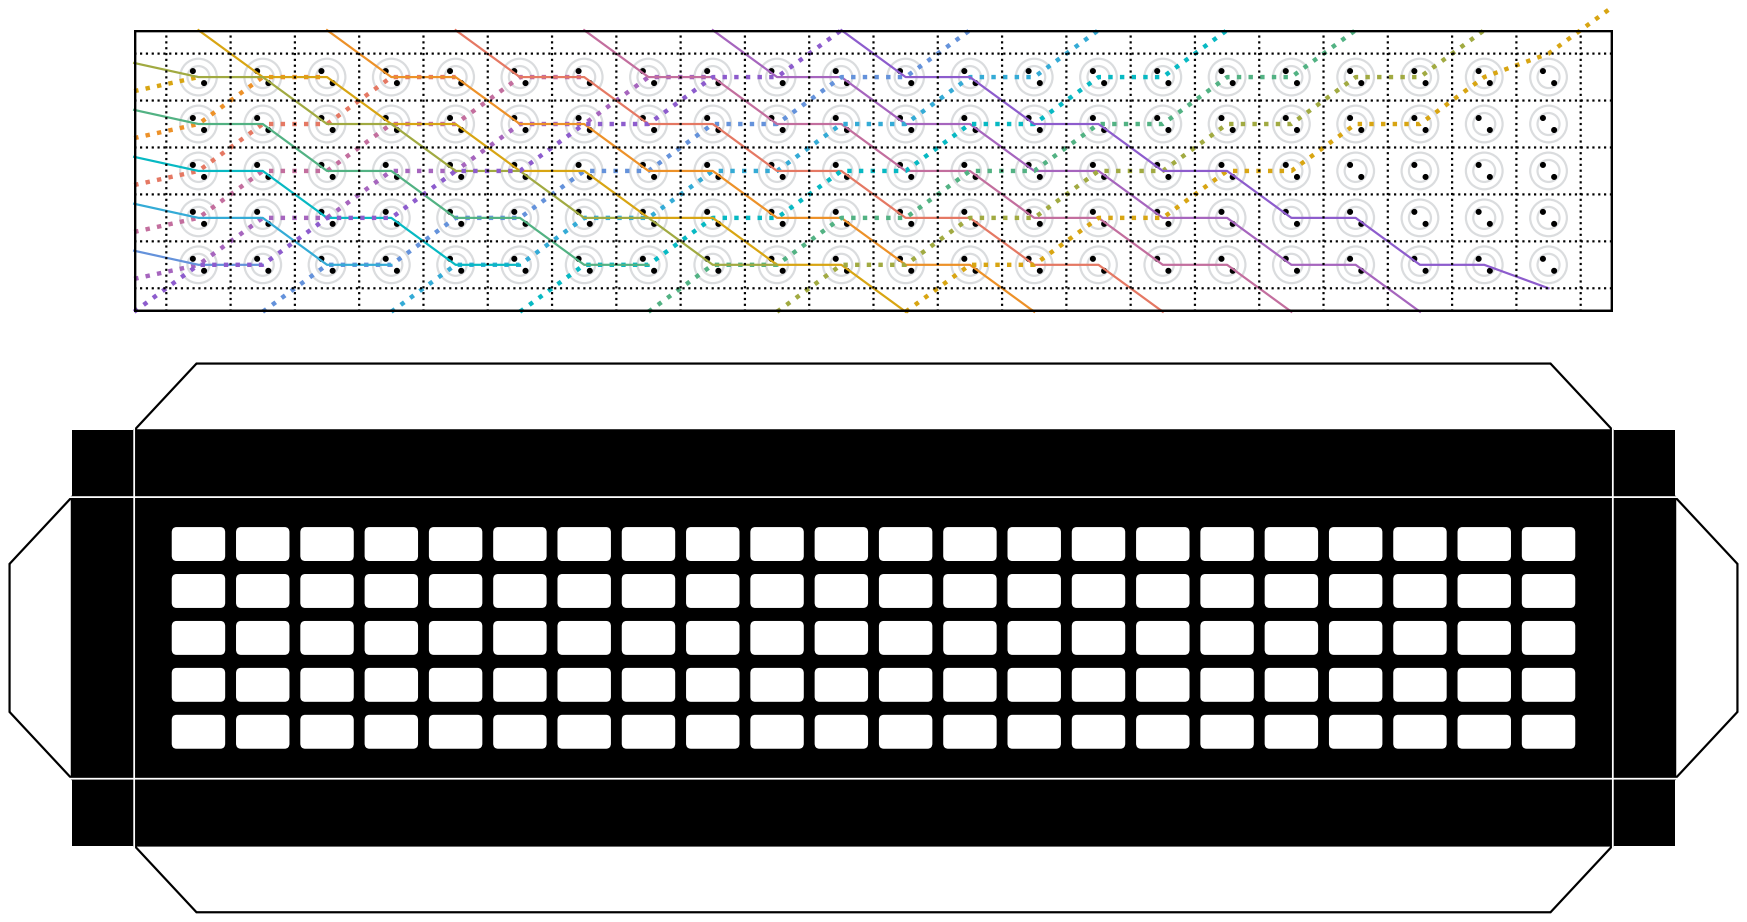
[picture p270: page 1]
