michaelerule/LED_weaving/Project 2: Marquee/Templates/Marquee_17_cartoon.pdf

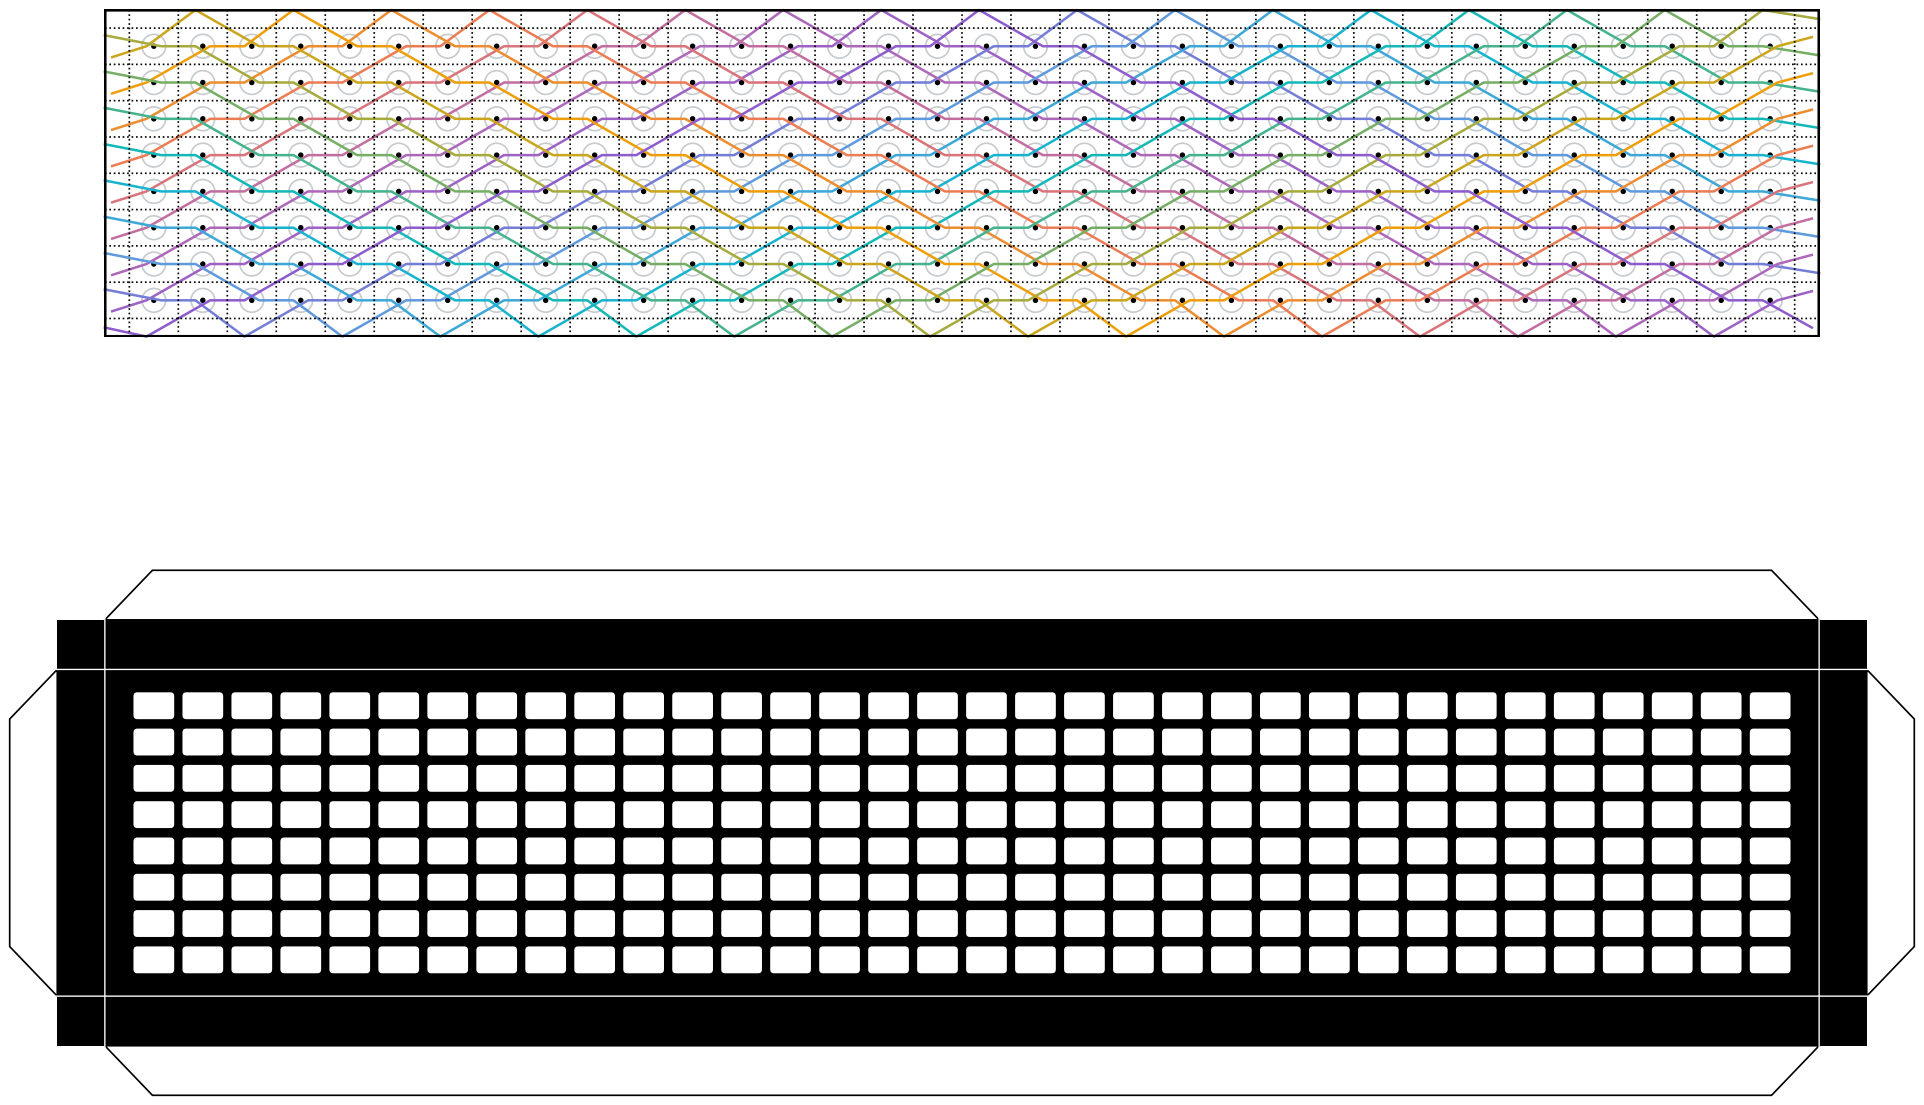
[picture p271: page 1]
