michaelerule/LED_weaving/Project 3: Fibonacci/Templates/Sunflower_12_132_LEDs.pdf

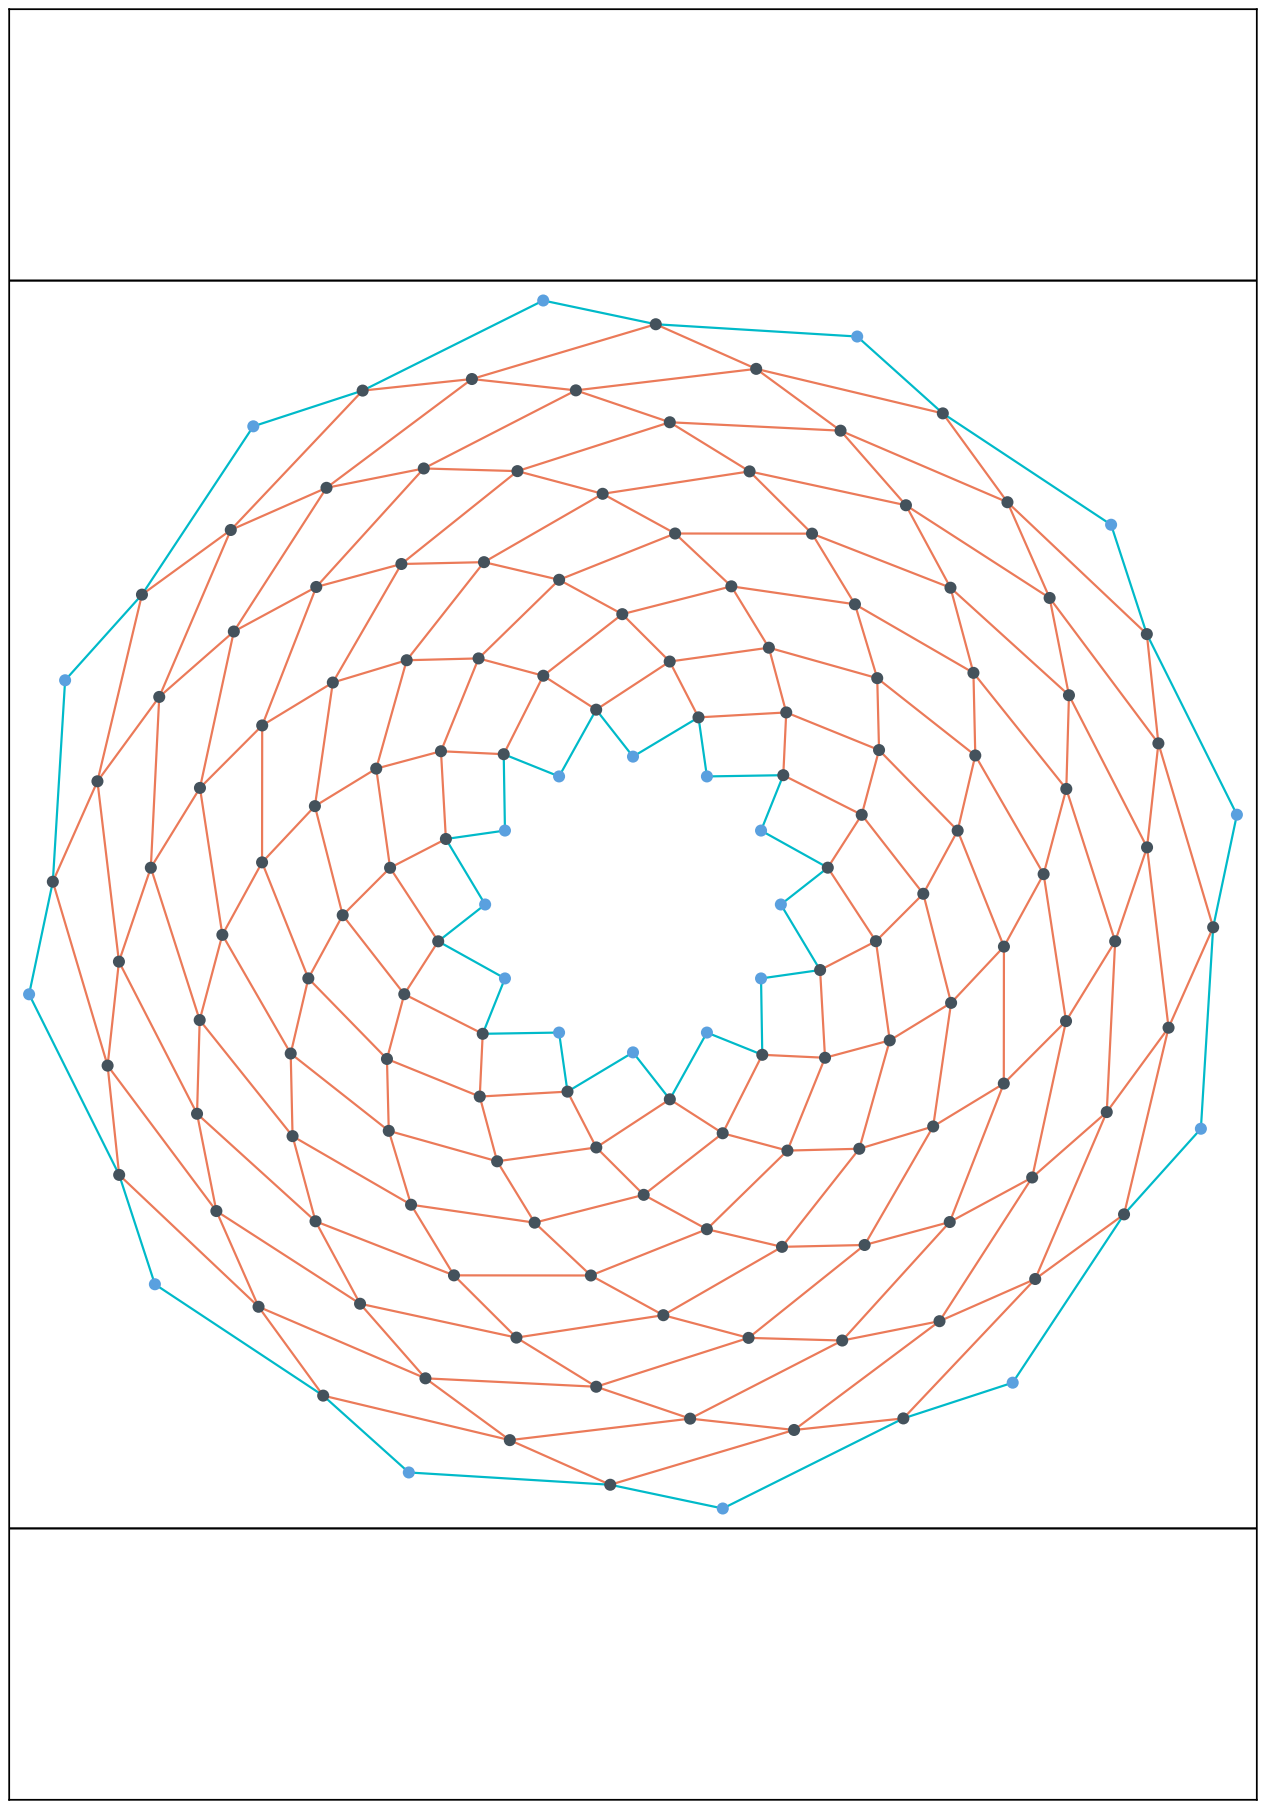
[picture p272: page 1]
