michaelerule/LED_weaving/Project 3: Fibonacci/Templates/Sunflower_18_306_LEDs_left.pdf

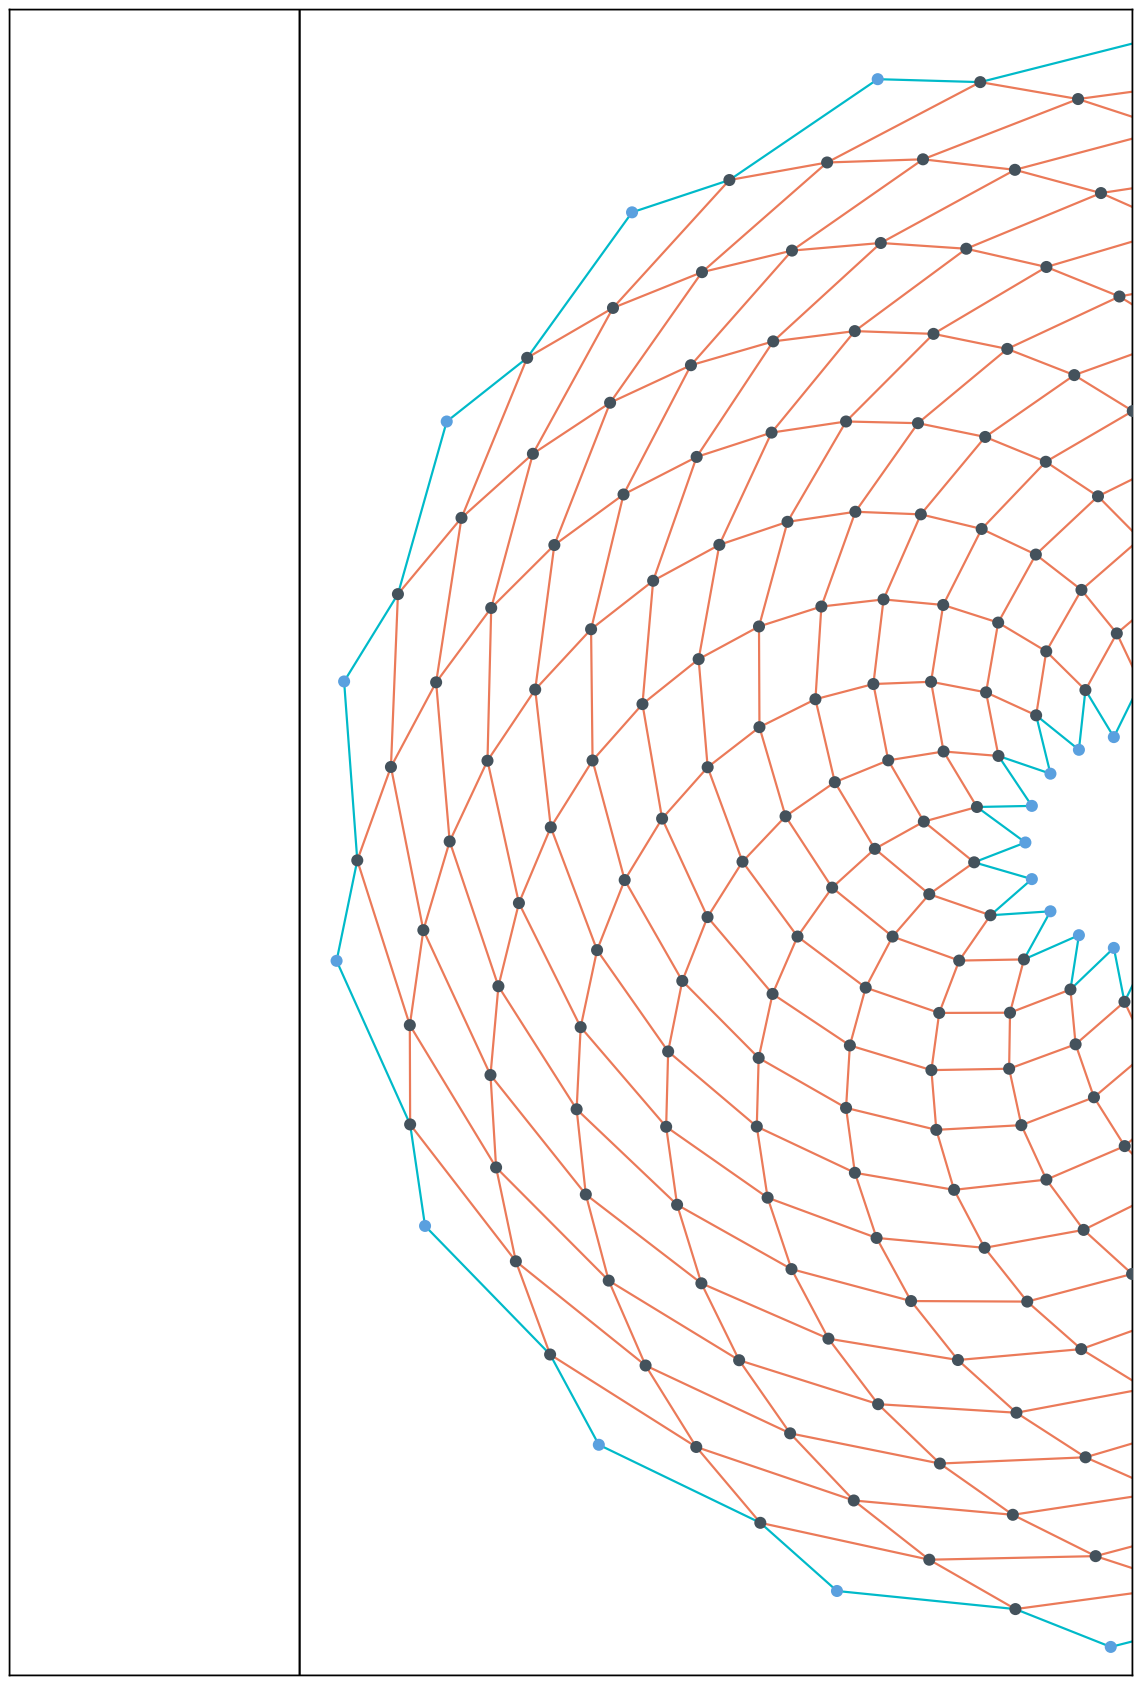
[picture p273: page 1]
