michaelerule/LED_weaving/Project 3: Fibonacci/Templates/Sunflower_18_306_LEDs_right.pdf

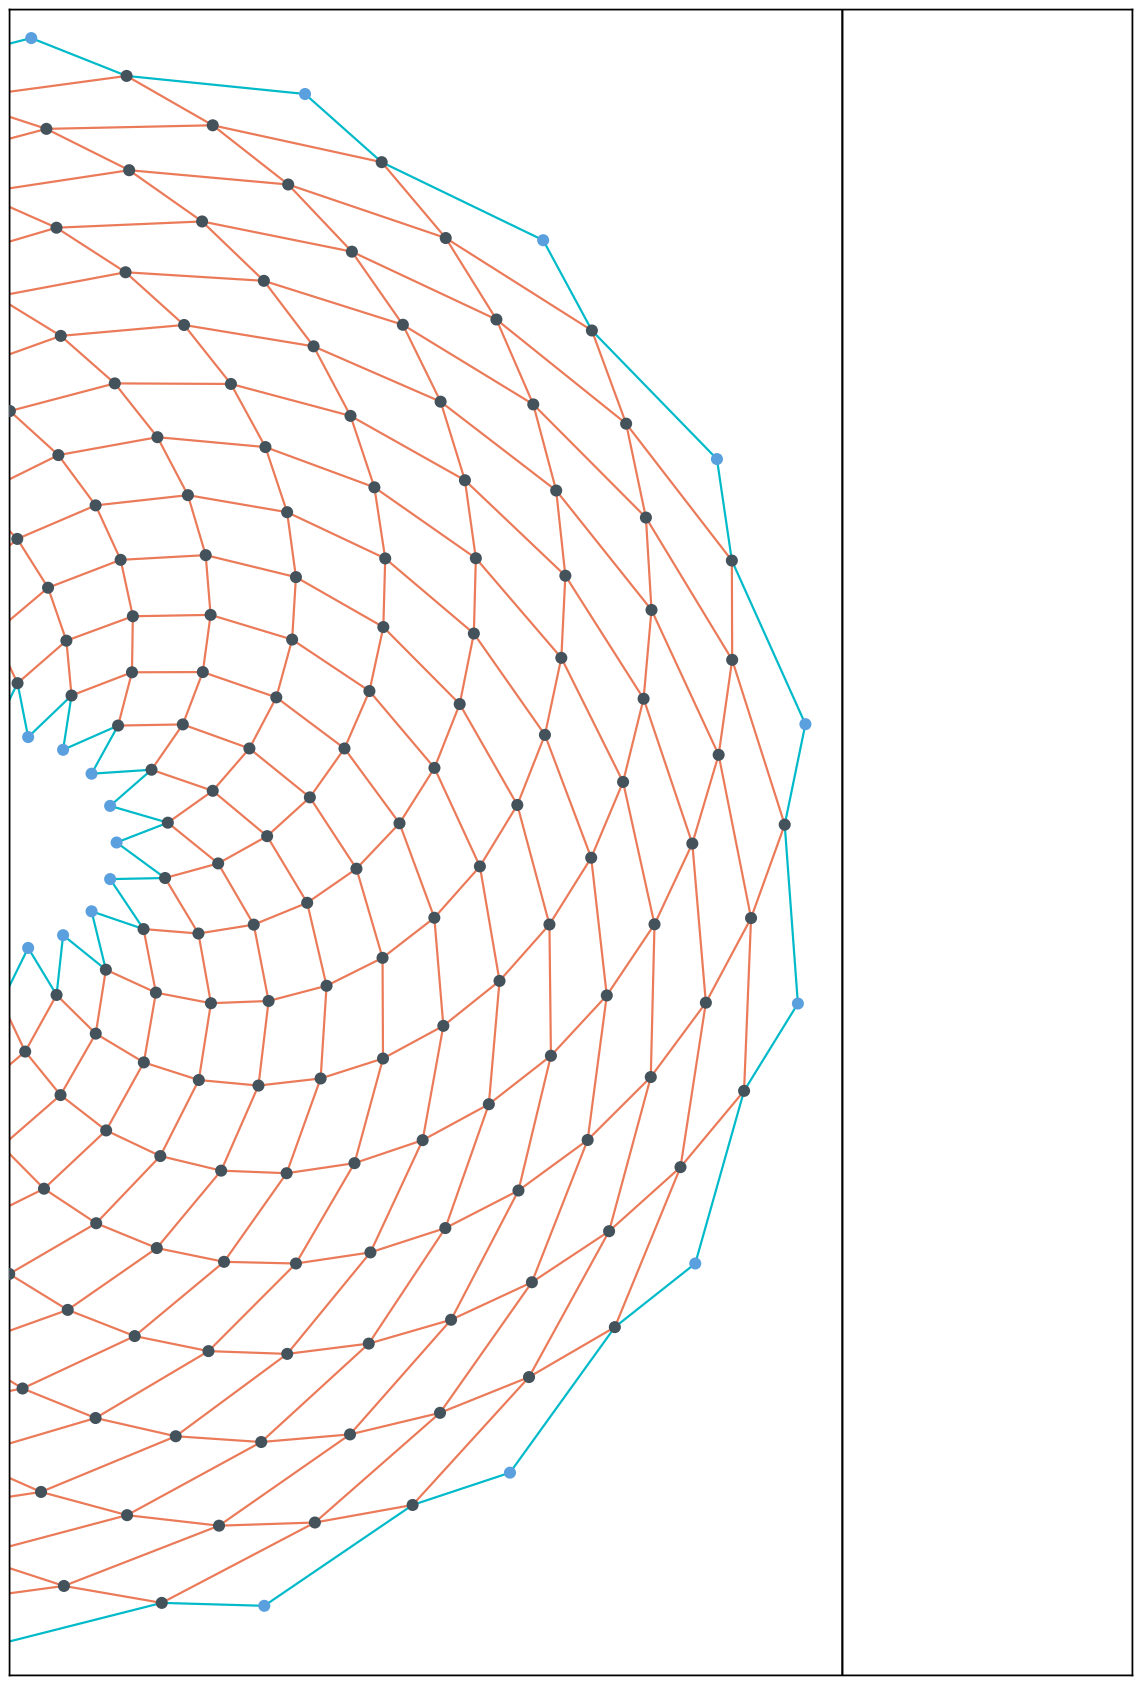
[picture p274: page 1]
