michaelerule/LED_weaving/Project 3: Fibonacci/Templates/Sunflower_6_30_LEDs.pdf

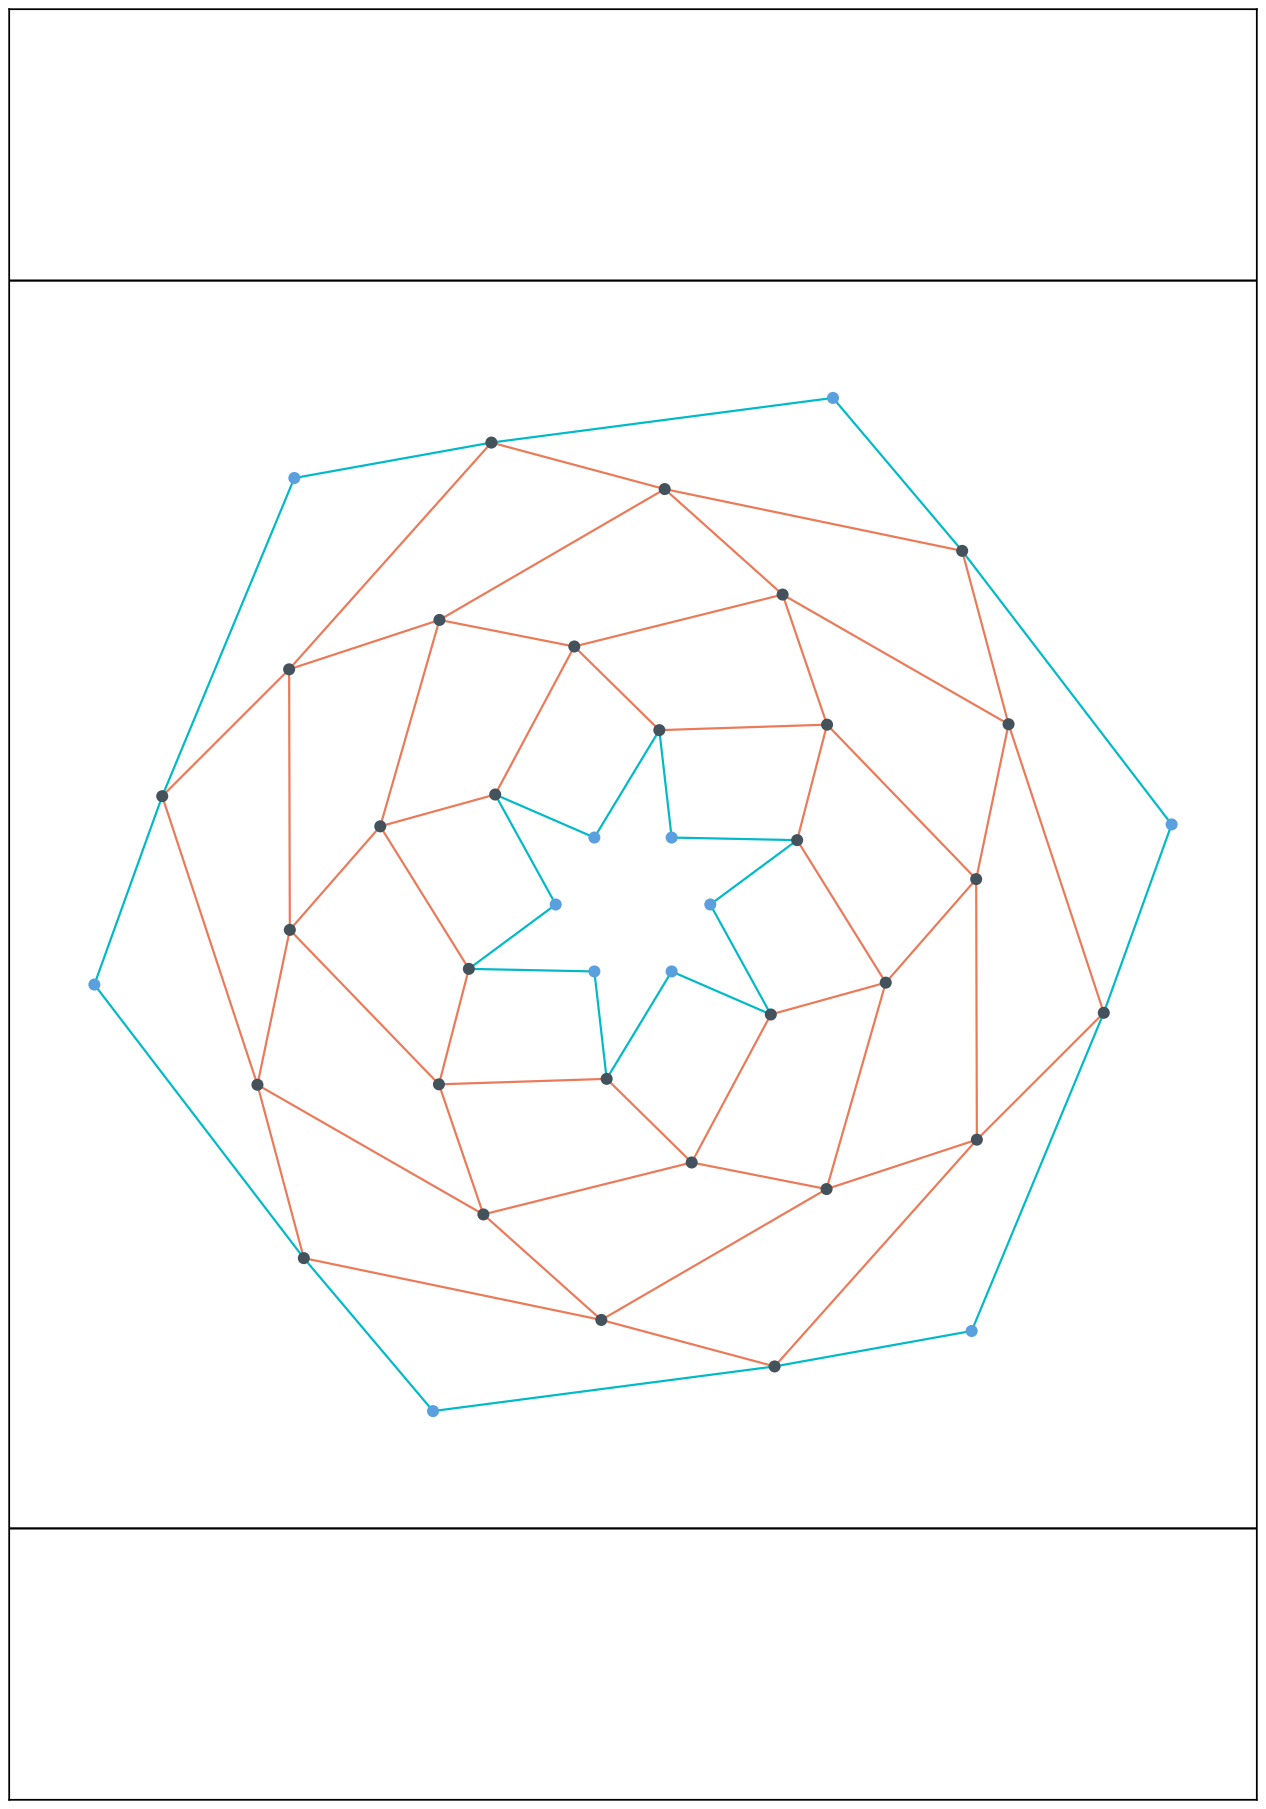
[picture p275: page 1]
