michaelerule/LED_weaving/Project 1: Bead Weaving/Writeup/led_illustration.pdf

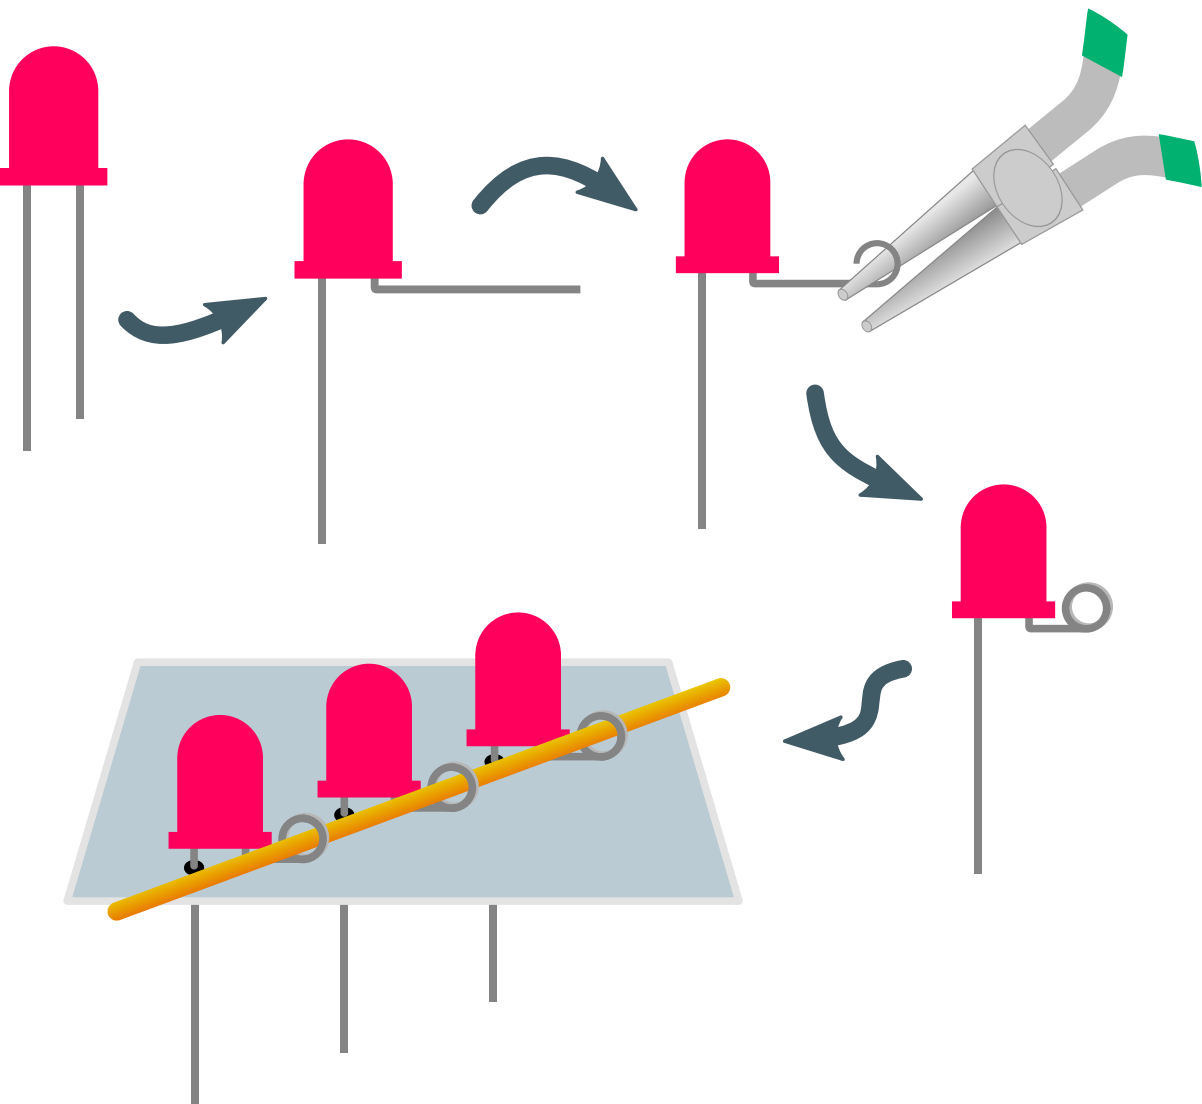
[picture p276: page 1]
