michaelerule/LED_weaving/Project 3: Fibonacci/Templates/20190104_Dreamcatcher_6.pdf

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

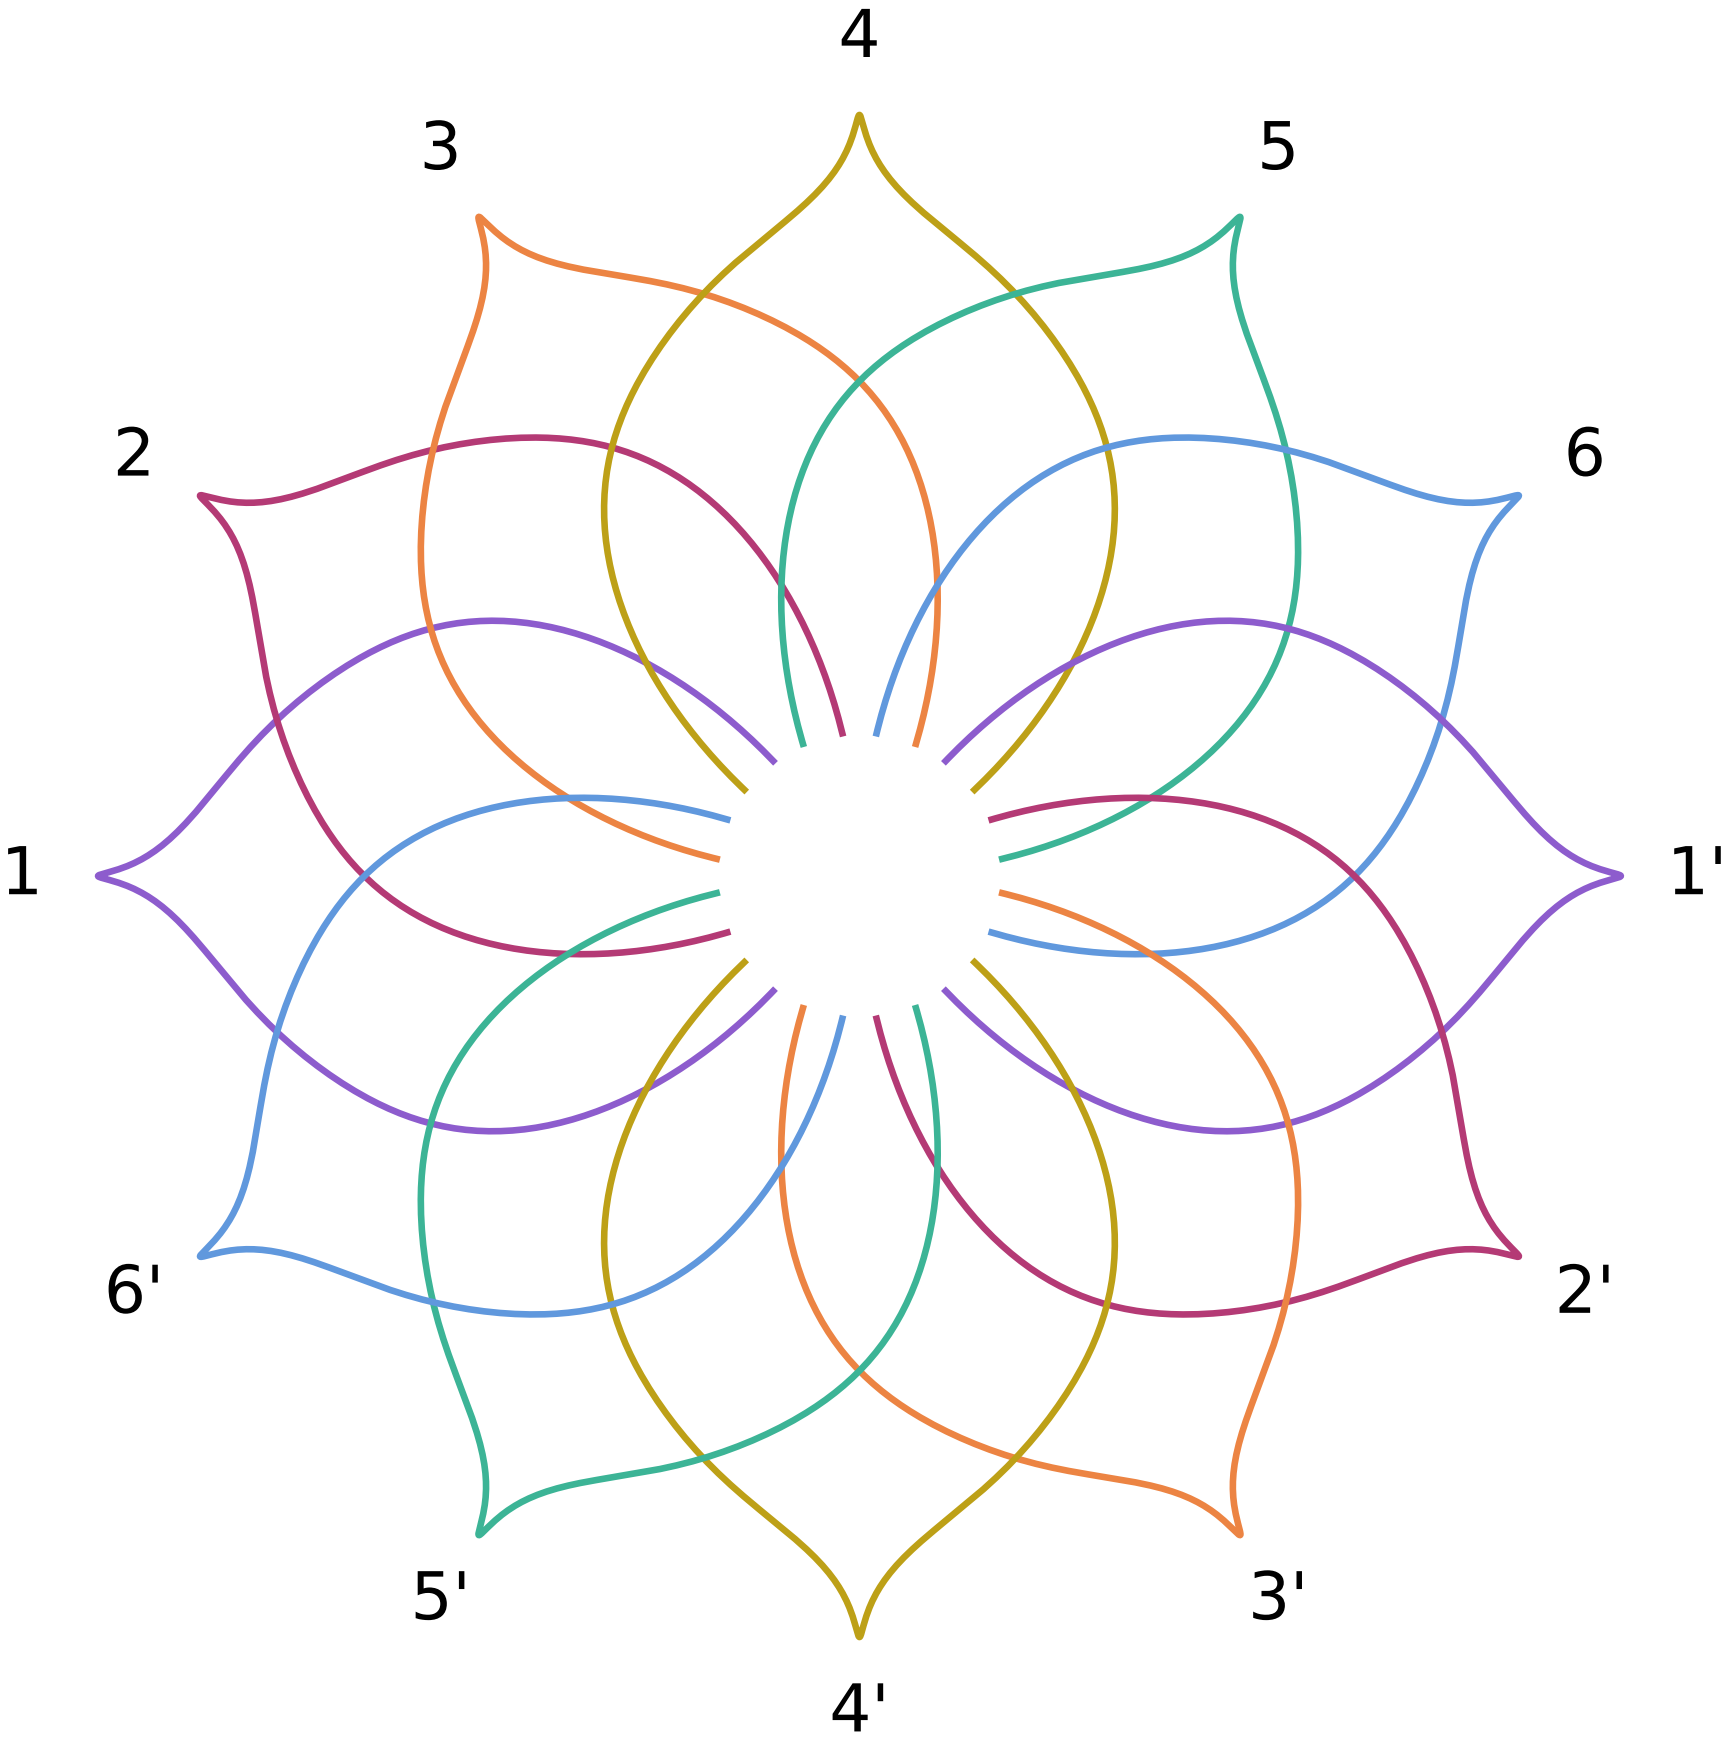
[picture p281: page 1]
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
