michaelerule/LED_weaving/Writeup/Figures/.pdf

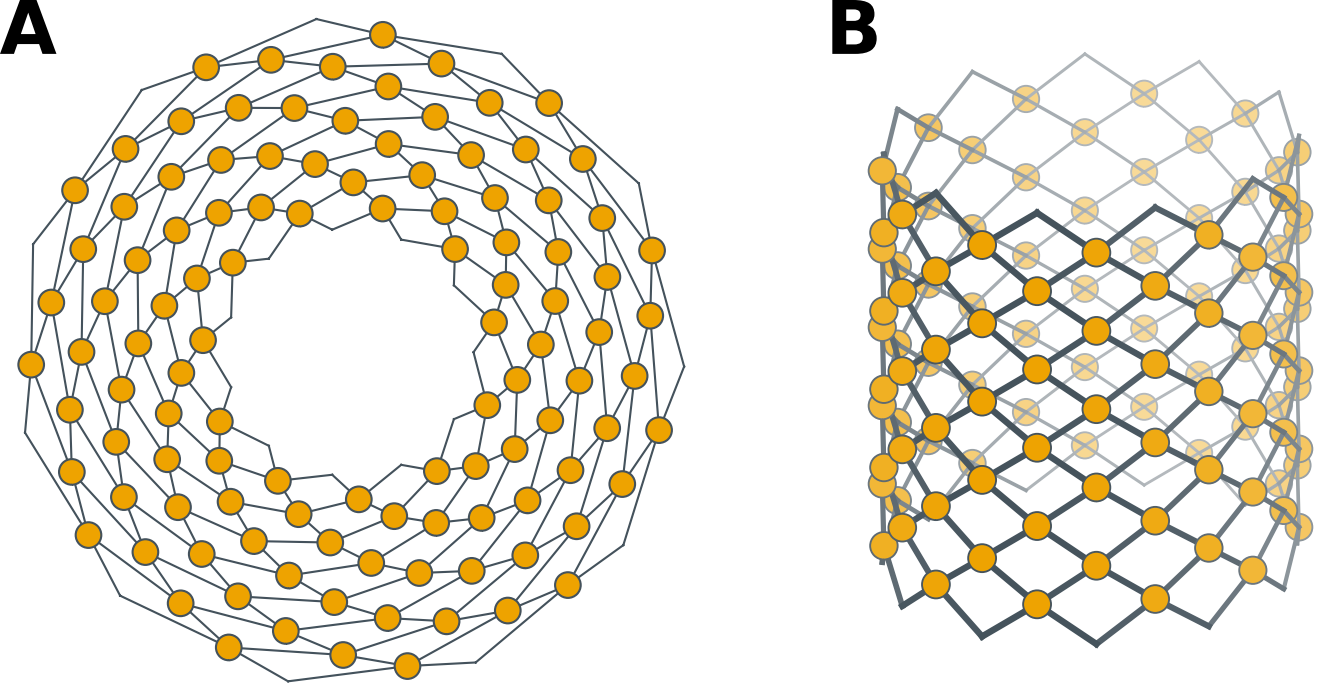
[picture p285: page 1]
