michaelerule/LED_weaving/Writeup/Figures/figure_1_charliemux.pdf

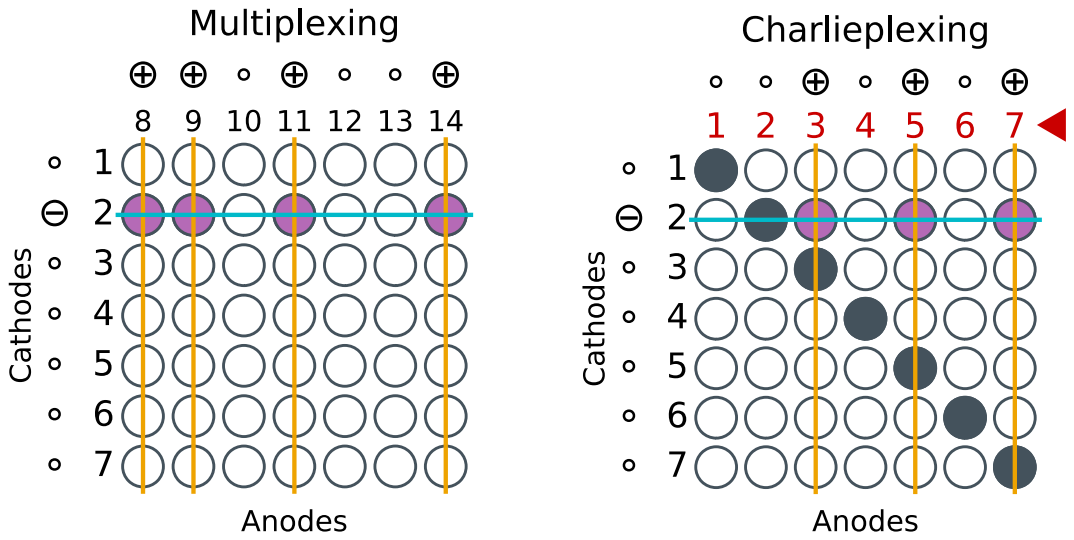
[picture p286: page 1]
