michaelerule/LED_weaving/Writeup/Figures/figure_2_diagmux.pdf

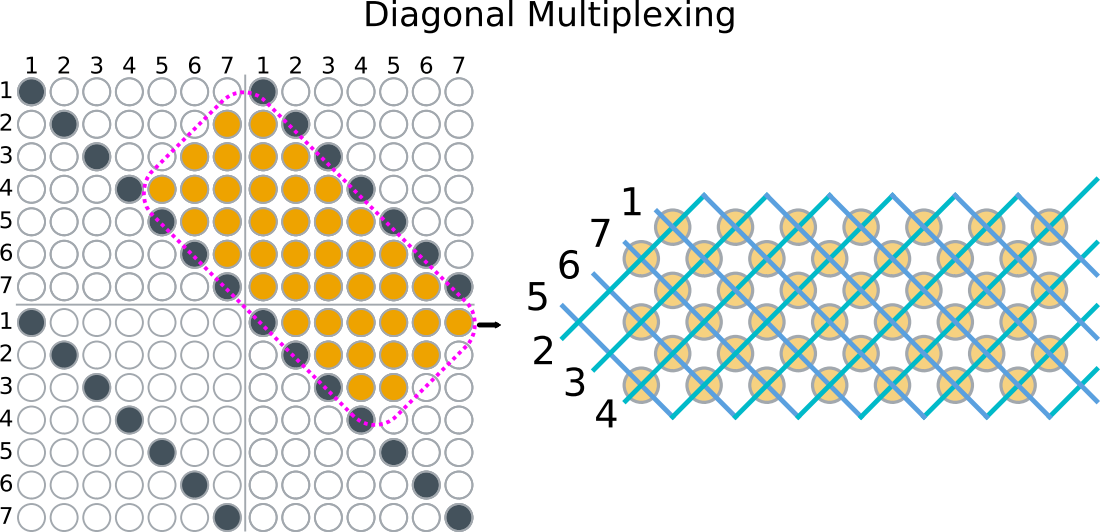
[picture p287: page 1]
