michaelerule/LED_weaving/Writeup/Figures/figure_3_rgbmux.pdf

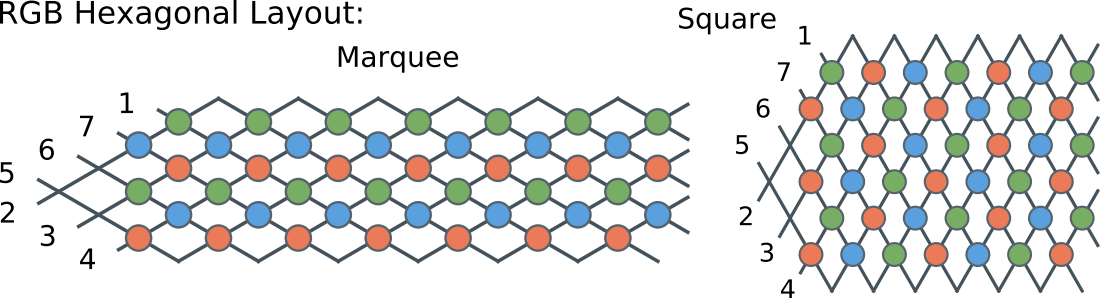
[picture p288: page 1]
