michaelerule/LED_weaving/Writeup/Figures/figure_3_v2.pdf

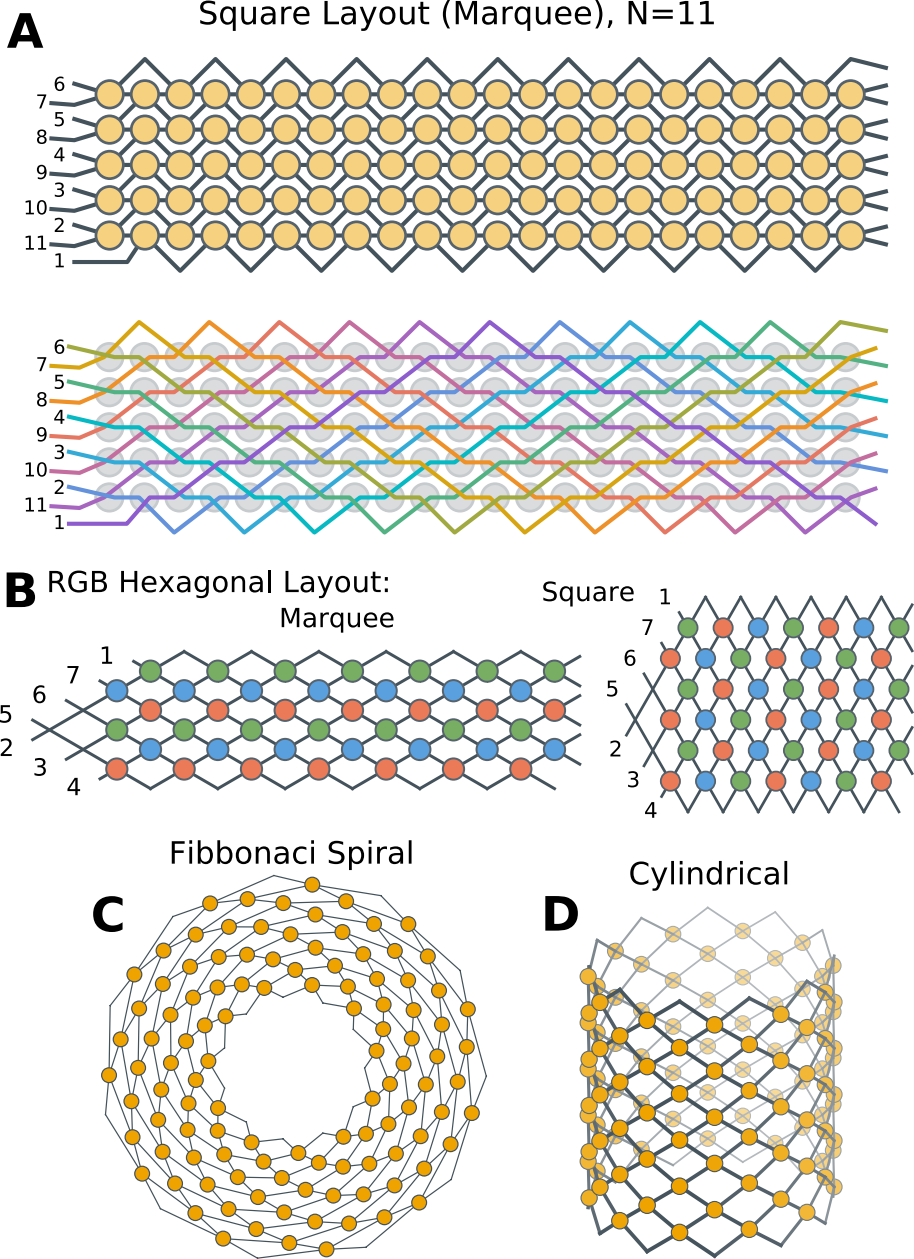
[picture p289: page 1]
