michaelerule/LED_weaving/Writeup/Figures/figure_4_squaremux.pdf

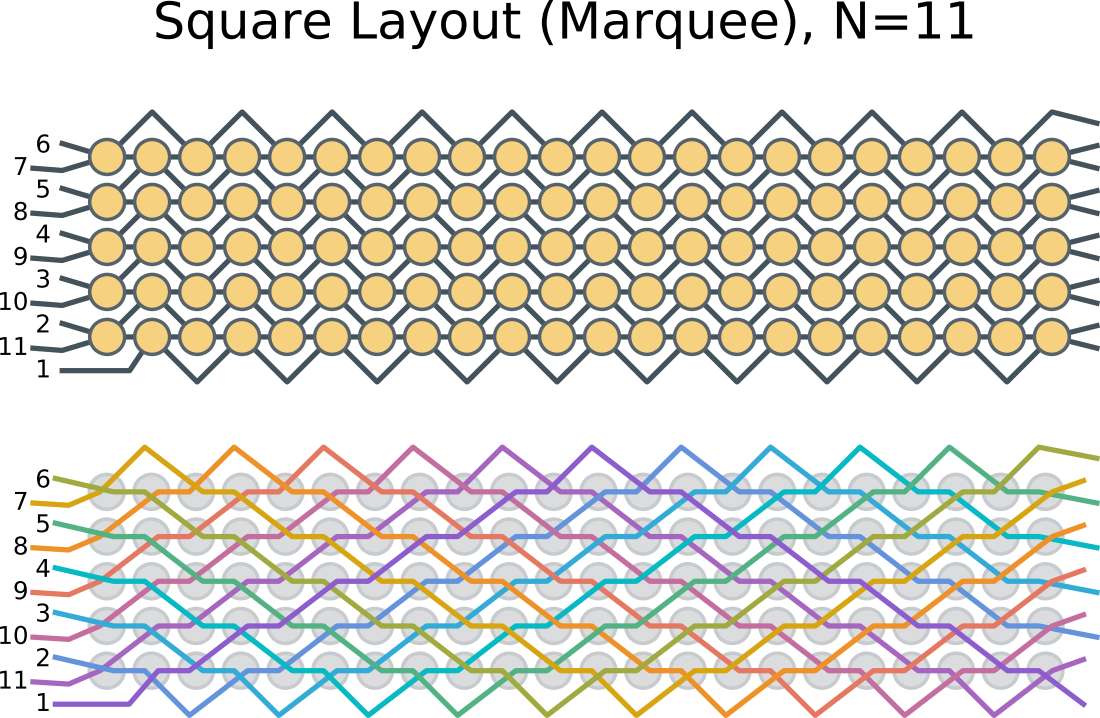
[picture p290: page 1]
