michaelerule/LED_weaving/Project 3: Fibonacci/Writeup/Figures/20190206_Sunflower1.pdf

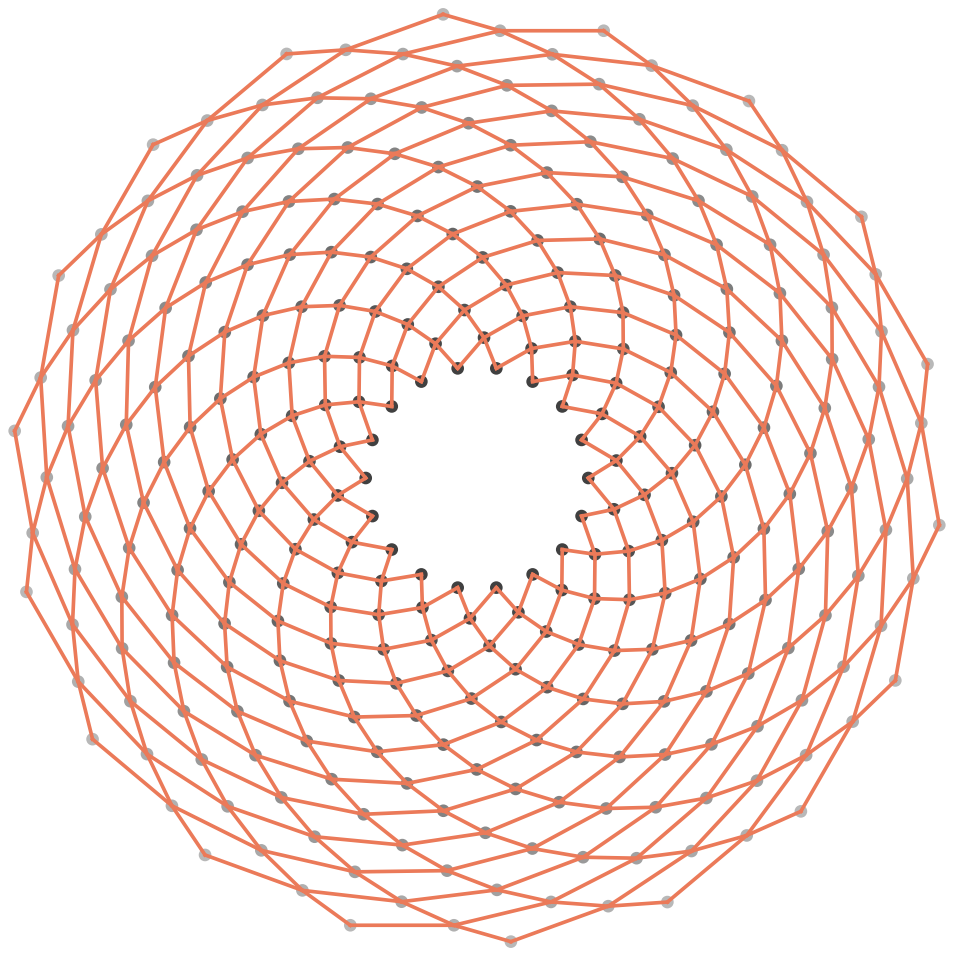
[picture p291: page 1]
