michaelerule/LED_weaving/Project 3: Fibonacci/Writeup/Figures/20190207_Sunflower_illustration.pdf

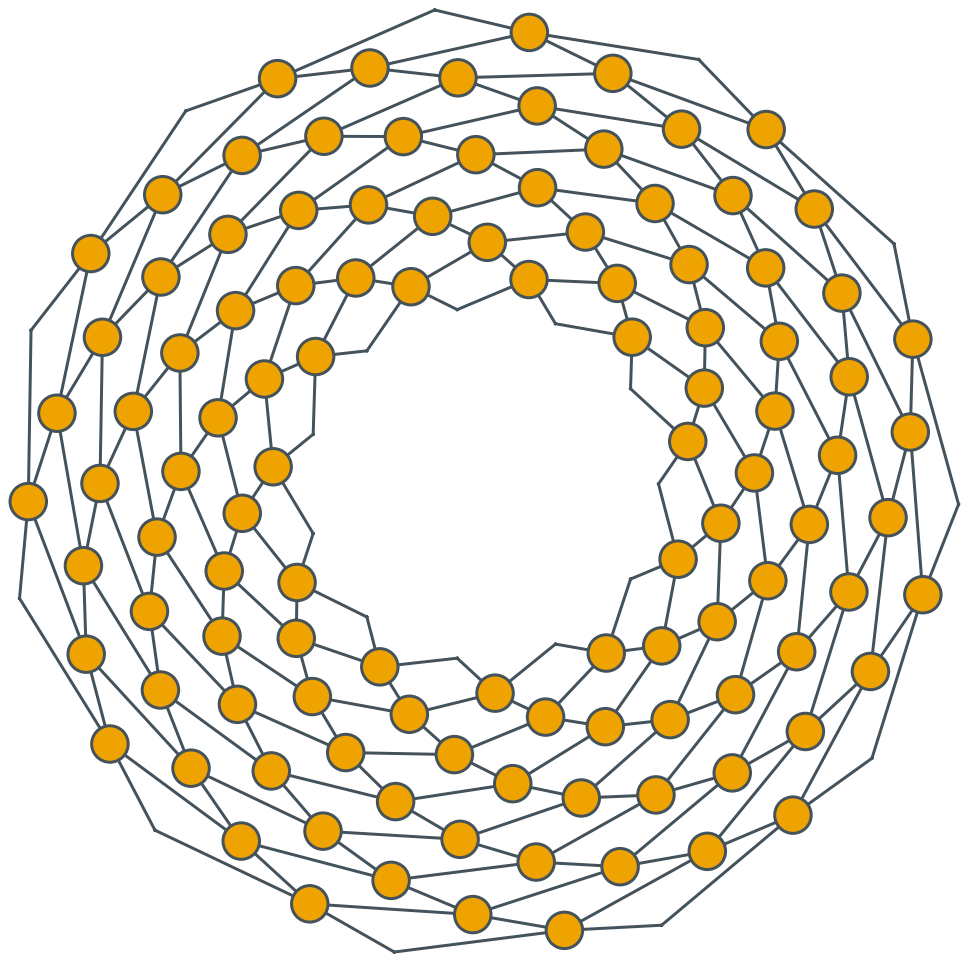
[picture p292: page 1]
