michaelerule/LED_weaving/Project 3: Fibonacci/Writeup/Figures/20190207_Sunflower_illustration_cylinder.pdf

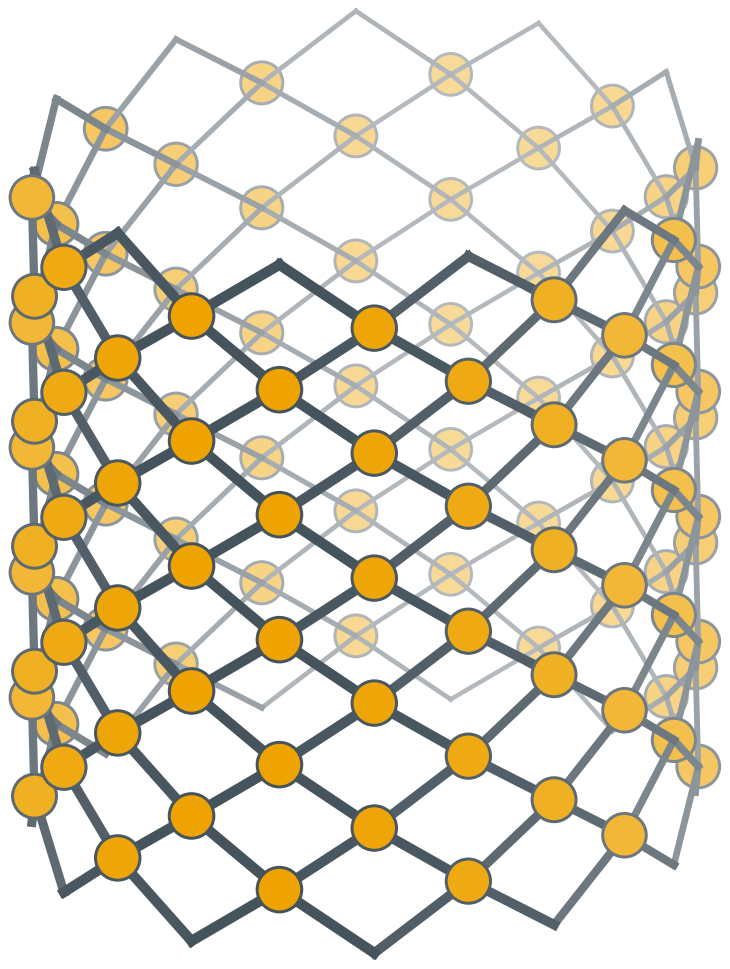
[picture p293: page 1]
