michaelerule/LED_weaving/Project 3: Fibonacci/Writeup/Figures/20190208_Sunflower_left.pdf

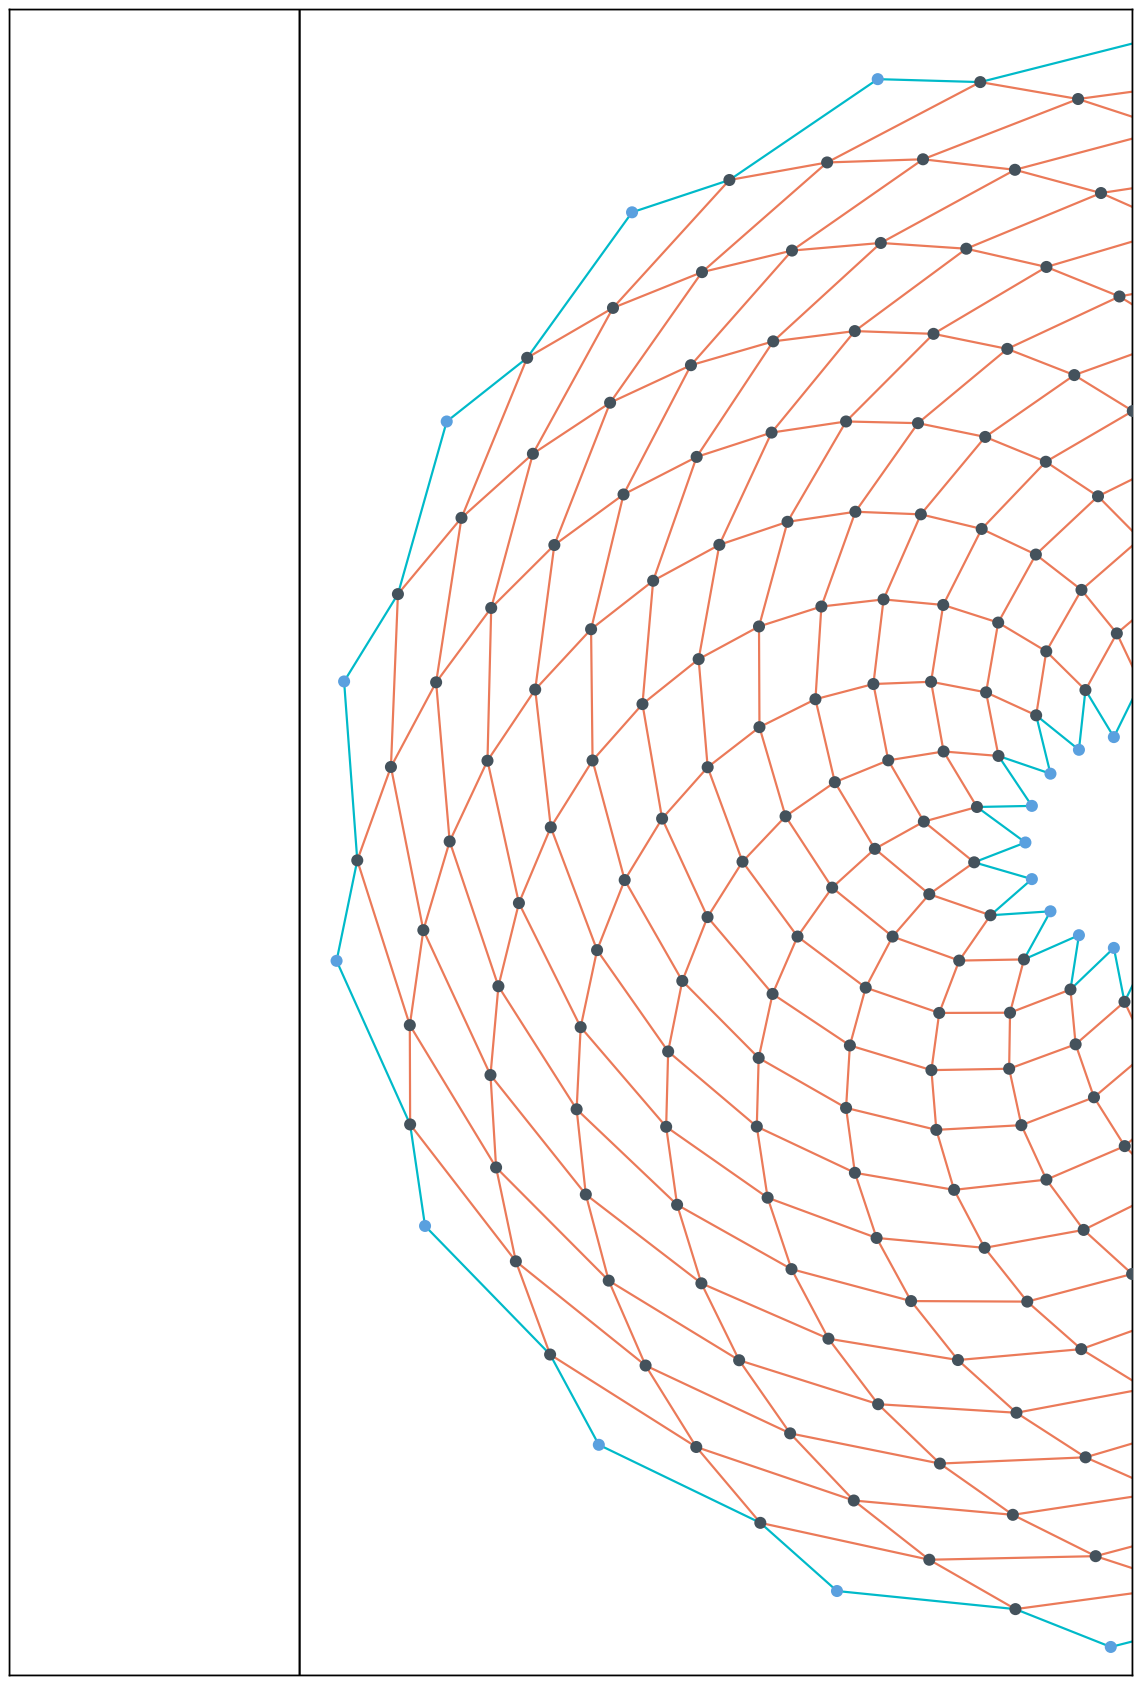
[picture p294: page 1]
