michaelerule/LED_weaving/Writeup/figures/pdf/20190205_LED_handcraft_multiplexing_figure_32.pdf

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

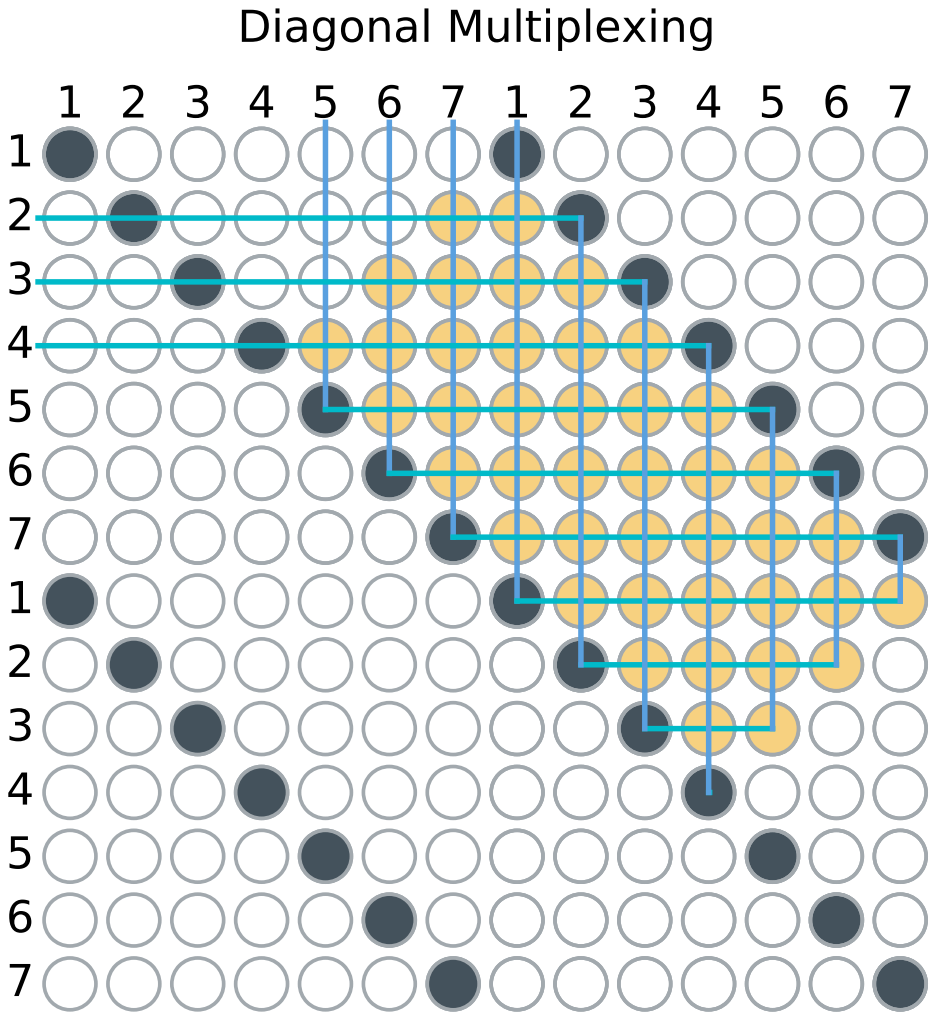
[picture p316: page 1]
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
