michaelerule/LED_weaving/Other/Development/weaving/csew_layout_test.sch

## EAGLE design Other/Development/weaving/csew_layout_test.sch (2019-02-10)

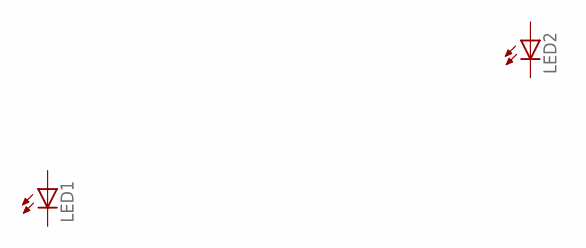
[picture p320: schematic csew_layout_test.sch]

Parts:
LED1, LED2: LEDSML0603; SML0603
