michaelerule/LED_weaving/(commit log)

2019-02-10 populate directory structure
    Former-commit-id: 54c34bd28f6eb3f2a3506b525b0647a285c0f0a7
    [LED.scad, LED2.scad, csew_layout_test.brd, csew_layout_test.sch]
2019-02-10 populate directory structure
    [LED.scad, LED2.scad, csew_layout_test.brd, csew_layout_test.sch]
2019-02-12 add templates for paper marquee project
    Former-commit-id: 87f6a2bffafcf415f8aafbbb519f6d0d6e6f4106
    [LED.scad, LED2.scad, csew_layout_test.brd, csew_layout_test.sch]
2019-02-12 add templates for paper marquee project
    [LED.scad, LED2.scad, csew_layout_test.brd, csew_layout_test.sch]
2019-02-18 draft Arduino sketches for 11-line marquee project
    Former-commit-id: e15355839ccfd37438da0707057084c889ce9a34
2019-02-18 draft Arduino sketches for 11-line marquee project
2019-02-24 add some photos; working on sketchs for project 2; code for uploading bitmap fonts on Arduino
    Former-commit-id: ab7e8ae6a0c3922a8c0b90b82aeb0b46df662063
    Former-commit-id: 53590878e2a2e3dfc808c7adf387cf9e9cdc4719 [formerly 37307de862f7cfe683483d55e8458574fe981c60] [formerly ef026a0a6b5c55375d7b60ea542e32d611c7db50 [formerly cdd6723a16975377ecd6a3eb9c28e03fa1173549]]
    Former-commit-id: 4e97973de9875cd0cbaac6d8ab5fee000b1408d1 [formerly 6854c88797ac89e962c21c612f8e4fc4ea67e831]
    Former-commit-id: e13150f87398bc4146c9a577af1021da47048f60
    Former-commit-id: 22460bb8b740203ae129f0639187af8c2aea1710
    [LED.scad, LED2.scad, csew_layout_test.brd, csew_layout_test.sch]
2019-02-24 add some photos; working on sketchs for project 2; code for uploading bitmap fonts on Arduino
    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
    [LED.scad, LED2.scad, csew_layout_test.brd, csew_layout_test.sch]
2019-02-25 remove videos; (take up too much space)
    Former-commit-id: 6ce887351aa41fb92a9273f40528b9e03c599b28
    Former-commit-id: fc1bc417008256c017a071baef64cd38ee8300cf [formerly 26295514cad49861548abf7dfb98bcc690cee54c] [formerly d664ec30107b0e4a4e2c184f9d086043edb2604e [formerly 2441599f9db8a4d5533a8808f76bed9569e97f4d]]
    Former-commit-id: 7b8f3332880e34010521219f348141f8fe8b3f53 [formerly 6750b8fbcf314ef4cfa1f5ed90843d1bf7a16eaa]
    Former-commit-id: 752271d7f8a69c15ff460ad86979df5a3d1459a8
    Former-commit-id: 0bae6ecad6a3a5040ea58394d1edbffa5afbc4c9
    [message.h, pipe_to_serial.py, png2int.py, prepare_c_datastructures.py, scroll_message.py, sketch_6_scroll_stored_message_double_buffer.ino]
2019-02-25 remove videos; (take up too much space)
    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
    [message.h, pipe_to_serial.py, png2int.py, prepare_c_datastructures.py, scroll_message.py, sketch_6_scroll_stored_message_double_buffer.ino]
2019-02-25 remove large files from history
    Former-commit-id: aedcd762a18dd49cea6fe642a73398efda86ddc7
    [752271d7-HEAD.csv]
2019-02-25 remove large files from history
    [752271d7-HEAD.csv]
2019-12-09 writeups added
    Former-commit-id: 1522872a14b27b05042b3e205af8205094e593c3
    Former-commit-id: 71552db43fe1bb510d96db1c0654aa5b53b42366
    Former-commit-id: 61a94d7bab0a2560112d59a42cf49cb7ad224a1f
    [cc569d0e-HEAD.csv]
2019-12-09 writeups added
    Former-commit-id: c1cb57e48a9aa5c521b8e8a4b40fc07cc3731519
    Former-commit-id: eef85ea6c431c63fd64f19e06576243e8b229155
    [1522872a-HEAD.csv]
2019-12-09 ...
    Former-commit-id: 40e01bf664bbbc20b6c9d3306b6692a8c706b775
    Former-commit-id: 14c178e9bbc8e360eb388c59971031c3f867e5fa
    [a6e3df48-HEAD.csv]
2019-12-10 ...
    Former-commit-id: 6e8e2b42b43c11aedabd6032ef69c99ccefe13e4
    Former-commit-id: f51d897d612e6a0438debfab70013657170a8f2a
    [40e01bf6-HEAD.csv]
2019-12-10 ...
    Former-commit-id: 832d3ba05b9089bb88d0f9b944e4ea58161c074f
    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
    [40e01bf6-HEAD.csv]
2020-03-28 ...
    Former-commit-id: f6025158baad3211c4b44e2e76265bbba028c979
    Former-commit-id: f5bbcd8a409fabcd63ba010f40bc9e2642309249
    [6e8e2b42-HEAD.csv, LED.scad, LED2.scad, csew_layout_test.brd, csew_layout_test.sch, f51d897d-HEAD.csv]
2020-03-28 ...
    Former-commit-id: f196898f9d960cfdbf4b8602f103cc7688a46f0a
    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
    [6e8e2b42-HEAD.csv, LED.scad, LED2.scad, csew_layout_test.brd, csew_layout_test.sch, f51d897d-HEAD.csv]
2020-03-28 ...
    Former-commit-id: 0ac5ffc36d1c8814c6246a2fceebba43d46d12a2
    [f5bbcd8a-HEAD.csv, f6025158-HEAD.csv]
2020-03-28 ...
    Former-commit-id: 3c77472fc06b7b5612713be597e9ee0d9942bedd
    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
    [f5bbcd8a-HEAD.csv, f6025158-HEAD.csv]
2020-03-28 ...
    Former-commit-id: 0e97c7d50013912205736345c10054d5dcaf2221
    [d19214ed-HEAD.csv]
